raisemanface/gnss-signal-monitor/docs/接线表.md

# 双板接线表 + 彩色杜邦线配色方案（2026-10-15 · v2 按排线色序重排；2026-10-22 · v2.2 官方重排；2026-10-25 · v2.3 DS3231 接入；2026-10-26 · v2.4 背光改 GPIO7）

> **用途**：换标准彩色杜邦线时照这张表接；接完用最后一节的清单自检。
> **来源**：`README-交接（笔记本继续）.md` §5（权威接线表）+ `User_Setup_GNSS_Bench.h` +
> `TFT_eSPI/User_Setups/Setup_C3_CmdPad.h` + 两份固件里的引脚常量 —— **逐项核对过，非推测**。
> ⚠ 本表**取代** README §5 中"C3↔S3 链路 = GPIO8/5"那一段（2026-10-14 起链路脚已回 **C3 20/21**）。
>
> ★ **v2（2026-10-15 19:5x，用户指出）**：标准彩排线是**固定色序**，v1 里"蓝 / 绿 / 黑"这一组
> **在排线上根本不相邻**、物理上撕不到一起 ⇒ 整表**按排线色序重排**：
> **链路改成 白 - 黑 - 棕（黑居中屏蔽）**、**片选从 白 改 灰**。
> v1 的配色（蓝/绿链路 + 白片选）**全部作废**，不要再用。
>
> ★ **v2.1 补充（2026-10-15 20:5x）**：**S3 侧链路脚 38/39 → 43/44**（官方 U0 那对），
> 与 C3 的 20/21 配对 —— 见 §四。配色、根数、自检清单**均不受影响**（脚号与颜色是两回事）。
>
> ★★ **v2.2（2026-10-22，官方重排）**：S3 侧引脚按乐鑫官方焊盘功能重新落位，**动的只有 6 根**：
> ① 触摸 T_CS **9→14**（官方 FSPIWP 焊盘）；② SHT30 SCL **7→9**（官方 Wire 默认对 8/9）；
> ③ GNSS 模块 TXD **16→18**（官方 U1RXD）+ PPS **18→16**（对调）；
> ⑤⑥ 链路 **43/44 → 40/39**（把 U0 还给板载转串口芯片，Micro-USB 口解放）。
> 配色/色序**一根没变**，变的只是 S3 端落孔。图：`docs/接线图-S3-官方重排-2026-10-22.html`。
> ⚠ C3 板已换 DevKit（2026-10-22，COM5→COM7，MAC 变），**C3 侧 GPIO 编号与接线一根不动**（见 §三备注）。

---

## 一、先认识排线：10 色**固定色序**，而且首尾相接

一包标准彩色杜邦线（彩排线）是 **10 色固定顺序**，而且实际到手是**一束**（第 10 根与第 1 根相邻）：

```
棕(1) → 红(2) → 橙(3) → 黄(4) → 绿(5) → 蓝(6) → 紫(7) → 灰(8) → 白(9) → 黑(10) →（回到棕）
```

**这个顺序改不了**，所以配色不是"想给谁给谁"，而是 —— **先看排线，再把用途塞进排线已有的段落里**。
本表把 10 色切成 **三段**：

| 段 | 颜色（排线位次） | 用途 |
|---|---|---|
| **电源** | **红 (2)** | **+3.3V**，所有模块共用 |
| **信号** | **橙 (3)** · **黄 (4)** · **绿 (5)** · **蓝 (6)** · **紫 (7)** · **灰 (8)** | 全部信号线 —— **连续 6 根**，按模块撕取 |
| **链路 / 地** | **白 (9)** · **黑 (10)** · **棕 (1)** | **黑 = 全部 GND**；**白 + 棕 = C3↔S3 链路**两根信号线；**黑 夹在它俩中间** |

### 1.1 逐色对照表（背下这一张就够）

| 排线位次 | 1 | 2 | 3 | 4 | 5 | 6 | 7 | 8 | 9 | 10 |
|---|---|---|---|---|---|---|---|---|---|---|
| **颜色** | **棕** | **红** | **橙** | **黄** | **绿** | **蓝** | **紫** | **灰** | **白** | **黑** |
| **用途** | 链路② | +3.3V | 控制 DC/RES | 时钟 CLK/SCL | 数据出 MOSI/SDA/TX | 数据入 MISO/RX | PPS 秒脉冲 | 片选 CS/T_CS | 链路① | **GND** |

> ★ 一句话记法：**红电 · 橙控 · 黄钟 · 绿出 · 蓝入 · 紫秒 · 灰选 · 白棕链 · 黑地。**
>
> ★ **绿 / 蓝 = 方向，不是模块**：同一个模块上，**发给它的走绿、它发来的走蓝**（本机 TX = 绿、本机 RX = 蓝）。
>
> ★ **这三段为什么这么切（不是拍脑袋）**：
> 1. **黑 在排线上只与 白、棕 相邻** ⇒ 想让 **GND 夹在两根信号线中间**（屏蔽 C3↔S3 那对长线的串扰），
>    **只有 白-黑-棕 这一种选法**，其它任何组合都做不到。
> 2. **屏 SPI 的三根主干 CLK / MOSI / MISO = 黄 绿 蓝 = 排线上紧挨着的 3 根** ⇒ 撕一小段正好够，
>    而且**时钟（黄）正好夹在两根数据线中间**，对 20 MHz 的 SPI 更稳。
> 3. **红(2) 与 黑(10) 分别位于排线两端** ⇒ **"电源 + 地成组"物理上做不到**，只能让**电源独占 1 根**、
>    **地并进链路那一束**（每个模块的 GND 都走黑线，同一束里顺路走）。
>
> ⚠ **不同厂家偶有色序差异**（有的套装会多一根"青"）—— **以你手上那包的实物排列为准**，摊开看一眼再撕。

---

## 二、S3 台架（ESP32-S3-DevKitC-1 v1.1）

### 2.1 屏 ILI9341 + 触摸（SPI，6 + 2 根）

| 颜色 (位次) | 屏脚 | S3 脚 | 说明 |
|---|---|---|---|
| **黄** (4) | CLK | **GPIO12** | 时钟 |
| **绿** (5) | MOSI | **GPIO11** | 数据出 |
| **蓝** (6) | MISO | **GPIO13** | 数据入，**触摸要用这条回线，必须接** |
| **灰** (8) | CS | **GPIO10** | 屏片选 ★ v2：**白 → 灰** |
| **橙** (3) | DC | **GPIO6** | 数据/命令选择 |
| **橙** (3) | RES | **GPIO4** | 屏复位 |
| **白** (9) | BLK | **GPIO7** | ★ **v2.4（2026-10-26）背光改 PWM 调光，不再接 3.3V** —— P9 实验坐实：全亮 66 mA / 熄屏 0.3 mA（省 99.5%），`bl 0` 能真黑。旧写法「BLK→3.3V 常亮」**作废** |
| **灰** (8) | T_CS | **GPIO14** | 触摸片选 ★ v2.2：**9 → 14**（官方 FSPIWP 焊盘，与屏 SPI 集群 J1-16..20 连成一排） |
| — | T_IRQ | **不接** | 触摸中断，轮询方式；**实测两板均未接、运行正常（2026-10-16 定案）** |
| **红** (2) | VCC | **3V3** | **实测 3.3V 正常**（屏背光专线未接、显示正常 —— 2026-10-16 定案，见 §七.4） |
| **黑** (10) | GND | **GND** | |

### 2.2 GNSS 模块 ATGM336H-5N（UART1 + PPS）

| 颜色 (位次) | 模块脚 | S3 脚 | 说明 |
|---|---|---|---|
| **蓝** (6) | **TXD**（模块发） | **GPIO18** | 芯片的**入** ⇒ 蓝 ★ v2.2：**16 → 18**（官方 U1RXD 焊盘，J1-11） |
| **绿** (5) | **RXD**（模块收） | **GPIO17** | 芯片的**出** ⇒ 绿（只收不发时可不接；官方 U1TXD，不动） |
| **紫** (7) | **PPS** | **GPIO16** | 1Hz 秒脉冲 ⇒ 紫 ★ v2.2：**18 → 16**（与上行对调；换完三根在 J1-9/10/11 连续） |
| **红** (2) | VCC | **3V3** | **标称即 3.3V**（官方手册：2.7~3.6V，典型 3.3V，上限 3.6V；<25mA@3.3V）—— 2026-10-16 定案 |
| **黑** (10) | GND | **GND** | |

### 2.3 SHT30-D 温湿度（I2C）

| 颜色 (位次) | SHT30 脚 | S3 脚 |
|---|---|---|
| **黄** (4) | SCL | **GPIO9** | ★ v2.2：**7 → 9**（与 SDA=8 组成官方 Wire 默认对，J1-15） |
| **绿** (5) | SDA | **GPIO8** | 不动（J1-12） |
| **红** (2) | VCC | **3V3** |
| **黑** (10) | GND | **GND** |

> ⚠ SHT30 是 3.3V 器件，**别接 5V**。

### 2.4 DS3231 RTC 时钟模块（I2C 共总线 + SQW 1Hz）★ v2.3 新增，**待接线**（2026-10-26 到货）

| 颜色 (位次) | DS3231 脚 | S3 脚 | 说明 |
|---|---|---|---|
| **绿** (5) | SDA | **GPIO8** | 与 SHT30 **共总线**（0x68 vs 0x44，地址不冲突）——⚠ S3 的 8/9 两个孔要**一线两插**（叠插或焊，面包板孔松是已知教训） |
| **黄** (4) | SCL | **GPIO9** | 同上，同色同用途跟 SHT 对齐 |
| **棕** (1) | **SQW** | **GPIO15**（J1-8） | **1Hz 方波输出**（固件写控制寄存器清 INTCN 才出 1Hz，上电默认不出）——选 15 的理由：**紧挨 PPS=16(J1-9) 与 GNSS 集群**，五根线全落 J1-8~15 一片；⚠ 只进独立 GPIO 做**对照**，**严禁顶替/合流 PPS** |
| **红** (2) | VCC | **3V3** | ⚠ 到货先验充电回路（见下） |
| **黑** (10) | GND | **GND** | |

> ★ **电池与充电回路（到货先做）**：模块自带电池 = DS3231 的**走时备份**（主电断了我还能记时间）。
> 原配电池多为 **LIR2032（可充电）**——看电池面字样。3.3V 供电下充电回路（二极管+200Ω）基本不倒灌，
> 但仍要**通电实测**：量电池两端电压，若 >3.3V 且随通电升高 = 充电回路在工作，用 CR2032 时必须断开充电电阻。

### 2.5 板载 WS2812 彩灯

**GPIO48**，板载、**不用接线**，但**占一个脚**（换板子时要重新确认它在哪只脚上）。
> ★ v2.2 更正：按乐鑫官方手册，**v1.0 板灯在 GPIO48、v1.1 板灯在 GPIO38**（此前本表把两版写反了）。
> 本板实测灯在 48（2026-09-28）⇒ 按官方口径是 **v1.0**，板丝印版本待核。**GPIO38 也没接线、别当空脚乱用。**

---

## 三、C3 命令板（2026-10-22 起为 ESP32-C3 DevKit；脚号与 SuperMini 时代**完全一致**，接线一根不动）

### 3.1 屏 ILI9341 + 触摸（同一块屏，脚号与 S3 **全不同**）

| 颜色 (位次) | 屏脚 | C3 脚 | 说明 |
|---|---|---|---|
| **黄** (4) | CLK | **GPIO6** | |
| **绿** (5) | MOSI | **GPIO7** | |
| **蓝** (6) | MISO | **GPIO4** | 触摸回读用，必须接 |
| **灰** (8) | CS | **GPIO10** | ★ v2：**白 → 灰**；★ 与 S3 的 CS 撞号（两块板都恰好是 10） |
| **橙** (3) | DC | **GPIO3** | |
| **橙** (3) | RES | **GPIO1** | |
| **红** (2) | BLK | **3.3V** | 背光常亮 |
| **灰** (8) | T_CS | **GPIO0** | 触摸片选（避开 GPIO9=BOOT、GPIO8=LED）★ v2：**白 → 灰** |
| — | T_IRQ | **不接** | 轮询方式 |
| **红** (2) | VCC | **3V3** | |
| **黑** (10) | GND | **GND** | |

> ★ v2 重排后：**C3 侧一根白线都不用**（白/棕只出现在 C3↔S3 之间那三根上）。
>
> ⚠⚠ **别照板厂丝印接**：C3 SuperMini 丝印把 `IO4` 标成 SCK、`IO5` 标成 MISO、`IO6` 标成 MOSI、
> `IO7` 标成 SS —— 那是"建议命名"，**照它接必黑屏**（背光亮 ≠ 接线对，BLK 是硬接 3.3V 的）。
> **以本表为准。**
>
> ⚠ **GPIO8 = 板载 LED**（现做 2 秒心跳，不占排针、不用接线）；
> **GPIO9 = BOOT 键**（按下即接地，运行时别按）；**GPIO2 = strapping**（保持空）。
> 这三只**都不做接线**。
>
> ⚠ **C3 排针上 20/21 那两只孔偏松**（2026-10-14 实测教训）—— 换线时**优先把这两根直接焊上**，
> 不要再依赖面包板/杜邦插孔。

---

## 四、C3 ↔ S3 链路（UART 交叉线，★ v2 改色：**白 / 黑 / 棕**）

| 颜色 (位次) | C3 侧 | 方向 | S3 侧 |
|---|---|---|---|
| **白** (9) | **GPIO20**（RX，U0RXD） | ← | **GPIO40**（TX）★ v2.2：**43 → 40**（J3-8） |
| **黑** (10) | **GND** | ↔ | **GND** |
| **棕** (1) | **GPIO21**（TX，U0TXD） | → | **GPIO39**（RX）★ v2.2：**44 → 39**（J3-9） |

> ★★ **v2.2（2026-10-22，官方重排）**：S3 侧链路脚 **43/44 → 40/39**。动机：DevKitC-1 的
> **Micro-USB 口经板载转串口芯片接 U0（U0TXD=43/U0RXD=44）**，链路占着 43/44 就等于与 USB 桥
> 共享两条线（和 C3 新 DevKit 的 CH340K 占 GPIO20/21 是同一格局）。挪走后 Micro-USB 口整个解放。
> ⚠ **链路运行期间别往 S3 的转串口 COM 口敲东西**——桥片 TX 与链路信号会顶牛（C3 侧同理，COM7）。
>
> ★★ **2026-10-15 20:5x 变更（v1.5.23，历史）**：S3 侧链路脚曾从 **38/39 换回官方 U0 那对 43/44**。
> 当年"43/44 被 CP2102N 顶着、做不了外部输入"的结论**已被推翻** ——
> 真因是**面包板孔松**（用户改成焊线后 C3 20/21 一路立刻双向通）。2026-10-22 让出 43/44
> **不是它们不能用**，是官方重排要把 U0 还给桥片。
> ⚠ **换线时必须三根一起挪**：只改 S3 侧或只改 C3 侧都会直接断链。

> ★★ **这三根必须"白 - 黑 - 棕"挨着，且 黑 在物理中间** —— 它就是屏蔽 / 回流的那一根，
> 夹在两根信号线中间压串扰。**接的时候把黑线夹在中间走，别让它绕到外侧。**
>
> ★ **为什么 v1 的 蓝 / 绿 不能用**：蓝(6)、绿(5) 与 黑(10) 在排线上**隔着 紫(7) 灰(8) 白(9) 三根**，
> 撕不到一起 ⇒ **v1 那张表物理上做不到**。这是 v2 重排的直接原因。
>
> ⚠ **平铺排线的注意**：平铺时 棕 在第 1 根、黑 在第 10 根 —— 只有把 10 色**当一束（首尾相接）**看，
> 白-黑-棕 才是连续的三根。所以：
> - **按"束"取线** ⇒ 白-黑-棕 天然连续，黑居中，最省事；
> - **在平铺排线上撕** ⇒ 只能保证 **白-黑** 这两根真相邻，那 **棕 单独取一根**，
>   三根扎成一束时**把黑放中间** —— 效果完全一样。
>
> ★ **两端都要接对**（v2.2 起 S3 侧 = GPIO40/39，C3 侧仍是 GPIO20/21，**没有"只挪一端"这回事**）：
> 交叉原则 = **C3 的 RX(GPIO20) 对 S3 的 TX(GPIO40)**、**C3 的 TX(GPIO21) 对 S3 的 RX(GPIO39)**。
> 若接成"同名对同名"，两侧 RX 互连 ⇒ 两侧都不通，且现象像"线全断"，极具欺骗性。
> ⚠ **早期"43/44 不能用"的记录已作废**：那条结论来自 2026-10-11 的一次实测，当时的线插在**松掉的面包板孔**上。
> 2026-10-15 用户改焊线后，C3 20/21 一路当场双向通 ⇒ 归因纠正。**别再用"CP2102N 顶着"去否决 43/44**
> ——2026-10-22 起不用它们是"让给 USB 桥"，不是"不能用"。

---

## 五、要买多少根（v2 逐条重数）

| 位次 | 颜色（用途） | S3 用 | C3 用 | 链路 | 合计 | 建议买 |
|---|---|---|---|---|---|---|
| 1 | 棕（链路②） | — | — | 1 | **1** | 4 |
| 2 | **红**（+3.3V） | 4 | 2 | — | **6** | 10 |
| 3 | **橙**（控制） | 2 | 2 | — | **4** | 8 |
| 4 | **黄**（时钟） | 2 | 1 | — | **3** | 6 |
| 5 | **绿**（出） | 3 | 1 | — | **4** | 8 |
| 6 | **蓝**（入） | 2 | 1 | — | **3** | 6 |
| 7 | **紫**（PPS） | 1 | — | — | **1** | 4 |
| 8 | **灰**（片选） | 2 | 2 | — | **4** | 8 |
| 9 | 白（链路①） | — | — | 1 | **1** | 4 |
| 10 | **黑**（GND） | 3 | 1 | 1 | **5** | 10 |
| | **合计** | **19** | **10** | **3** | **32** | |

> ⚠ **v1 那张采购表有两处算错**（绿写成 6、蓝写成 5）。v2 按"**每根实际线数，一根算一根**"重数：
> S3 **19** 根 + C3 **10** 根 + 链路 **3** 根 = **32 根在役**（v1 写的 31 是错的）。
>
> **最省事的买法**：直接买 **10 色 × 各 10 根** 的整套（≈100 根）—— 本次只用 32 根，
> 剩下的全当备件，换错一根不用等快递。
> 单买的话每色至少 4 根，但 **红 / 黑 用量最大，各买 10 根**。
>
> **长度 10～15 cm**：屏 SPI 实测 20 MHz，飞线够短才稳（实测 20 MHz 是安全值，再长 / 再快容易花屏）。

---

## 六、换完线必做的自检（照做，别跳）

0. **先对排线**：把新买的线摊开，确认色序是不是 `棕红橙黄绿蓝紫灰白黑`（不同厂家偶有差异）；
   不一致就**按实物重排**再往下走。
1. **先拔掉两块板的 USB**，全部在断电状态下插线。
2. 插完**先量通断**：万用表蜂鸣档，红表笔在 A 端、黑表笔在 B 端，逐根确认"该通的通"。
3. **再量短路**（最容易出事的一步）：
   - **3.3V（红）↔ GND（黑）** 必须**不通**；
   - **3.3V（红）↔ 5V** 必须**不通**（接错会把 3.3V 器件烧掉）；
   - C3 的 **GPIO20 / GPIO21 各自 ↔ 相邻脚、↔ GND** 必须**不通**（这两只紧挨 5VIn/GND）。
4. **上电按 MAC 认板**（两块板 USB VID:PID 都是 `303A:1001`，光看口名分不出）：
   **S3 = `44:1B:F6:CE:F4:64`（COM4）**、**C3 = `80:53:e0:0a:52:2c`（COM7）**
   ★ v2.2（2026-10-22）：C3 已从 SuperMini（旧 MAC `E0:72:A1:68:92:FC` / COM5）换成 **DevKit**。
   烧错对象 = 把 C3 固件烧进台架，台架直接瘫。
5. **上电看两个自报**：
   - S3 串口开机横幅 `[bench] boot ok (v1.5.22: ...)`；
   - C3 串口 `[c3] pins: CLK6 MOSI7 MISO4 CS10 DC3 RST1 T_CS0 BLK3V3 | UART1: RX20 TX21 (GPIO20/21)`；
   - C3 屏右下角能看全版本号（**修完截断 bug 后**）。
6. 屏、触摸、温湿度、GNSS、链路各自验一遍（`docs/日志/2026-10-1x.md` 里有逐项话术）。
   **链路那一步**：C3 开机自检第 ③ 行应变成 `S3 ok (n ms)`；若显示 `NO LINK (retrying)` 而 S3 已上电
   ⇒ 查那三根线（白/黑/棕）与交叉关系。

---

## 七、确认记录（2026-10-16 用户逐项拍板，本表正文已同步）

| # | 项 | 结论 |
|---|---|---|
| 1 | **C3 的供电来源** | ✅ **定案：C3 独立用 USB 供电**（各插各的 USB）。不打算"只插一条 USB"，无需从 S3 拉 5V/GND 那两根线。 |
| 2 | **T_IRQ** | ✅ **定案：不接**。实测两块板（C3、S3）的触摸屏中断脚都没接，轮询方式运行操作未见异常。本表正文保持"T_IRQ 不接"。 |
| 3 | **GNSS 模块 VCC** | ✅ **定案：3.3V**。实测 3.3V 供电运行正常；标称值已核官方手册（ATGM336H-5N User Manual，立创商城 C90769 原档）：**VCC 工作范围 2.7 ~ 3.6 V，典型 3.3 V，绝对上限 3.6 V；典型功耗 <25 mA@3.3V**。3.3V 正是标称值，不是"能用而已"。 |
| 4 | **屏的 VCC** | ✅ **定案：3.3V**。用户实测：屏 VCC 用 3.3V、**背光专线未接**，显示正常（该模块背光大概率板载取电；本表 BLK→3.3V 那行保留为推荐接法，若日后出现"屏暗"先接回这条）。 |
| 5 | ~~固件源码里的一行注释~~ | ✅ **已办（2026-10-15 20:5x，C3 v1.0.0 / S3 v1.5.23 同批）**：C3 头部注释里的"（蓝线）/（绿线）"已改成 **白 / 棕**，S3 侧脚号也同步成 43/44 |
