raisemanface/gnss-signal-monitor/docs/images/sky-picked.png

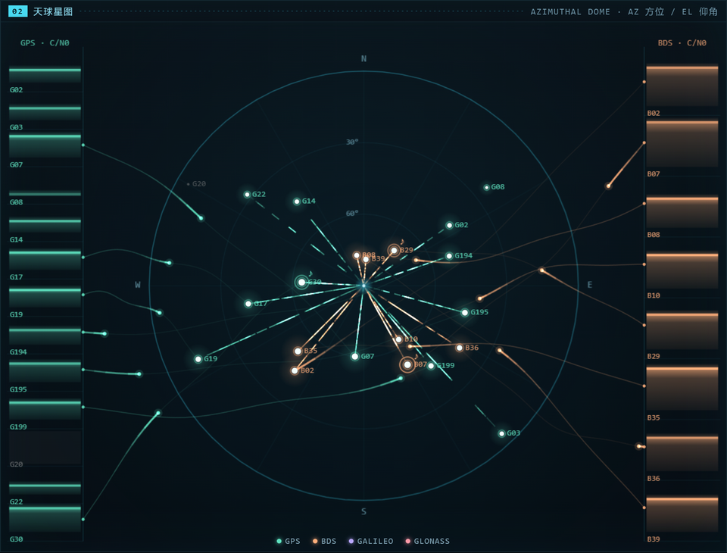
docs/images/sky-picked.png
