raisemanface/gnss-signal-monitor/firmware/GNSS_Bench/GNSS_Bench.ino

// ============================================================================
//  GNSS 台架演示固件 —— 单文件版 v4(板载 RGB 灯 + 触摸屏)
// ----------------------------------------------------------------------------
//  一台"看得见状态翻转"的桌面验证台架,不是产品样机。
//
//  硬件:ESP32-S3 开发板(用板载 WS2812 彩色灯) + ATGM336H-5N + 2.4" ILI9341 触摸屏
//        + SHT30-D 温湿度(I2C:SCL=GPIO9 / SDA=GPIO8,走核心自带的 Wire,不用装库)
//          ★ 屏的 BLK 本项目直接接 3.3V 常亮,不占 IO —— GPIO7 就是这么空出来的
//  环境:Arduino IDE,开发板选 "ESP32S3 Dev Module",库只装 TFT_eSPI
//        板载彩灯走 Arduino-ESP32 核心内置函数,不用再装 Adafruit NeoPixel
//        (核心 2.x 老版本才需要,见文件顶部 LED_USE_BUILTIN 开关)
//  用法:
//    1) 先按 User_Setup_GNSS_Bench.h 把屏的引脚挂进 TFT_eSPI —— 那一步不做,屏不亮
//    2) 把这个 .ino 放进一个同名文件夹,直接编译烧录
//
//  引脚:全部照抄自已交付项目 RF_Source_Controller 的实测接线,不是猜的。
//        固件里有编译期自检,User_Setup 引脚对不上会直接编译报错,不用烧进去试。
//
//  指示 (★★ v1.7.0 主界面整块重排 —— 下面是**现行**口径,别照旧版注释去找色带/边框):
//    屏上  240x320 竖屏,三段式:
//      y   0..239  星空图区 —— 圆盘 R80(30/60° 细分圈 + 十字准线;星点按仰角/方位角落点,
//                  点径与颜色由 C/N0 和星座定)+ **最外圈 2px 状态光环**(R83/84)
//                  + 四角 HUD 块 92x32(左上 日期/时间、右上 纬度/经度、
//                    左下 温度/湿度、右下 漂移/HDOP)+ 顶部正中 WiFi 图标(4 段弧)
//                  ★ 状态色**只体现在那一圈光环**和数据条的状态词上(绿=INTEG OK /
//                    黄=DEGRADED / 橙=SIG-BAD / 红=POS-BAD / 红闪=LOST / 灰=SEARCH·NO-DATA /
//                    **紫=HPL-HIGH** ★ v1.9.0 新增的第三态 /
//                    **琥珀=DRIFT** ★ v1.10.1 新增的"慢漂移"态)
//                    —— 原来那圈"顶部 100px 色带 + 全屏 3px 边框"v1.7.0 已删除
//      y 240..273  按键条 —— 4 键等宽 60px:BASE / CLR-BS / CHARTS / LOG(★ v1.9.0 高 40->34)
//      y 274..319  数据条 —— 左:FONT4 状态词(居中);右三行:HPL / CN0 / SAT(★ v1.9.0 40->46)
//      ★ 报文窗**不再常驻**:在数据条上长按 ≥1s 切出 8 行报文窗(再长按切回;v1.10.6 取整)
//      ★ 深色主题:页底 #0C0F13,卡面 / 面板 / 按键三级深灰,文字两级灰白 —— 一处常量定义全局引用
//      ★ 全英文界面:内置 FONT4(Font32rle)是唯一含完整 96 ASCII 的大字模,
//        原来的 32x32 中文字模(cnfont)v1.7.0 已整段删除(省 ~2.7KB flash + 2KB RAM)
//    板上  那颗 WS2812 同步同色 —— 远处看灯,近处看屏
//          ★ 灯和光环取的是同一个 statusColor565(),所以改配色只改那一处,
//            灯自动跟着变,不存在"屏改了灯没改"的可能。
//          ★ 它挂在 **GPIO48**,是**占掉一个脚**的。"板载"不等于"免 IO"。
//            好在你台架的脚位(GNSS 16/17/18、屏与触摸 4/6/9/10/11/12/13、I2C 7/8)
//            一个都没用 48,所以对你来说等于白捡一颗灯。
//
//  六个页面 (★ v1.7.0 从 2 页扩到 4 页;★ v1.10.0 加 PARAMS / 编辑两项;
//             各页 sprite 互斥,**峰值只占一份** 153,600 B):
//    主界面    星空图 + 按键条 + 数据条                       (两块 sprite:240x240 + 240x80)
//    第二界面  CHARTS 动图页 —— 每星 C/N0 竖条 / C/N0 中位曲线 / INTEGRITY 保护级 /
//              DETECTORS(CUSUM + 多径)(四张 234x64/64/76/79;★ v1.9.0 删掉定位漂移盘;
//              ★ v1.10.1 按内容重新配平:两张图各让 16px 给下面两张算法卡,
//              INTEGRITY 卡新增一行 `OFF .. / LIM ..` —— 现场能直接看出是"距离越线"
//              还是"慢漂移",而不是只看到一个 POS-BAD 干瞪眼)
//    第三界面  EVENT LOG —— 事件列表 10 行 x 22px + 底栏统计摘要,可上下滑动翻页
//    第四界面  事件详情 —— 单条事件的类型/时刻/持续/偏离 + 事件开始那条 GGA 原文
//    第五界面  ★ v1.10.0 PARAMS —— 八个可调阈值(判据类六个 + 迟滞两个),点行进编辑
//    第六界面  ★ v1.10.0 单项编辑 —— 大字当前值 + 刻度条(只指示)+ `-5/-1/+1/+5` 四键
//    ★ BACK 按钮几何**全局一处**(BACK_X/Y/W/H),第二~六界面共用同一组;
//      第四界面 BACK 回**第三界面**,第六界面(BACK/DONE)回**第五界面**;
//      第五界面 BACK 回**主界面**(不回来路 —— 调完参数就是想看主界面反应)。
//
//  控制(两条路并存,互不影响):
//    点屏  星空区 y 0..239  -> 无动作(误触安全 —— 比旧版"点顶部就改基准"安全得多)
//          按键条 y 240..273 -> x 四等分:BASE / CLR-BS / CHARTS / LOG
//          ★ v1.8.3:第 2 键原来叫 INJECT,**按住 5 s** 才生效(短按只打一行日志)——
//            防误触。生效后该键亮绿,表示"当前没有基准"(与 BASE 的 SET 绿互斥:
//            同一时刻只有一个键是绿的)。见 touch::poll / disp::btnState。
//          ★ v1.10.6:第 3 键 CHARTS **按住 5 s → 参数页**(短按仍是第二界面);与 CLR-BS 统一。
//            进度条与 CLR-BS 同一套观感,阈值也统一 5 s(用户定,一致性优先)。
//          数据条 y 274..319 -> **长按 ≥1s** 切报文窗 / 切回(短按无动作;v1.10.6 取整)
//          ★ v1.7.0 起**动作一律在"抬起"时执行** —— 只有抬起才能分辨"点击"与"滑动";
//            旧版在"刚按下"时就动作,分不出滑动。
//    串口  115200,输入单字符回车
//      b = 把当前坐标存为基准(★ v1.7.0 起**会落盘**:写 NVS `gnsjudge/base`,重启自动恢复)
//      c = 清除基准(连 flash 里那份一起擦)
//      ★ v1.8.3:"注入"功能**整套删除**(用户 2026-10-17 定 —— 不再做演示)。
//        原来这里还有 `i = 切换注入偏移:比对坐标偏离基准 120 m`,连同判据里的
//        偏移坐标、屏上第 2 键的 INJECT 态、C3 菜单的 INJECT 项一起删干净。
//        屏上第 2 键改为 **CLR-BS(清基准),按住 5 s 才生效**。
//      s = 立即打一行状态
//      t = 立刻读一次温湿度(不等自动的 2 秒节拍,现场查接线用)
//      g = PPS 观测:两行 —— 第 1 行是最近一拍(仅参考),第 2 行是**自开机起的积分平均**,
//          积分那行才是能当结论的 ppm(单拍只有 1us 分辨率 = ±1ppm 噪声)。
//          未定位时模块不出 PPS。
//      (原 1/2/3/0 = 模拟信源开关 —— ★ v1.7.0 整段删除,见下面"第 1.5 段"的说明)
//      v = S3 日志页开关(★ v1.8.0 改义 —— 原来是串口日志开关;C3 的 LOG 键要的是屏上日志页)
//      d = 切第二界面「动图页」(与"点按键条 CHARTS"完全等价)
//      w = WiFi 存档:wadd <ssid> <pass> / wseed <ssid> <pass> / wtry [n] / wlist / wdel <n> / wconn [n] / wscan
//          ★ `wtry` —— C3 的 PUSH 收尾发它:从 #1 起挨个试连,连上即停、失败跳下一条。
//          ★ `wscan` —— **异步**扫一遍周边热点,结果分条直发 C3 命令板,
//            是"WIFI / S3 / SCAN"的服务端。自己屏上不显示列表(那是 C3 的活)。
//      r = 清触摸校准(清的是 **S3 这台** 的触摸;C3 命令板有它自己那套)
//      p = ★ v1.10.0 **参数表**:打印 PARAMS 页那八个数(值 / def / 范围 / 步长 / 改过哪几项)
//      k = ★ v1.10.2 **演示注入**(电脑替手指按屏,演示录屏用):
//            kt <x> <y>                  点一下(120 ms)
//            kh <x> <y> <ms>             长按 ms 毫秒(kh 150 257 1800 = 进参数页)
//            ks <x1> <y1> <x2> <y2> [ms] 划动(默认 400 ms;翻页手势)
//          坐标 = 屏绘图坐标(0..239 / 0..319)。合成值在 poll() 里**替代** getTouch 的
//          返回值 ⇒ 下游全是原路径,按键高亮 / 长按走条 / 滑动都是真的。
//          **不进链路白名单**,C3 发不进来(只有电脑 USB 串口能敲)。
//      ? = 帮助 —— 共 **17 条**
//      ★ 已删除(别找了):l = 试灯(选脚任务早已完成,且会让画面停 8 秒)、
//                        i = 注入偏移(v1.8.3 整套删)。
//      ★ 注:`p` 这个字母在 v1.8.3 曾随"坐标链路打印"一起删掉,v1.10.0 拿回来
//        改作参数表 —— 语义完全无关,只是复用字母。
//      ★ 第三/四/五/六界面(事件列表 / 详情 / 参数 / 编辑)**没有专用串口入口** ——
//        `d` / `v` 只能切到第二 / 三界面;要进更深的那几层,用 `k` 注入坐标
//        (v1.10.2 起):长按 CHARTS → 参数页,点列表行 → 详情。
//
// ----------------------------------------------------------------------------
//  ★ 版本沿革(v1.5.10 → v1.5.25 的**完整**改动记录,含每次为什么改)见
//    docs/变更记录-S3.md —— 文件头只留**现在有效**的口径,历史过程不再堆这里。
// ----------------------------------------------------------------------------
//  ★★ 现行口径(改代码前先读这一段)★★
//   ① **与 C3 的链路走 `UART2(Serial2)`**,脚位 **GPIO39(RX) / GPIO40(TX)**
//      (2026-10-22 官方重排:U0 那对 43/44 让还给板载转串口芯片,J3-9/J3-8 相邻),
//      与 C3 的 GPIO20/21 配对。
//      ⚠ **不能用 `Serial1`** —— 那是 UART1,被 GNSS 模块的 `port(1)` 占着(17/18):
//        换脚会让 GNSS 收不到数据、C3 的命令被 gnss::poll() 当 NMEA 吃掉(v1.5.11 踩过)。
//      ⚠ 沿革:43/44 曾被判"被板载 CP2102N 顶着、做不了"(已推翻,真因是面包板孔松),
//        v1.5.23~v1.10.2 曾用回 43/44;2026-10-22 官方重排**主动让出**(不再与 USB 桥
//        共享),38/39 那段更早的历史一并作废,别再照旧注释接线。
//   ② **链路协议**:收 `@k <payload>`、回 `@s ok <payload>`。S3 只认 `@k ` 前缀;
//      收到后取**首字符**交给 `consoleKey()` —— 与电脑串口**同一份分派**(链路侧有
//      白名单 `linkKeyAllowed()`,新增可远程触发的命令要同步登记,见 benchlink::poll)。
//   ③ **编译必须带 `PSRAM=opi`**,且本目录 `build_opt.h`(一行 `-DCONFIG_SPIRAM_SUPPORT`)
//      必须保留 —— 漏任一个,动图页的全屏 sprite 会落回内部 RAM 而进不去。
//      另:`User_Setup_GNSS_Bench.h` 里 **USE_DMA 必须保持关闭**(开了就走不了 PSRAM 分支)。
//   ④ 命令共 **17 条**(★ v1.10.2 加 `k` 演示注入:16 -> 17;★ v1.10.0 加 `p` 参数表:15 -> 16;
//      ★ v1.8.3 删 `i`:16 -> 15。敲 `?` 打印;与 README 命令表同一份清单)。
//   ⑤ **双轨版本号**:升版依据唯一 = "完成一轮用户确认的改动 → 号 +1";
//      MAJOR 只在换硬件/改协议时动。规则见 AGENTS.md「版本号规则」。
//   ⑥ 板载 WS2812 彩灯挂 **GPIO48** —— "板载"不等于"免 IO",换板子要重新确认。
//   ⑦ **NVS 命名空间**(v1.7.0 起共四个,**互相独立、别合并**):
//        `wifi10`    WiFi 台账(最多 10 条,FIFO 覆盖最旧)  ← 沿用旧名,别改(一改台账即丢)
//        `gnstouch`  触摸校准 5 点 + cal_flag
//        `gnsjudge`  判据基准 `base`(28 字节 blob,带 magic 'GSJ1' + 版本 + 范围校验)
//        `gnsevt`    事件日志 ev00..ev499 + `stat` + `seq`
//      ⚠ 判据基准和触摸校准**曾经共用一个命名空间**,而 judge::clearBase() 里是
//        prefs.clear() —— 会连校准值一起抹掉。分开就是因为这个。
//      ⚠ 新增命名空间时:判断一下有没有别的 `prefs.clear()` 会扫到它。
//   ⑧ **★★ 整块 sprite 的绘制入口,第一件事必须是「填页底色」** ——
//      `skySpr->fillSprite(CLR_PAPER)` / `botSpr->fillSprite(CLR_PAPER)`。
//      这类函数只覆盖"它自己关心的那几块",**没覆盖到的像素留的是上一帧/上一页的内容**:
//        · 报文窗与"按键条+数据条"**共用 botSpr** ⇒ 切回按键条不填底 = 8 行 NMEA 原文
//          横贯整条数据条(就压在状态大英文上下);
//        · 四个按键块之间那 2px 页底缝、以及数据条"只画字不铺底" ⇒ 上一次更长的状态词
//          (DEGRADED -> NORMAL)会在两侧留下字尾。
//      症状统称"屏上有不干净的显示",而且**不报错、不崩、串口一切正常** —— 只能靠眼睛。
//      v1.7.2 修过一次(paintBot 漏了 fillSprite);`paintSky` 从 v1.7.0 起就是对的。
// ----------------------------------------------------------------------------

//
//  完整交接说明见项目根目录:README-交接（笔记本继续）.md
//
//  代码分段,按顺序读就是完整的数据流:
//    ★ 配置区 -> 1 收 -> 2 解 -> [状态词表] -> 3 判 -> 灯 -> 4 显(主界面)
//       -> 4.2 动图页(CHARTS) -> 4.3 事件日志(EVENT LOG) -> 页面切换(ui)
//       -> 触摸 -> 4.5 屏面镜像报文 -> 5 主循环
// ============================================================================

// ---- 板载 WS2812 彩灯的驱动方式 —— 必须在下面 #include 之前定下来 ----
//   1 = 用 Arduino-ESP32 核心内置的 rgbLedWrite(),**一个库都不用装**(核心 3.x 走这条,推荐)
//       官方头文件 cores/esp32/esp32-hal-rgb-led.h 里:
//         void rgbLedWrite(uint8_t pin, uint8_t r, uint8_t g, uint8_t b);
//         void neopixelWrite(...);   // 旧名,已标 deprecated,仅作向后兼容保留
//       所以核心 3.x 用 rgbLedWrite,核心 2.x 用 neopixelWrite,两条都在下面的代码里写好了。
//   0 = 用 Adafruit NeoPixel 库,核心 2.x 老版本可走这条,需要在库管理器里装库
#define LED_USE_BUILTIN  1

#include <Arduino.h>
#include <TFT_eSPI.h>
#if !LED_USE_BUILTIN
  #include <Adafruit_NeoPixel.h>
#endif
#include <Wire.h>            // SHT30 温湿度走 I2C,核心自带,不用装库
#include <esp_system.h>      // esp_reset_reason():查"这次开机是被谁弄醒的"(见第 5 段)
#include <WiFi.h>             // v1.5.6:WiFi 存档/连接(核心自带)
#include <WiFiUdp.h>          // ★ v1.14.5:UDP 推流到 PC 看板(核心自带,零第三方)
#include <esp_heap_caps.h>   // v1.5.16:heap_caps_get_largest_free_block —— 临时内存探针用
#include <esp_wifi.h>        // v1.5.16:esp_wifi_deinit() —— 扫描收摊时真正释放射频驱动内存
#include <Preferences.h>
#include <LittleFS.h>        // ★ v1.14.1:obs 观测流落盘(挂 spiffs 分区 8.875 MB)。核心自带,零第三方
#include <math.h>
#include <stdio.h>
#include <stdlib.h>
#include <string.h>

// ---- RTC 慢时钟源探针(2026-10-01 加)---------------------------------------
//  ESP32 内部有**两套互不相干**的时钟,这是回答"板子上到底有没有晶振"的关键:
//    · 40MHz 主晶振 —— 在 WROOM 模组的**金属屏蔽罩里面**,板子表面根本看不见。
//      它驱动 CPU / micros() / millis(),精度 ±10~30ppm(1 小时最多差 0.1 秒)。
//    · RTC 慢时钟 —— 驱动 time() / gettimeofday() / 深度睡眠计时。
//      **默认走片上内部 RC(~136kHz,±5% ≈ 5 万 ppm,1 小时可差 3 分钟!)**。
//      只有外挂了 32.768kHz 晶振才会读到 ~32768Hz。
//  两者差 4 倍,一读就能分清,不用拆板子、不用猜。
//  用 __has_include 兜底:核心若没有这两个头文件就自动跳过,绝不拖累编译。
#if __has_include("esp_clk_tree.h") && __has_include("soc/clk_tree_defs.h")
  #include "esp_clk_tree.h"
  #include "soc/clk_tree_defs.h"
  #define HAVE_CLK_TREE 1
#else
  #define HAVE_CLK_TREE 0
#endif

// ESP_ARDUINO_VERSION_MAJOR 用来在 rgbLedWrite(核心 3.x)与 neopixelWrite(核心 2.x)之间二选一。
// 这个宏由核心的 esp_arduino_version.h 提供,并非所有版本都会从 Arduino.h 透出来,这里显式带上。
// 万一某个分支没有这个头文件也不影响 —— 退回 2.x 分支,而 neopixelWrite 在 3.x 里同样还在。
#if defined(__has_include)
  #if __has_include(<esp_arduino_version.h>)
    #include <esp_arduino_version.h>
  #endif
#endif

// ============================================================================
//  ★ 配置区 —— 要改的东西全在这里
// ============================================================================

// ---------------- 引脚 ----------------
// 接法(2026-10-22 官方重排:落芯片官方 UART1 焊盘 U1RXD=18 / U1TXD=17;沿革 09-30~10-21 用 16/17):
//   模块 TXD --> ESP32 GPIO18 (U1RXD)   模块 RXD --> ESP32 GPIO17 (U1TXD)
//   模块 PPS --> ESP32 GPIO16           模块 VCC/GND 另接
// ★ 交叉接线:模块的"发"接芯片的"收"。名字容易绕,以"信号流"为准:
//   GPS 数据流方向  TXD(模块) ──> GPIO18 ──> UART1 接收
constexpr int PIN_GNSS_RX    = 18;   // ESP32-S3 U1RXD(官方焊盘,J1-11) <-- 模块 TXD
constexpr int PIN_GNSS_TX    = 17;   // ESP32-S3 U1TXD(官方焊盘,J1-10) --> 模块 RXD(只收不发可不接)
constexpr int PIN_GNSS_PPS   = 16;   // 模块 PPS(1Hz 秒脉冲) --> 用于校时/驯服,见 pps 段

// ---- DS3231 RTC 的 SQW 1Hz ----
// ★ v1.14.0:必须与 PPS 分两个脚、各进各的中断 —— 这是整套方案的地基。
//   合到一路(或让 SQW 顶替 PPS)就等于"让备份顶掉尺子":GNSS 的 PPS 一丢,
//   中断里照样每秒有沿,检测器永远以为 PPS 是好的 —— 和"哨兵从不报警"
//   是同一条死法。接线表 v2.3 §2.4。
//   选 15 的理由:紧挨 PPS(16)与 GNSS 那组,五根线全落 J1-8~15 一小片。
constexpr int PIN_DS3231_SQW = 15;   // DS3231 SQW(1Hz 方波) --> 与 PPS 的相位差,见 ds3231 段

// ---- 屏幕 ----
// ★ 这里不写死脚号,直接引用 User_Setup.h 里的宏(已随上面的 <TFT_eSPI.h> include 进来)。
//   TFT_eSPI 初始化读的就是那几个宏,固件跟着用同一份 —— 从根上不可能不一致。
//   所以原来那串 "#ifdef TFT_xx + static_assert(两份拷贝是否相等)" 全部删了:
//   与其写 8 条代码去守"两份拷贝相等",不如压根只留一份。
//
//   屏引脚(仅供人读 —— 真值在 User_Setup 里,固件不再重复定义一份):
//     CLK=12  MOSI=11  MISO=13  CS=10  DC=6  RES=4   BLK->3.3V
//
//   ★ 2026-10-15 删除:PIN_TFT_SCLK / MOSI / MISO / CS / DC / RST 六个**镜像常量**。
//     它们值永远对(就是 TFT_eSPI 的宏),但**全文没人引用** —— 真引脚在
//     `TFT_eSPI/User_Setups/Setup_*.h` 里,读代码的人却会以为"改这里就能改引脚"
//     (本项目正踩过"改了定义、杜邦线还插在旧孔上")。**引脚清单只留上面那行 +
//     `docs/接线表-双板与彩色杜邦线配色.md` 那一份。** PIN_TFT_BL 例外(它真被用)。

// ---- 背光 ----
// ★ 本项目实测:屏的 BLK 直接接 3.3V 常亮,**不占 IO**,所以默认不驱动任何脚。
//   这份引脚表是从另一个项目沿用的,那边背光走 GPIO7。2026-10-22 官方重排后
//   SHT30 的 SCL 挪到 GPIO9(官方 Wire 默认对),GPIO7 彻底空闲 —— 哪天改成
//   GPIO 控背光,把 BLK 挂到 7 是现成的候选(仍要先查与台架其它线不冲突)。
#define TFT_BL_ON_GPIO    1          // ★ 2026-10-24:0→1(BLK 已接 GPIO7;需 User_Setup 定义 TFT_BL)
                                     // 0=背光直连 3.3V 常亮(本项目)
#if TFT_BL_ON_GPIO
  #ifndef TFT_BL
    #error "TFT_BL_ON_GPIO=1,但 User_Setup 里没有 #define TFT_BL —— 背光脚无处可寻。补上它,或把本开关改回 0。"
  #endif
  constexpr int PIN_TFT_BL = TFT_BL;
#else
  constexpr int PIN_TFT_BL = -1;   // 不驱动。disp::begin() 里的背光段整体被 #if 关掉
#endif

// ---- SHT30-D 数字温湿度(I2C) ----
// 驱动走 ESP32 核心自带的 Wire,**不用装任何库**。
// 接线:VCC->3.3V   GND->GND   SCL->GPIO9   SDA->GPIO8
//      (2026-10-22 官方重排:SDA=8/SCL=9 正是 Arduino-ESP32 S3 的 Wire 默认对;
//       沿革 09-30~10-21 SCL 在 GPIO7)
// 市面上卖的基本都是模块,板上已带 4.7k 上拉;若是裸芯片,SDA/SCL 各要一只 4.7k 上拉到 3.3V。
constexpr int PIN_SHT_SCL    =  9;
constexpr int PIN_SHT_SDA    =  8;

// ---- 触摸(XPT2046,屏上直接点,省得敲笔记本) ----
// 片选 TOUCH_CS / 中断 TOUCH_PEN 由 User_Setup 定义、TFT_eSPI 自己用,固件不碰,故不在这里重列。
// 当前接线:T_CS=GPIO14(官方 FSPIWP 焊盘,与屏的 SPI 集群 J1-16..20 连成一排),
//          T_IRQ=GPIO5(轮询方式,不接也行)。沿革 09-30~10-21 T_CS=GPIO9(已让给 I2C SCL)。
// 注意:这个开关必须是宏(#define),不能用 constexpr —— 下面要拿它做 #if 判断。
#define ENABLE_TOUCH  1              // 1=开触屏控制  0=只用串口命令

// ★ v1.12.0(A5):演示注入(kt/kh/ks)编译开关。默认开 —— 这是 v1.10.2 拍板的既定
//   演示功能,默认关会让演示脚本失效;但插个串口就能长按清基准,公开场合/交接后
//   可改 0 重编,命令自然变成"未知命令"。包住:touch::inj 整段 + consoleKey case 'k'
//   + 帮助行 + touch::poll 里的注入采样点(四处,均有 #if 守护)。
#define ENABLE_INJ   1

// ★ v1.12.0(A14):熄屏期间的全局屏状态(定义放最前 —— led::apply 在 disp 之前就要读它)。
//   true = 屏已 SLEEP IN 且背光 0,一切推屏/绘制停;保留 gnss/judge/sht/事件落盘/PPS。
static bool gScreenOff = false;
constexpr bool kLedFollowScreen = true;   // 熄屏时板载 WS2812 一并灭(用户定"不表达状态");
                                          // 将来想"灯常亮、屏可灭"改 false 即可

// ---------------- 编译期自检 ----------------
// 思路换了一下,所以条数从 8 条降到 3 条:
//   原来的 8 条守的是"固件里抄的引脚表 == User_Setup 里的引脚表"(两份拷贝是否相等)。
//   现在固件不抄了、直接引用宏,那两个值天然相等,断言没意义 —— 删。
//   但还有一件真正要守的事:**当前生效的 User_Setup 是不是实物对应的那一份**。
//   挂错配置(或没在 User_Setup_Select.h 里选中)的后果是 GPIO 全不对、屏根本不亮,
//   看起来却像固件坏了,极难查。台架接线是焊死的物理事实,所以照它查一次,一次管全部。
static_assert(TFT_SCLK == 12 && TFT_MOSI == 11 && TFT_MISO == 13 &&
              TFT_CS   == 10 && TFT_DC   ==  6 && TFT_RST  ==  4,
              "当前生效的 User_Setup 引脚不是台架接线(应为 CLK12 / MOSI11 / MISO13 / CS10 / DC6 / RES4)。"
              "多半是 User_Setup 没挂对或没选中 —— 见 User_Setup_GNSS_Bench.h 顶部的三步说明。");

#if ENABLE_TOUCH && !defined(TOUCH_CS)
#error "ENABLE_TOUCH=1,但 User_Setup 里没有 #define TOUCH_CS —— 触摸驱动根本没编进来。要么在 User_Setup 里打开 TOUCH_CS,要么把 ENABLE_TOUCH 改成 0。"
#elif ENABLE_TOUCH
static_assert(TOUCH_CS == 14, "触摸片选不是 GPIO14 —— 与台架接线(2026-10-22 官方重排)不符,先检查 User_Setup 挂对没有。");
#endif

#if TFT_BL_ON_GPIO && defined(TFT_BL)
static_assert(TFT_BL != PIN_SHT_SCL,
              "背光脚和 SHT30 的 SCL 分到了同一个脚 —— 一个脚不能既驱动背光又跑 I2C。"
              "改 User_Setup 里的 TFT_BL,或者给 SHT30 的 SCL 换一个脚。");
#endif

// PPS 是中断输入脚,和 I2C 的两条线不能撞(撞了秒脉冲会打断 I2C 时序,读数开始随机失败)。
static_assert(PIN_GNSS_PPS != PIN_SHT_SCL && PIN_GNSS_PPS != PIN_SHT_SDA,
              "PPS 脚和 SHT30 的 I2C 线(SCL=9 / SDA=8)撞了 —— 秒脉冲会打乱 I2C 时序。换个脚接 PPS。");

// ★ v1.14.0:SQW 是**第二个**中断脚,三条规矩一起写死在这里。
//   ① 不许撞 PPS —— 撞了就是"备份顶掉尺子",GNSS 失锁也照样每秒有沿;
//   ② 不许撞 I2C —— 同上,SQW 沿会打断 I2C 时序;
//   ③ 不许撞 TFT_BL —— 那会让背光一秒钟闪一次(而且 ISR 里读不到屏)。
static_assert(PIN_DS3231_SQW != PIN_GNSS_PPS,
              "DS3231 的 SQW 和 GNSS PPS 接了同一个脚 —— 等于让备份顶替尺子(PPS 丢了也照样有沿)。必须分两个脚。");
static_assert(PIN_DS3231_SQW != PIN_SHT_SCL && PIN_DS3231_SQW != PIN_SHT_SDA,
              "DS3231 的 SQW 和 I2C 线撞了 —— 秒脉冲会打乱 I2C 时序。换个脚。");
#if defined(TFT_BL)
static_assert(PIN_DS3231_SQW != TFT_BL,
              "DS3231 的 SQW 撞上了背光脚 —— 背光会每秒闪一次。换个脚。");
#endif

// ---------------- 板载 WS2812 彩色灯 ----------------
// ★ 先纠正一个常见误解:板载彩灯**是占一个 GPIO 的**,不是"不占 IO"。
//    它是 WS2812(单总线可寻址灯),数据线必须挂到一个脚上:
//      官方 ESP32-S3-DevKitC-1  v1.0 → GPIO48(乐鑫官方用户手册口径)
//      官方 ESP32-S3-DevKitC-1  v1.1 → GPIO38(同上;★ 2026-10-22 对照官方手册纠正 —— 原来这两行写反了)
//      国产 N16R8 / 克隆板常见        → GPIO48(也有 38 / 21 / 47)
//    "板载"只代表不用外接线,不代表不花脚位。好在你台架的脚位表里没有 48,等于白捡。
//
// ⚠ 有些板子的 RGB 数据线出厂是**断开**的:灯旁边有一对丝印为 "RGB" 的小焊盘,
//    要用锡短接后才连到 GPIO48(少数板子出厂已短接)。没短接的表现是:
//    程序烧录正常、屏也正常,就是灯不亮 —— 别怀疑代码,先看那对焊盘。
//
// 灯的实际脚位本项目**已经查清**:本板实测灯亮在 **GPIO48**(2026-09-28 实测)
// ⇒ 按官方口径这块板是 **v1.0**(v1.1 的灯在 38;板丝印版本待核,2026-10-22 标注),
// 代码里就是 LED_RGB_PIN = 48。以前那条 'l' 试灯命令(v1.5.10 已删)是当初"不知道
// 灯在哪"时的临时手段,现在脚位是已知事实,不再需要。若哪天换了板子要重新找,
// 若颜色反了(该显红却显绿),说明这颗灯的色序不是 GRB,见下面 led::writePix 里的注释。
constexpr int LED_RGB_PIN = 48;
constexpr int LED_BRIGHT  = 60;      // 0~255,WS2812 全亮很刺眼,60 足够看清

// ---------------- 串口 ----------------
constexpr long GNSS_BAUD      = 9600;  // ATGM336H 出厂常为 9600 8N1(首选,见下面 kViableBauds)
constexpr int  NMEA_LINE_MAX  = 100;   // 单行最大字符数
constexpr int  NMEA_POOL      = 24;    // 环形缓冲保留行数

// ★ v1.14.11:**波特率自寻**。
//   现场(2026-10-31)踩到的坑:板子断电放了一段时间再上电,模块配置掉回出厂
//   **115200**,而固件一直按 9600 听 —— 收进来的全是采样错的乱码(byte 计数在涨、
//   totalLines 恒 0、一颗星都没有),屏上一直 NO-DATA,看着像模块坏了 / 像固件改坏了。
//   实测同一根线换 115200 立刻是完整 NMEA($GNGGA/$GNRMC/$GPTXT,ANTENNA OK)。
//   结论:**模块的波特率是"会变的外部状态",不能写死在固件里**。
//   做法:首选 9600;连续 3 s 一条有效报文都没有,就按序换下一个再听 2.5 s。
//   收到报文即锁定,不再折腾。整轮 5 档 ≈ 15 s,开机多花十几秒,换来"永远不用管它"。
constexpr uint32_t kViableBauds[] = {9600, 115200, 38400, 19200, 4800};
constexpr uint8_t  kBaudCount     = sizeof(kViableBauds) / sizeof(kViableBauds[0]);
constexpr uint32_t kNoLineHuntMs  = 3000;   // 多久没报文就开始换档
constexpr uint32_t kBaudDwellMs   = 2500;   // 每档听多久

// ---------------- 判据阈值(对齐参赛方案 6.2 双阈值 + 7.10 定点一致性)----------------
constexpr int      TH_MIN_SATS_USED  = 4;      // 参与定位星数下限
constexpr float    TH_MAX_HDOP       = 5.0f;   // HDOP 上限
constexpr float    TH_MIN_CN0_MEDIAN = 25.0f;  // C/N0 中位数下限 (dB-Hz)
constexpr float    TH_MAX_OFFSET_M   = 30.0f;  // 偏离基准坐标上限(米)
constexpr uint32_t TH_HOLD_MS        = 5000;   // 迟滞:异常连续 5 s 才报警
constexpr uint32_t TH_RECOVER_MS     = 8000;   // 迟滞:正常连续 8 s 才解除
constexpr uint32_t TH_STALE_MS       = 3000;   // 数据超时视为无数据
constexpr uint32_t TH_COLDSTART_MS   = 90000;  // 冷启动宽限:没定过位且不到 90 s 只提示不报警

// ★ v1.8.3:原来这里有一个「注入量」常量(INJECT_OFFSET_M = 120 m),注入功能整体删除,
//   常量一并去掉 —— 判据现在**只比对真实坐标**,固件里没有任何改写输入的口子。

// ============================================================================
//  ★★ v1.9.0 新增段:完好性(integrity)+ 慢漂移(CUSUM)+ 多径(仰角模板)
// ----------------------------------------------------------------------------
//  这三个算法共用一条**前提**,答辩时必须主动说清,别含糊:
//    我们手里**没有原始伪距 / 星历 / 载波相位** —— NMEA 只给"算完的结果"。
//    所以做不了测量域 RAIM(那要在伪距上做残差检验),这里做的是**解域**
//    (solution domain)完好性:用 GGA 的 HDOP/星数 + GSA 的 PDOP/VDOP/参与星表
//    + GSV 的仰角/方位/C-N0 去**估计**当前解的可信度。
//    这个分支在文献里是站得住的(SBAS/GBAS 的保护级判据就是解域的),
//    但它**不是** RAIM,也不是认证级参数 —— 见下面 kHplK 的注解。
// ============================================================================

// ---- ① 单星测距噪声模型:σ(C/N0) = kSigRefM · 10^((kCn0Ref − C/N0)/20) ----
//  推导:信号**幅度** ∝ 10^(C/N0/20),而测距(码相位)抖动的标准差 ∝ 1/幅度
//       ⇒ σ ∝ 10^(−C/N0/20) ⇒ C/N0 每降 6 dB,测距噪声翻一倍。
//  一个参考点 + 一条固定斜率,不需要标定表 —— 现场想整体挪,只改 kSigRefM 一个数。
constexpr float kSigRefM = 0.6f;    // C/N0 = 45 dB-Hz 时的单星测距噪声(米)
constexpr float kCn0Ref  = 45.0f;   // 上面那个参考点(dB-Hz)
constexpr float kSigMinM = 0.25f;   // 下限:再好的星也不许算出 0(否则 HPL=0 像"绝对准")
constexpr float kSigMaxM = 40.0f;   // 上限:半边天被挡时防止 HPL 溢成天文数字
//  ★ v1.14.12 σ 统计的"可用"下限。2026-10-31 阳台实测:GSV 里躺着 C/N0 = 6 dB-Hz
//    的星(接收机根本不可能拿它定位),而"取最强 k 颗"的 k 用的是 GGA 的 satsUsed ——
//    两者一凑,6 dB 的星就进了 σ 的均方根,一颗就把 σ 抬 8 m、HPL 抬一倍多
//    (实测 HPL 在 6.4 ↔ 33.8 m 之间来回跳,还真触发过一次 22 s 的 HPL-HIGH,
//    事件 #255)。25 dB-Hz 是"低于它接收机不可能用于定位"的常识线;
//    低于它的星不参与 σ 统计 —— 这不是放松门限,是把**不参与解算的星**
//    从"最坏情况"里请出去。
constexpr float kCn0Usable = 25.0f; // σ 统计的 C/N0 下限(dB-Hz);低于它不算"参与了定位"

// ---- ② 保护级:HPL = kHplK · HDOP · σ_UERE ----
//  kHplK = 5.33 取自航空界的常用量级(单侧虚警 ~1e-7 / 漏检 ~1e-3 量级的多重覆盖因子),
//  **是量级对标、不是认证参数**。所以屏上和文档里一律写 "HPL(est)" ——
//  这个"est"字不能省,省了就等于宣称自己是适航级。
constexpr float kHplK = 5.33f;

// ---- ③ 告警限 AL ----
//  ★ v1.10.0:AL 与 POS LIM **不再是同一个常量**。
//    原来这里写着 `constexpr float kAlertM = TH_MAX_OFFSET_M;` + 一条 static_assert
//    把两者锁死同值(都 30 m)。加参数页时必须拆开,而且**拆开本身更正确**:
//      AL      = "我这句保证负责到什么精度"(完好性框架里的 alert limit)
//      POS LIM = "偏多少算异常"(业务判据)
//    两者碰巧都是 30 m 是因为这一版想让"报警"和"保证"用同一把尺子,
//    不是因为它们语义相同。航空界 AL 本来就是**必须现场可配**的:
//    LPV-200 = 35 m / APV-I = 40 m / 海事 556 m。可配置不是妥协,是设计意图。
//    默认值仍是 30 m ⇒ 出厂观感一个字都没变。
//    真正不能动的是 kHplK 与 σ 模型 —— 那是**设备标定项**,不是现场配置项
//    (理由写在下面 ⑦ 段的段头)。

// ---- ④ HPL 迟滞:★ v1.10.0 起与判据**共用** tune::holdMs / tune::recoverMs ----
//  原来这里是 kHplHoldMs / kHplRecoverMs 两个 constexpr(= TH_HOLD_MS / TH_RECOVER_MS)。
//  已删除:一组时间常数只能有**一个真源**,否则"屏上把 HOLD 改成 20 s、HPL 迟滞
//  还在用 5 s"这种错从代码上根本看不出来 —— 现场只会觉得"改了没用"。

// ---- ⑤ CUSUM(单侧、向上):抓"慢慢挪",阈值法抓不到的那一类 ----
//  为什么需要它:真实的位置欺骗往往**不是瞬移**,而是一分钟拉偏几米。
//  阈值法(off > 30 m)要等到 30 m 才响;CUSUM 累积"每拍超出正常起伏的那一点点",
//  配合下面 15 m 的绝对闸,能在"明显超出常态"的量级上给出"这是持续趋势"的判据 ——
//  这段时间足够人去做处置。(8 m 闸在小尺度多径点位会误报,见 kCusumMinM。) 
//
//  ★ 公式(教科书列表型 CUSUM):
//        S ← max(0, S + (off_filt − μ) − k)
//    μ 是**慢基线**(τ≈5.5 min),代表"平时稳定在哪儿"。
//    ⚠ 这一项不能省!第一版我写成 S += (off − k),等于拿 **0** 当基线 ——
//      而 off 是**距离、恒 ≥ 0**,基准本身差 1~2 m 是常态,于是 S 每秒都涨,
//      十来秒后就永久报"在漂"。**恒定偏差不是漂移**,漂移是"相对自己以前的偏离"。
//      这类错误的形态很难看:设备明明一动不动,却说它一直在漂。
//  归一化:不做。留物理单位(m / m·s),现场改参数时不用换算,也便于对着串口读。
constexpr float kCusumAlpha = 0.05f;   // 一阶低通 α(1 Hz ⇒ τ ≈ 20 s):压掉逐拍噪声
constexpr float kCusumMuA   = 0.003f;  // 慢基线 α(τ ≈ 5.5 min):"平时在哪儿"
constexpr float kCusumSlack = 1.0f;    // 允许的正常起伏(m):偏差小于它就不累积
constexpr float kCusumH     = 20.0f;   // 判决门限(m·s):约等于"多出 1 m 持续 20 s"
constexpr float kCusumMinM  = 15.0f;   // ★ v1.14.10 绝对闸:8 -> 15 m
                                       //   2026-10-31 阳台实测:小尺度多径(铁栏杆/钢架)让
                                       //   单点解常年偏 5~11 m,8 m 闸把"固有偏差"当成"在漂",
                                       //   DRIFT 频繁误报。15 m 仍远低于 POS LIM 30 m,
                                       //   "持续多出 1 m 才累积"的趋势判据不变 —— 只把
                                       //   "基准本身差几米"挡在门外。若现场常态 >15 m,
                                       //   该重标基准,而不是继续抬闸(抬到 30 就等于废掉本判据)。
//  ★ v1.9.0 补丁(实机上抓出来的):**开机预热期**。
//    起因:烧完一上电,`off` 稳定在 3 m 不动,统计量却逐拍 +1.25 线性涨,
//    2.8 -> 3.9 -> ... -> 13.0,眼看就要撞 20 —— 设备一动不动,却在"累积漂移量"。
//    根因:μ 的初值取"进入本段时那一拍的 off"。那一拍并不可靠 —— 基准刚从 NVS
//    恢复、首解刚出、off 还在 0 附近,μ 于是从 0 起步;而 μ 的 α 只有 0.003
//    (τ≈5.5 min),要爬好几分钟才追上真实的 3 m。这段爬升期里 dev 恒为正,
//    减去 k 后仍有 1~2 m 的余量,逐拍累积 ⇒ "一开机就在漂"。
//    这与上面那条"恒定偏差不是漂移"是**同一个错的两个入口**:上次是拿 0 当基线,
//    这次是拿"还没稳下来的第一个样本"当基线。
//    治法:进入本段后的前 90 s 只**建基线**、不**做判决** —— μ 用快 α(τ≈6.5 s)
//    快速收敛到真实工作点,统计量锁 0。90 s 后切回慢 α,才开始积累。
//    (现场本来也要等基准稳下来,这 90 s 不占用任何判据窗口。)
constexpr uint32_t kCusumWarmMs = 90000;  // 预热 90 s:只建 μ,不判决
constexpr float    kCusumWarmA  = 0.15f;  // 预热期 μ 的 α(1 Hz ⇒ τ ≈ 6.5 s)

//  ★★ v1.14.12 "闸下回落 + 上限"补丁(2026-10-31 阳台实测,CUSUM 挂在 848 不下来):
//    现象:off 稳在 6~7 m,状态 INTEG-OK,统计量却冲到 848 m·s(H 的 42 倍),
//    屏上条子钉满、数字吓人,还在以 ~2 m·s/s 的速度慢慢回落 —— 用户问
//    "漂到 848 为什么不报警、为什么收不回来"。
//    复盘(离线复算,tools/cusum_step_sim):开机首解 off≈2 m,μ 锚在 2;
//    几分钟后多径环境稳定,off 站上 6~7 m —— **静态偏差挪了 5 m**。μ 的 τ≈5.5 min,
//    要花十几分钟才追上;这段时间里 CUSUM 把"挪基准"当"漂移"逐拍累积,
//    峰值 ≈ (5 m)×333 s ≈ 1650 量级,实测 848 正是这个量级的中途值。
//    它不报警是**对的**:慢判据还有第二道绝对闸(filt > 15 m),6~7 m 的静态偏差
//    被闸拦住 —— 这正是 v1.14.10 抬闸想保的行为。错的是**统计量没被告知**:
//    闸在下面拦着,累积却照涨,于是"数值 42×H、状态 OK"这种自相矛盾的显示,
//    而且真漂移来时统计量早已没有动态范围。
//    治法(两条,都只动"统计量",不动判据结构):
//    ① 闸下回落:filt ≤ 绝对闸时,这段时间按定义"不算漂",证据不该继续攥着 ——
//       统计量按 kCusumSDecay 速率回落。848 → 0 约 7 min(实测它自己花 15 min)。
//    ② 上限:kCusumSMax = 3×H。过 H 本来就是二值判决,40×H 与 3×H 信息量相同,
//       封顶保住"还能看见回落"的动态范围。
constexpr float    kCusumSMax   = 3.0f * kCusumH;  // 统计量上限(m·s):判决是二值的,封顶保动态范围
constexpr float    kCusumSDecay = 2.0f;            // 闸下回落速率(m·s/s):848 → 0 约 7 min

// ---- ⑥ 多径:CN0–仰角模板残差 ----
//  正常天空里 CN0 随仰角**单调上升**(穿过的大气少、路径损耗小)。低仰角星却
//  比模板**明显更强**,说明除了直射还叠了一路反射 —— 那就是多径的指纹。
//
//  ★ 阈值为什么是 10 而不是拍脑袋的 6(2026-10-17 实测定):
//    6 dB 在这个点位(3 楼窗边)**长期误报** —— 现场实测低仰角残差常态就在
//    7.1~9.3 dB 之间,屏上会一直挂着"MP n1 max +8dB",等于把"永远有多径"当默认。
//    这种"常年亮着"的告警比不报警更糟:看的人很快就学会无视它。
//    ⇒ 取 10 dB 只报**强**多径(一倍功率以上的反射),宁可漏报不误报。
//    真要更灵敏,把 kMpThrDb 降到 7 即可(会开始报常态),现场一眼能看出区别。
constexpr float kMpThrDb    = 10.0f;   // 残差高于模板多少 dB 算可疑
constexpr float kMpMaxElDeg = 45.0f;   // 只在这个仰角以下判(高仰角本来就强)
constexpr float kMpForget   = 0.999f;  // RLS 遗忘因子(≈ 最近 1000 个样本)

// ============================================================================
//  ⑦ 可调阈值 —— 屏上「PARAMS」页 / 串口 p 的**运行时真源**(★ v1.10.0 新增)
// ----------------------------------------------------------------------------
//  为什么要这一层(用户 2026-10-17 原话):
//    "城市范围内很多地方有高楼、金属物,会产生多径效应,有时候判断依据不太好……
//     我们需要有一个入口去设置一些参与运算的参数。"
//  这个需求是**真的**:同一个固件放在 3 楼窗边和放在街边峡谷,合理的门限不一样;
//  写死 30 m 在一种场景下太松、在另一种下太紧。
//
//  ★ 分界线必须划清:**判据阈值可调,模型系数锁死。**
//    可调 = "我认什么算异常"(AL / POS LIM / 门限 / 迟滞)—— 这是**配置项**,
//           航空界本来就要求现场可配(LPV-200 = 35 m / APV-I = 40 m / 海事 556 m)。
//    锁死 = "我怎么算出这个异常"(kHplK = 5.33、σ(C/N0) 的 0.6 m@45 dB-Hz、
//           CUSUM 的 α/μA/k/H、多径模板的 RLS 遗忘因子)—— 这是**设备标定项**。
//    为什么后者不能开放:`tools/cusum_replay.py` 是把这些系数**逐值复制**过去做的
//    离线回放,结论是"0.02~0.4 m/s 斜坡下 8 m 绝对闸先到、CUSUM 再确认 0 s"。
//    一旦系数能在屏上改,那份回放证据就和手上这台机器对不上了 ——
//    答辩时说"我们验证过它不会误报"当场失去支撑。
//
//  ★ 存储:NVS 命名空间 **gnstune**,与校准(gnstouch)/ 基准(gnsbase)/ WiFi 台账
//    完全隔离。只烧 app(0x10000)不会丢;屏上 DEFAULTS 一键回出厂。
//  ★ 生效:改完立即生效,不重启。唯一例外是 HDOP MAX / SAT MIN ——
//    它们只在"按 BASE 设基准"那一刻被读,对已存好的基准没有追溯效力(也不该有)。
// ============================================================================
namespace tune {

// ---- 出厂默认值(★ 唯一真源:恢复出厂、串口 p 的 "def" 列都读这里)----
//  每个都注明它的"前身"是哪个 constexpr —— 这一轮是把常量搬到运行时,
//  不是重新定标,所以默认值一个都没改(用户 2026-10-17:"默认值先不变")。
constexpr float kDefPosLim  = TH_MAX_OFFSET_M;                 // 30 m
constexpr float kDefAlert   = 30.0f;                            // 原 kAlertM
constexpr float kDefHdop    = 2.0f;                             // 原 kBaseMaxHdop
constexpr float kDefSat     = 6.0f;                             // 原 kBaseMinSats
constexpr float kDefCn0     = TH_MIN_CN0_MEDIAN;                // 25 dB-Hz
constexpr float kDefMpThr   = kMpThrDb;                         // 10 dB
constexpr float kDefHold    = (float)(TH_HOLD_MS / 1000u);      // 5 s
constexpr float kDefRecover = (float)(TH_RECOVER_MS / 1000u);   // 8 s

struct Item {
  const char* key;      // NVS 键(Preferences 上限 15 字符)
  const char* name;     // 屏上名(FONT2,最长 9 字符)
  const char* unit;     // 单位后缀(空串 = 无单位)
  float  def, lo, hi, step;
  uint8_t dec;          // 显示小数位:0 = 整数,1 = 0.1
  float* p;             // 运行时值
  const char* note;     // 编辑页底部说明(FONT1 6px,≤30 字符 ≈180px)
};

// ---- 运行时值:全部先落出厂默认,load() 再用 NVS 覆盖 ----
static float vPos   = kDefPosLim,
             vAlert = kDefAlert,
             vHdop  = kDefHdop,
             vSat   = kDefSat,
             vCn0   = kDefCn0,
             vMp    = kDefMpThr,
             vHold  = kDefHold,
             vRec   = kDefRecover;

// 顺序 = 屏上列表顺序。**判据类在前、显示类在后**,因为前六个会改状态词。
static Item items[] = {
  { "poslim",  "POS LIM",  "m",     kDefPosLim,  10.0f, 100.0f, 5.0f, 0, &vPos,
    "offset over this -> POS-BAD" },
  { "al",      "HPL LIM",  "m",     kDefAlert,   10.0f, 100.0f, 5.0f, 0, &vAlert,
    "protection level limit (AL)" },
  { "hdopmax", "HDOP MAX", "",      kDefHdop,     1.0f,   5.0f, 0.1f, 1, &vHdop,
    "gate when saving a base" },
  { "satmin",  "SAT MIN",  "",      kDefSat,      4.0f,  12.0f, 1.0f, 0, &vSat,
    "gate when saving a base" },
  { "cn0min",  "CN0 MIN",  "dB-Hz", kDefCn0,     15.0f,  40.0f, 1.0f, 0, &vCn0,
    "median under this -> DEGRADED" },
  { "mpthr",   "MP THR",   "dB",    kDefMpThr,    4.0f,  20.0f, 1.0f, 0, &vMp,
    "multipath residual (readout only)" },
  { "hold",    "HOLD",     "s",     kDefHold,     1.0f,  30.0f, 1.0f, 0, &vHold,
    "alarm needs bad this long" },
  { "recover", "RECOVER",  "s",     kDefRecover,  2.0f,  60.0f, 1.0f, 0, &vRec,
    "clear needs good this long" },
};
constexpr int kN = (int)(sizeof(items) / sizeof(items[0]));
static_assert(kN == 8, "参数表项数必须等于 PARAMS 页行数 8(见 tune::TP_ROWS)");

// ---- 访问器:所有判据**只从这里**取值 ----
//  加 inline:这几个每圈都调,不值得走函数调用。
inline float    posLim()    { return vPos; }
inline float    alertM()    { return vAlert; }
inline float    hdopMax()   { return vHdop; }
inline int      satMin()    { return (int)(vSat + 0.5f); }
inline float    cn0Min()    { return vCn0; }
inline float    mpThrDb()   { return vMp; }
inline uint32_t holdMs()    { return (uint32_t)(vHold    + 0.5f) * 1000u; }
inline uint32_t recoverMs() { return (uint32_t)(vRec     + 0.5f) * 1000u; }

inline void clampAll() {
  for (int i = 0; i < kN; ++i) {
    if (*items[i].p < items[i].lo) *items[i].p = items[i].lo;
    if (*items[i].p > items[i].hi) *items[i].p = items[i].hi;
  }
}

inline int changed() {          // 与出厂默认不同的项数(串口/状态行标记用)
  int n = 0;
  for (int i = 0; i < kN; ++i)
    if (fabsf(*items[i].p - items[i].def) > 1e-3f) ++n;
  return n;
}

// ---- NVS ----
static Preferences prefs;
constexpr const char* kNvsName = "gnstune";

inline void save() {
  prefs.begin(kNvsName, false);
  for (int i = 0; i < kN; ++i) prefs.putFloat(items[i].key, *items[i].p);
  prefs.end();
}

inline void load() {
  prefs.begin(kNvsName, true);
  for (int i = 0; i < kN; ++i) *items[i].p = prefs.getFloat(items[i].key, items[i].def);
  prefs.end();
  clampAll();                   // 换过固件、改过范围也不会读出非法值
  Serial.printf("[bench] tune: %d/%d non-default (nvs gnstune)\n", changed(), kN);
}

inline void resetAll() {
  for (int i = 0; i < kN; ++i) *items[i].p = items[i].def;
  save();
}

inline void fmtVal(char* out, size_t n, int i) {
  const Item& it = items[i];
  char num[12];
  snprintf(num, sizeof(num), "%.*f", (int)it.dec, *it.p);
  if (it.unit[0]) snprintf(out, n, "%s %s", num, it.unit);
  else            snprintf(out, n, "%s", num);
}

// dir = +1 / -1;mult = 1 或 5(屏上四个键就是 ±1×step / ±5×step)
inline void bump(int i, int dir, int mult) {
  Item& it = items[i];
  *it.p += (float)dir * (float)mult * it.step;
  if (*it.p < it.lo) *it.p = it.lo;
  if (*it.p > it.hi) *it.p = it.hi;
}

}  // namespace tune


// ---------------- 屏参数(★★ v1.7.0 主界面重排:三段式) ----------------
// 版式(240x320 竖屏):
//   y   0..239   星空图区 240x240 —— 圆盘 + 外圈状态光环 + 四角 HUD 块
//   y 240..273   按键条   240x34  —— BASE / CLR-BS / CHARTS / LOG,每键 60x34
//   y 274..319   数据条   240x46  —— 左 状态词(FONT4) + 右 HPL/CN0/SAT 三行
//  ★ v1.9.0(用户 2026-10-17 定):"上面四个按键的高度再缩小一点,多留点空间给数据条"。
//    按键 40 -> 34(省 6),数据条 40 -> 46(得 6),两者之和仍是 80 ——
//    **底部 sprite 尺寸、报文窗 8 行、BOT_Y 全都不变**,所以这轮只动两个数。
//    按键文字是 FONT2(16px),在 34px 格里内缩 2px = 30px 可用,16px 字居中后
//    上下各留 7px;★ v1.10.6 长按进度条挪到键内**顶部** y=4(手指不挡)。
//    数据条从 40 涨到 46,右侧才放得下**三行** 8px(HPL / CN0 / SAT)。
// 原来那套「顶部 100px 状态色带 + 四周 3px 彩框 + 报文窗 + 指标区」**整体作废**:
// 状态色改由**星空图外圈 2px 光环**唯一承载(见 statusColor565),
// 原先散在指标区的信息(时间/坐标/温湿度/漂移/HDOP)全部归位到四角块与数据条。
// 报文窗不再常驻 —— 长按数据条 1s 切出来(v1.10.6 取整;见 touch::poll)。
constexpr int SCR_W    = 240;
constexpr int SCR_H    = 320;

constexpr int SKY_H    = 240;                          // 星空图区高
constexpr int BTN_Y    = 240, BTN_H = 34, BTN_W = 60;  // 按键条(4 键)
constexpr int DATA_Y   = 274, DATA_H = 46;             // 数据条
static_assert(BTN_Y + BTN_H + DATA_H == SCR_H, "按键条+数据条必须正好铺满 240..319");

// ---- 星空图几何:圆心在 240x240 区正中 ----
constexpr int SKY_CX      = SCR_W / 2;    // 120
constexpr int SKY_CY      = SKY_H / 2;    // 120
// ★ v1.7.1(用户 2026-10-16 拍板"星空图再大一圈 + 外圈色环也大 3px"):圆盘 80 -> 87、
//   环 83/84 -> 90/91 = 各放大 7px。上限是**算术结果、不是感觉**:
//   块高缩到 24 后四角块最内角 = (HUD_M+HUD_W, HUD_M+HUD_H) = (94, 26),
//   到圆心 (120,120) 距离 = sqrt(26²+94²) = 97.53 ⇒ 环外沿最多 97(圆盘 93 / +13)。
//   这里取 +7 —— 与旧版(+5 时余量 5.85px)留同样宽的 6.5px 余量,想用满就改这三个数。
constexpr int R_STAR      = 87;           // 圆盘半径(圆占 x/y 33..207,直径 174)
constexpr int R_RING_IN   = 90;           // 状态光环内沿
constexpr int R_RING_OUT  = 91;           // 状态光环外沿 -> 2px 实心环
// 环与圆盘之间(88..89 这两像素)留**页底色** -> 光环"悬浮"在圆外,不与星点混淆

// ---- 四角 HUD 块 92x24,边距 2 ----
// ★ v1.7.1:"四角字体小一号" —— 内置字模只有 6x8(字体1) / 16px(FONT2) / 26px(FONT4)
//   三档(setTextSize 只吃整数倍),16px 的下一档就是 6x8 ⇒ 字模 FONT2 -> 字体1,
//   行距 16 -> 9、块高 32 -> 24(不缩块的话两行 8px 字在 32px 里上下各空 8px,很散)。
//   块高一缩,星空图上限从 +5px 抬到 +13px,所以同时做了上面那轮放大。
// 块宽 92 的依据(v1.7.0 立;换字模后余量更宽):"2026-10-16" 用字体1(6px/字符)= 60px,
//   加左右各 4px 内边距 = 68px ⇒ 92 富余 24px,**右上块右端那 22px 正好让给 WiFi 图标**。
constexpr int HUD_W = 92, HUD_H = 24, HUD_M = 2;
constexpr int HUD_LH = 9;                  // 块内两行 8px 字的行距(上下各留 ~3.5px)
static_assert(HUD_H >= HUD_LH + 8 + 2, "四角块高装不下两行 8px 字 —— 调大 HUD_H 或调小 HUD_LH");
// 四块的左上角坐标(星空区内,1..239 / 2..205 之间)
constexpr int HUD_XL = HUD_M;                      // 左列 x = 2
constexpr int HUD_XR = SCR_W - HUD_M - HUD_W;      // 右列 x = 146
constexpr int HUD_YT = HUD_M;                      // 上行 y = 2
constexpr int HUD_YB = SKY_H - HUD_M - HUD_H;      // 下行 y = 206

// ★ 编译期几何自检(改 R_* / HUD_* 任一项都必须重过这三条)
// ① 光圈外沿不许碰四角块最内角:块内角 = (HUD_M+HUD_W, HUD_M+HUD_H) = (94,26),
//    到圆心 (120,120) 距离² = 26² + 94² = 9512 > R_RING_OUT² = 8281,余量 6.5px。
static_assert((SKY_CX - (HUD_M + HUD_W)) * (SKY_CX - (HUD_M + HUD_W)) +
              (SKY_CY - (HUD_M + HUD_H)) * (SKY_CY - (HUD_M + HUD_H)) >
              R_RING_OUT * R_RING_OUT,
              "星空图光圈会压到四角 HUD 块 —— 调小 R_* 或调小 HUD_*");
// ② 圆盘与光环之间至少留 3px(含 2px 页底缝)
static_assert(R_RING_IN - R_STAR >= 3, "圆盘与状态光环之间要留 2px 页底缝");
// ③ 按键条必须四等分正好铺满
static_assert(BTN_W * 4 == SCR_W, "按键条必须四等分铺满 240px");

// ---- 报文窗(★ v1.7.0:长按数据条切出/收回,v1.10.6 起阈值 1s)—— 占 y 240..319 整块 240x80 ----
constexpr int MSG_ROWS  = 8;      // 8 行 x 10px = 80
constexpr int MSG_LH    = 10;     // 报文行高
constexpr int MSG_CHARS = 38;     // 字体 1 每字符 6px -> 240px 内放 38 字符(228px)

// ---- BACK 按钮几何(第二/三/四界面共用同一组;touch::poll 的判定也按它比对) ----
constexpr int BACK_W = 64, BACK_H = 24, BACK_Y = 2;
constexpr int BACK_X = SCR_W - 6 - BACK_W;   // 170(右对齐,右边距 6)

// ---- WiFi 信息卡(★ v1.7.2 新增)---------------------------------------------
// 为什么要有它:S3 自己的 IP **屏上一直没有落脚点** —— 它只作为回执发给 C3
//   (`@s ok ip 192.168.2.40`),想在地面看一眼得凑到 C3 的输出卡上。
//   而主界面三段式已经排满:四角块只有 92px 宽、数据条右侧只剩 56px 领地,
//   11 字符的 IP(66px)塞不进任何一个固定位置。
//   ⇒ 做成**按需弹卡**:点右上角那颗 WiFi 图标 -> 弹 4 秒 -> 自动收。
//   零侵入:不去点它,屏上一个像素都不变(所以不破坏已定稿的版式)。
// 落点:CARD_Y = 90 在星空图区内、圆盘正中偏上 —— 不压上排四角块(y 2..25),
//   也不压下排(y 206..229);圆盘自身的星点被临时盖住 4 秒,可接受。
constexpr int      CARD_W = 176, CARD_H = 60;
constexpr int      CARD_X = (SCR_W - CARD_W) / 2;   // 32 水平居中
constexpr int      CARD_Y = 90;
constexpr uint32_t kCardMs = 4000;                  // 显示时长(再点一下可提前收)
constexpr int      CARD_TX = 10;                    // 卡内左边距
constexpr int      CARD_TY = 10;                    // 首行距卡顶
constexpr int      CARD_LH = 16;                    // 卡内行距(8px 字 + 8px 空)
// 三行:10 / 26 / 42 -> 末行底 50,卡高 60,上下各留 10px
static_assert(CARD_TY + CARD_LH * 2 + 8 <= CARD_H - 10, "WiFi 卡三行装不下 —— 调 CARD_H 或 CARD_LH");
static_assert(CARD_X >= 4 && CARD_X + CARD_W <= SCR_W - 4, "WiFi 卡会贴到屏边 —— 调 CARD_W");
// 卡内文字用**字体1(6px/字符)**。值的列起点 = CARD_X + CARD_TX + 36(固定 6 字符宽的标签列),
// 右边再留 CARD_TX ⇒ 值那一列最多 (CARD_W - CARD_TX*2 - 36)/6 = 20 字符 —— 够放 IPv4(15)。
static_assert((CARD_W - CARD_TX * 2 - 36) / 6 >= 20, "WiFi 卡的值列放不下 20 字符 —— 调 CARD_W 或 CARD_TX");

// ---------------- 报文窗画法(2026-10-01 定型;★ v1.7.0 尺寸改 240x80) ----------------
// **内存合成(sprite)是唯一画法,已定型,不再提供切换。**
//
// 为什么必须是它 —— 老的"直接画"每次重绘是一段几十毫秒的"亮度脉冲":
//    ① fillRect 整块擦底      ② 逐行 drawString,字一行行长回来
//   节拍踩在人眼对大面积闪烁最敏感的那一档,所以看着特别刺眼。
//   内存合成后,那块区域在 pushSprite 之前**一个像素都不动**,
//   上屏变成一次连续的整块替换,亮度全程基本恒定 ⇒ 闪感消失。
//   (代价:一次性占 38,400 字节 RAM,即 240x80x2。S3 完全够。)
//
// 2026-10-02 把 "串口敲 w 切换画法" 那条临时通道撤了 —— 屏的效果已确认满意,
//   留着一个能改画法的命令只是演示现场的风险(误敲一下画面就变回闪的)。
//   现在老画法只作为**兜底**保留:万一 sprite 申请失败,自动退回它,
//   宁可稍微闪一点,也绝不能黑屏。
//
// 报文窗刷新节拍(ms)。400ms = 2.5Hz:屏上照样看得出"在走",
// 但闪烁频率离开敏感区,SPI 占用也不高。
constexpr uint32_t MSG_REFRESH_MS = 400;

// ---------------- 屏配色:深色主题(★★ v1.7.0 定稿) ----------------
// 根因与改法:原来 CLR_PAPER = TFT_WHITE,整屏铺白,刺眼。现在整屏深色,
// 状态色由**星空图外圈 2px 光环**唯一承载 —— 屏上不再有任何整块颜色。
// ★ 等号右边是屏真正要的 RGB565(uint16_t);注释给回 #RRGGBB 设计值方便核对。
//   换算规则 R565=round(R*31/255) / G565=round(G*63/255) / B565=round(B*31/255),
//   **别用 >>3 截断**(深色值截断会整体偏暗一档)。
// 改配色只动下面这一组常量 —— 别处一律不要再写死颜色。
constexpr uint16_t CLR_PAPER = 0x0882;   // #0C0F13 页底(原 TFT_WHITE)
                                         // ★ v1.7.1 核对过:C3 的 CLR_BG 也是 0x0882,一字不差
// ★★ v1.7.1(用户 2026-10-16 拍板"参照 C3 配色,每个显示块底色有点灰"):块底**三个名字合一**。
//   旧的 C_BLOCK(0x2125) / C_BLOCK(0x0862) / C_BLOCK(0x2146) 整段删除 ——
//   全屏每一个"块"(图卡 / 星图圆盘 / 四角 HUD / 按键 / 三页的顶栏底栏)同色,
//   块与块之间只靠**页底细缝**分隔(照 C3 的 `fillRoundRect(x,y,SCR_W-8,h,4,CLR_BAR)` 手法),
//   块本身**一律不描边**(C3 的规律:边框只留给危险态,如告警弹窗与删除键)。
constexpr uint16_t C_BLOCK   = 0x18E4;   // #1A2027 块底(= C3 的 CLR_BAR,同一值)
constexpr uint16_t C_DATA    = 0x07FF;   // #00FFFF 数据青(= C3 屏上 [S3] 消息行色)
                                         // 用途:四角 HUD 八行 + 数据条 CN0/SAT
constexpr uint16_t CLR_RULE  = 0x3A09;   // #39414A 参考线 / 分隔线(★ v1.7.1 起不再描块的边)
constexpr uint16_t CLR_INK   = 0xE75D;   // #E6EBF0 主文字(原 TFT_BLACK)
constexpr uint16_t CLR_INK2  = 0x9515;   // #98A3AD 次级文字(原 0x4208)
constexpr uint16_t C_GPS     = 0x3FE2;   // #39FF14 GPS 荧光绿(原 #185FA5 蓝)
constexpr uint16_t C_BDS     = 0x069F;   // #00D4FF 北斗青蓝(原 #BA7517 橙)
// 状态色(星空图光圈 + 数据条状态词 + 板载 WS2812 灯,三处共用 statusColor565)
constexpr uint16_t C_ST_OK   = 0x3EAF;   // #37D67A 绿  NORMAL
constexpr uint16_t C_ST_DEG  = 0xEDE7;   // #F2C037 黄  DEGRADED
constexpr uint16_t C_ST_SIG  = 0xEBC5;   // #F2792B 橙  SIG-BAD
constexpr uint16_t C_ST_POS  = 0xFA69;   // #FF4D4D 红  POS-BAD / LOST(闪相=页底色)
constexpr uint16_t C_ST_GREY = 0x7C32;   // #7A8794 灰  SEARCH / NO-DATA
// ★ v1.9.0 新增:HPL-HIGH 用**紫**,是刻意避开已有五色的语义区 ——
//   绿=正常 / 黄=信号弱 / 橙=信号坏 / 红=位置坏 / 灰=还没数据。
//   "保证不足"不属于上面任何一类:它是"我不敢下结论",所以给一个**不在色阶上**的颜色。
//   #A78BFA -> 565:(167>>3)<<11 | (139>>2)<<5 | (250>>3) = 0xA45F
constexpr uint16_t C_ST_HPL  = 0xA45F;   // #A78BFA 紫  HPL-HIGH(完好性不足)
// ★ v1.10.1 新增:慢漂移用**琥珀** #FFB000 -> 565:(255>>3)<<11 | (176>>2)<<5 | 0 = 0xFD80
//   为什么不用"橙"(SIG-BAD)也不用"红"(POS-BAD):DRIFT 的证据强度只到"趋势",
//   没到"当场就偏了 30 m"。给红等于把推测说成事实 —— 2026-10-17 那次困惑就是这么来的。
//   用琥珀而不复用黄(DEGRADED):黄说的是"信号弱到影响精度",与"坐标在漂"不是一回事;
//   两者在事件列表里会并排出现,颜色分开才看得出"这段时间发生过两类事"。
constexpr uint16_t C_ST_DRIFT = 0xFD80;  // #FFB000 琥珀 DRIFT(慢漂移)
// 图表页辅助色(第二界面与主界面共用同一套,不再各定义一份)
constexpr uint16_t C_BG   = CLR_PAPER;   // 页面底色
constexpr uint16_t C_WARN = 0xF4B2;      // #F09595 阈值线
constexpr uint16_t C_DIM  = 0x5AEB;      // #5F5E5A 淡灰:历史点 / 没信号的星
constexpr uint16_t C_NAV  = TFT_RED;     // 亮红:星空图方位标注 N/S/W/E(深底上仍醒目)
constexpr uint16_t C_SATS = TFT_GREEN;   // 亮绿:星数角标(已随 n sats 取消,留作备用)

// ---- 原「指标区四格数值色 + 格位」(v1.5.5)已随 v1.7.0 主界面重排整体作废 ----
// 那四格(USED/VIEW、HDOP、CN0、OFFSET)连同 CLR_M_* 四色、MET_X_* 四个格位一并删除:
// 数值改由**数据条右侧**(CN0 / SAT)与**右下角 HUD 块**(DRIFT / HDOP)承载;
// 配色统一走上面的深色主题常量,不再为四格单独定义颜色。

// ============================================================================
//  第 1 段:GNSS 串口接收
//  只负责把 NMEA 行收下来存进环形缓冲,不解析、不判断。
// ============================================================================
namespace gnss {

static HardwareSerial port(1);
static char           lineBuf[NMEA_LINE_MAX];
static int            lineLen    = 0;
static char           pool[NMEA_POOL][NMEA_LINE_MAX];
static int            headIdx    = 0;
static int            stored     = 0;
static uint32_t       totalLines = 0;
static uint32_t       byteCount  = 0;
// ★ v1.14.11:波特率自寻的运行状态(说明见 kViableBauds 那一段)
static uint32_t       curBaud    = (uint32_t)GNSS_BAUD;   // 当前实际在听的波特率
static uint8_t        baudIdx    = 0;                     // 在 kViableBauds 里的位置
static uint32_t       lastLineMs = 0;                     // 最近一条 '$' 报文的时刻
static uint32_t       lastHuntMs = 0;                     // 上次换档的时刻

// ★ v1.7.0(用户 2026-10-16 20:47 拍板):**模拟信源整段删除**。
//   这里原来有个 `recvEnabled` 开关 —— 模拟信源(1/2/3 档)接管时置 false,
//   让真实 UART 只排空、不入池,好让"开模拟 = 纯模拟"、"结果与场地信号无关"。
//   模拟段走了,这个开关失去唯一的使用者 ⇒ **变量与那条排空分支一起删掉**,
//   报文池从此只有真实模块一个来源(这也正是它本来的语义)。
//   历史坑(留档):2026-10-07 实测发现 sim::commit() 与真报文写**同一个池子**,
//   按到达顺序谁后到谁赢 ⇒ 开着模拟时真模块的强信号会实时盖掉模拟,
//   "场景2 信号差"9 秒内星数仍是真实的 10~12、完全不转红 ⇒ 演示结果不可复现。
//   当年靠 recvEnabled 解决;现在靠"删掉模拟段"从根上不再有这个问题。

inline void begin() {
  curBaud    = (uint32_t)GNSS_BAUD;
  baudIdx    = 0;
  lastLineMs = millis();
  lastHuntMs = millis();
  port.begin(curBaud, SERIAL_8N1, PIN_GNSS_RX, PIN_GNSS_TX);
}

// ★ v1.14.11:一条有效报文都没来 ⇒ 换下一个波特率再听。
//   只在"确实没报文"时动,收到报文后 3 s 内绝不折腾 —— 正常运行时这条函数什么都不做。
inline void baudHunt(uint32_t now) {
  if (totalLines > 0 && (now - lastLineMs) < kNoLineHuntMs) return;
  if (now - lastHuntMs < kBaudDwellMs) return;
  lastHuntMs = now;
  baudIdx = (uint8_t)((baudIdx + 1) % kBaudCount);
  curBaud = kViableBauds[baudIdx];
  port.updateBaudRate(curBaud);
  lineLen = 0;                                   // 换档后旧半行作废,免得拼出新垃圾
  Serial.printf("[gnss] %.1fs 无有效报文 -> 换 %lu 8N1 再听\n",
                (double)kNoLineHuntMs / 1000.0, (unsigned long)curBaud);
}

inline void poll() {
  // ★ v1.7.0:原来这里有一条"模拟信源接管 ⇒ 只排空不入池"的分支(配 recvEnabled),
  //   已随模拟段一起删除 —— 见上方 begin() 之前的注释。

  // ★ 2026-10-01 晚改:while 加圈数上限(原来是 while (port.available()) 裸循环)。
  //   9600 波特每秒才来 960 字节,512 这个上限正常永远碰不到;
  //   加它只为兜一个底:**万一** UART 驱动报出一个假的巨大"可用字节数",
  //   主循环也不会被永远锁在这个循环里(那才是真正的死机)。
  for (int guard = 0; guard < 512 && port.available(); ++guard) {
    char c = (char)port.read();
    byteCount++;

    if (c == '\n') {
      if (lineLen > 0) {
        if (lineBuf[lineLen - 1] == '\r') lineLen--;
        lineBuf[lineLen] = '\0';
        if (lineLen >= 6 && lineBuf[0] == '$') {
          memcpy(pool[headIdx], lineBuf, lineLen + 1);
          headIdx = (headIdx + 1) % NMEA_POOL;
          if (stored < NMEA_POOL) stored++;
          totalLines++;
          lastLineMs = millis();       // ★ v1.14.11:收到报文 —— 波特率对了,别再换档
        }
        lineLen = 0;
      }
    } else if (lineLen < NMEA_LINE_MAX - 1) {
      lineBuf[lineLen++] = c;
    } else {
      lineLen = 0;                 // 超长行丢弃,重新对齐
    }
  }
}

// ★ v1.14.11:原始字节诊断。
//   现场"一个 NMEA 都不进来"时,只看 totalLines / cksumErr 分不清两种死因:
//     ① 模块压根没吐(UART 线上 0 字节)      -> 查供电/接线/模块
//     ② 有字节但收不对(波特率错、线上被拉死) -> 查波特率/信号完整性
//   rawBytes() 给出"不管内容、只数个数"的累计值;s 行里直接带出来。
inline uint32_t rawBytes() { return byteCount; }

// 'y' 命令用:把接下来 ms 毫秒里收到的原始字节吐到串口。
// 注意:这里**绕开**上面 poll() 的组帧状态机(只为看清线上到底是什么),
// 读走的字节不进 totalLines,探针结束后 lineBuf 里可能残留半行,
// 下一拍 poll() 会自然把它顶掉 —— 纯诊断用,不影响正常运行。
//
// ★ v1.14.11 追加三样:
//   ② baud 参数:临时把 UART1 换成别的波特率收(收完自动换回),用来判"模块是不是换了波特率";
//   ③ ASCII 直显:能直接看出是不是 "$GNRMC,..." 这种正常报文;
//   ④ 字节间隔(gap)统计:真 UART 帧在同一句里字节间隔≈1.04ms(9600)且整齐,
//      噪声/串扰的间隔是乱的 —— 这一条能把"线上有信号但被干扰"和"纯噪声"分开。
inline void rawProbe(uint32_t ms, uint32_t baud) {
  const char* hex = "0123456789ABCDEF";
  char row[3 * 16 + 8];
  int  col = 0, acol = 0;
  char ascii[76];
  uint32_t n = 0, t0 = millis(), prev = 0;
  uint32_t gMin = 0xFFFFFFFF, gMax = 0, gSum = 0, gCnt = 0;

  if (baud != GNSS_BAUD) port.updateBaudRate(baud);
  Serial.printf("[bench] probe: %lums @%lu 8N1 (当前在听 %lu) | 已累计 byte %lu\n",
                (unsigned long)ms, (unsigned long)baud, (unsigned long)curBaud,
                (unsigned long)byteCount);

  while (millis() - t0 < ms) {
    if (!port.available()) { delay(1); continue; }
    int c = port.read();
    if (c < 0) continue;
    uint32_t now = micros();
    if (n > 0 && (now - prev) < 200000UL) {          // 超过 200ms 的算"断句",不计入
      uint32_t g = now - prev;
      if (g < gMin) gMin = g;
      if (g > gMax) gMax = g;
      gSum += g; gCnt++;
    }
    prev = now; n++;

    if (n <= 96) {                                    // 前 96 字节给 hex
      row[col++] = hex[(c >> 4) & 0x0F];
      row[col++] = hex[c & 0x0F];
      row[col++] = ' ';
      if (col >= 48) { row[col] = 0; Serial.println(row); col = 0; }
    }
    ascii[acol++] = (c >= 0x20 && c < 0x7F) ? (char)c : '.';
    if (acol >= 72) { ascii[acol] = 0; Serial.print("  |"); Serial.println(ascii); acol = 0; }
  }
  if (col) { row[col] = 0; Serial.println(row); }
  if (acol) { ascii[acol] = 0; Serial.print("  |"); Serial.println(ascii); }

  Serial.printf("[bench] probe done: %lu bytes / %lums",
                (unsigned long)n, (unsigned long)ms);
  if (n == 0) {
    Serial.println("  <-- 线上一个字节都没有(模块没吐 / 线断 / 没供电)");
  } else if (gCnt >= 8) {
    Serial.printf(" | gap min %lu max %lu avg %lu us  <-- 9600 正常应≈1042us 且整齐\n",
                  (unsigned long)gMin, (unsigned long)gMax, (unsigned long)(gSum / gCnt));
  } else {
    Serial.println(" | gap 样本不足");
  }

  if (baud != curBaud) port.updateBaudRate(curBaud);   // ★ 换回"当前在听"的档,不是硬编码 9600
}

// back = 0 取最新一行;取不到返回 nullptr
inline const char* recent(int back) {
  if (back < 0 || back >= stored) return nullptr;
  int idx = (headIdx - 1 - back + NMEA_POOL * 2) % NMEA_POOL;
  return pool[idx];
}

}  // namespace gnss

// ============================================================================
//  第 1.2 段:PPS 秒脉冲捕获(模块 PPS --> GPIO16,上升沿中断)
//  PPS = Pulse Per Second:模块定位后,每秒在 PPS 脚上打一个上升沿,该沿的
//  时刻就是"整秒"的硬件基准(精度是 GPS 级的,比板载晶振好几个数量级)。
//
//  ★ 先把一个常见误解讲清:1Hz 的 PPS **不能"替代"40MHz 晶振**。
//    晶振要每秒输出 4000 万个周期,PPS 每秒只给 1 个沿,数量差 4000 万倍,
//    任何电路也变不出那些不存在的脉冲。PPS 能做的是**每秒对一次表**:
//    用它的沿去量"本地时钟走快了还是慢了",再反过来修正本地计时 —— 这才是
//    可行的驯服(tame/discipline)方案,本次先把"量"的部分做出来。
//
//  本段只做**观测**,不动系统时间:
//    · 数脉冲 —— 每秒 +1 就说明 PPS 线接通了(模块未定位时多不出脉冲,属正常)
//    · 量间隔 —— 相邻两沿的间隔理论值 1000000us;与它的差就是本地时钟的
//                相对误差,单位 us/s 即 ppm(1us/s = 1ppm = 86400us/天)
//    · 积分   —— 单拍只有 1us 分辨率 = ±1ppm 量化噪声,读不出真值。
//                把自开机起的每一拍累加再平均,误差摊薄到 ±1/N ppm:
//                3600 拍(1 小时)= ±0.0003ppm,那时才是真值。(2026-10-01 加)
//  观测数据:串口发 'g' 打印两行(瞬时 + 积分);开日志('v')时每 5 秒附带积分行。
// ============================================================================
namespace pps {

static volatile uint32_t edgeCount  = 0;   // 累计上升沿(中断里递增)
static volatile uint32_t lastEdgeUs = 0;   // 最近一次上升沿的本地时刻
static volatile uint32_t lastGapUs  = 0;   // 最近一次相邻间隔(理论 1000000us)
static volatile uint32_t minGapUs   = 0;   // 本次开机见过的最小间隔(0=还没量到)
static volatile uint32_t maxGapUs   = 0;   // 最大间隔(看抖动)

// ---- 积分累加器(2026-10-01 加,方案 A)--------------------------------------
//  为什么必须积分:micros() 分辨率 1us,单次间隔的量化误差就是 **±1ppm**。
//  实测报出来的 "+1.00 ppm" 恰好是个 1us 的整数跳,落在噪声里,不能当结论。
//  把 N 拍累加再平均,误差摊薄到 ±1/N ppm —— 3600 拍(1 小时)就到 ±0.0003ppm,
//  那时读出来的数才是 ESP32 时基相对 GNSS 的**真值**。
//  integSpanUs 必须是 64 位:micros() 自己 71.6 分钟就回绕一次,32 位累加器撑不住。
//  读这些量一律在 noInterrupts() 里做(64 位读不是原子的)。
static volatile bool     integOn      = false;  // 是否已建立积分起点
static volatile uint64_t integSpanUs  = 0;      // 自起点累计的本地 us
static volatile uint32_t integSecs    = 0;      // 累计的"GNSS 秒数"(丢沿时按整数秒补足)
static volatile uint32_t integSkipped = 0;      // 整段作废的次数(间隔 >4s,判为断线/失锁)

// 中断服务:越短越好 —— 只记时刻、算间隔,不做任何打印/浮点。
// ★ v1.10.5(复核 O1):**必须 IRAM_ATTR** —— 写 flash(NVS 落盘:基准/参数/事件流水)
//   期间 flash cache 被禁用,此瞬间 PPS 沿触发本中断,CPU 到 flash 取指令取不到,
//   直接 panic。旧注释声称"本项目已无运行期 NVS 写入(基准改会话制)"——该前提
//   v1.7.0(基准恢复落盘)/v1.10.0(参数落盘)/v1.8.x(事件落盘)起早已不成立。
//   本 ISR 只摸 .bss 里的 static volatile 变量、无 flash 常量表,IRAM 化安全;
//   当年"l32r literal placed after use"链接错与当时的写法有关,以本实现为准重试。
void IRAM_ATTR onEdge() {
  uint32_t now = micros();
  if (lastEdgeUs) {
    uint32_t gap = now - lastEdgeUs;     // 无符号减法,天然处理 micros() 回绕
    if (gap > 1000) {                    // 滤掉抖动产生的伪沿(<1ms 不可能是一个新秒)
      lastGapUs = gap;
      if (minGapUs == 0 || gap < minGapUs) minGapUs = gap;
      if (gap > maxGapUs) maxGapUs = gap;

      // ---- 积分累加 ----
      // 先把 gap 折算成"最近的整数秒":正常是 1;偶发丢 1~3 个沿时会读到 2~4。
      // 按 2~4 计入分母是**有意的** —— 否则丢沿会被误当成"本地表走慢了",把平均值拉偏。
      uint32_t secs = (gap + 500000UL) / 1000000UL;
      if (secs >= 1 && secs <= 4) {
        if (!integOn) { integOn = true; integSpanUs = 0; integSecs = 0; }
        // ★ 2026-10-15:`+=` 一并展开成 `= ... + ...`。C++20 起 `volatile` 上的**所有**复合赋值
        //   (含 += -= ++ --)都被弃用;这两行 GCC 当前还没报,但没理由留个半新半旧的样子。
        //   这两句都在 ISR 里、变量也只有本 ISR 写,展开后是同一个读-改-写,行为不变。
        integSpanUs = integSpanUs + gap;
        integSecs   = integSecs   + secs;
      } else {
        // ★ 2026-10-15:`++` 改写成 `= ... + 1` —— C++20 起在 `volatile` 上自增已被弃用
        //   (GCC 报 -Wvolatile)。语义完全一样,只是写法不再踩新标准。
        integSkipped = integSkipped + 1;   // >4 秒 = 断线/失锁,整段作废,不污染平均值
      }
    }
  }
  lastEdgeUs = now;
  edgeCount = edgeCount + 1;               // ★ 同上:volatile 上不用 `++`
}

inline void begin() {
  pinMode(PIN_GNSS_PPS, INPUT_PULLDOWN); // ★ v1.10.4(评审 S7):模块 PPS 是推挽输出,
                                         //   弱下拉不影响它;但**拔线后**脚悬空,原来
                                         //   裸 INPUT 会被噪声触发 ISR(edgeCount 空涨)。
  attachInterrupt(digitalPinToInterrupt(PIN_GNSS_PPS), onEdge, RISING);
}

inline uint32_t pulses() { return edgeCount; }

// ★ v1.14.0:最近一个沿的本地时刻(micros 基准)—— 唯一消费者是 clk::phaseUs()
//   (DS3231 的 SQW 与 PPS 的相位差)。加锁读:32 位读在 ISR 里可能被打断。
inline uint32_t lastEdgeUsRead() {
  uint32_t v;
  noInterrupts(); v = lastEdgeUs; interrupts();
  return v;
}
// 沿计数 + 最近沿时刻一起取(相位差要用"两边都新鲜"做闸门)
inline uint32_t edgeCountRead() {
  uint32_t v;
  noInterrupts(); v = edgeCount; interrupts();
  return v;
}

// 积分结果 —— **这才是能当结论的 ppm**。
// 单次间隔只有 1us 分辨率(±1ppm 量化噪声),把自开机以来所有拍累加起来平均,
// 误差摊薄到 ±1/N ppm。跑满 1 小时 = 3600 拍 → ±0.0003ppm,足够看清真实值。
inline void reportIntegral() {
  uint64_t span;
  uint32_t secs, skipped;
  bool     on;
  noInterrupts();
  span = integSpanUs; secs = integSecs;
  skipped = integSkipped; on = integOn;
  interrupts();

  if (!on || secs < 2) {
    Serial.println("[bench] pps 积分: 样本太少 —— 让它继续跑"
                   "(跑满 1 小时 = 3600 拍,分辨率才到 0.0003ppm)");
    return;
  }
  // 平均每"N 个 GNSS 秒"本地走了多少 us。GNSS 侧就是整秒(纳秒级误差,可忽略),
  // 所以这个平均数减 1000000 就是本地时基的真实 ppm。
  double avg = (double)span / (double)secs;
  double ppm = avg - 1000000.0;
  Serial.printf("[bench] pps 积分: %lu 拍 | 本地 %.6f s / GNSS %lu s | 平均 %.4f us | %+.3f ppm | 日漂移 %+.1f ms | 作废 %lu 段\n",
                (unsigned long)secs, (double)span / 1e6, (unsigned long)secs,
                avg, ppm, ppm * 86.4, (unsigned long)skipped);
}

// 打印一行观测结果。cnt=0 说明一个沿都没收到 —— 先查线,再查模块是否已定位。
inline void report() {
  uint32_t cnt, gap, gmin, gmax;
  noInterrupts();
  cnt  = edgeCount; gap = lastGapUs;
  gmin = minGapUs;  gmax = maxGapUs;
  interrupts();

  if (cnt == 0) {
    Serial.println("[bench] pps: 尚无脉冲 —— 检查 PPS 是否接到 GPIO16;"
                   "另注意多数模块未定位时 PPS 不出脉冲(等定位转绿再看)");
    return;
  }
  if (gap == 0) {
    Serial.printf("[bench] pps: 已收到 %lu 个脉冲,等第二个沿才能量间隔…\n",
                  (unsigned long)cnt);
    return;
  }
  // gap 与 1s 之差:正=本地表走慢了(实际间隔被量成更长),负=走快了。
  // 单位 us/s 数值上就等于 ppm。日漂移 = ppm × 86.4 ms。
  // ⚠ 这**只是最近一拍**,量化误差 ±1ppm,别拿它当结论 —— 看下面那行积分。
  double ppm = (double)((int32_t)gap - 1000000);
  Serial.printf("[bench] pps: %lu 脉冲 | 间隔 %luus (%+.2f ppm) | 抖动 min %lu / max %lu us | 日漂移 %.1f ms\n",
                (unsigned long)cnt, (unsigned long)gap, ppm,
                (unsigned long)gmin, (unsigned long)gmax, ppm * 86.4);

  reportIntegral();            // 紧跟一行积分平均 —— 那个才是结论
}

// ★ v1.5.20:C3 命令板要的是**一行短文本**(它输出卡一行 34 列,还要让出 "* " 前缀)。
//   原来 'g' 只把两行中文长句打在 S3 自己的串口上,C3 那边一个字都看不到 ——
//   用户 2026-10-12 23:5x 报的"命令发过去没反馈"就是这一类。纯 ASCII、≤32 字符。
inline void brief(char* b, size_t n) {
  uint32_t cnt, gap;
  noInterrupts();
  cnt = edgeCount; gap = lastGapUs;
  interrupts();
  if (!cnt) { snprintf(b, n, "pps no pulse"); return; }
  if (!gap) { snprintf(b, n, "pps %lu pulses", (unsigned long)cnt); return; }
  const double ppm = (double)((int32_t)gap - 1000000);
  snprintf(b, n, "pps %lu gap %luus %+.1fppm",
           (unsigned long)cnt, (unsigned long)gap, ppm);
}

}  // namespace pps

// ============================================================================
//  第 1.5 段:模拟信源 —— ★ v1.7.0(2026-10-16 用户拍板)**整段已删除**。
//
//  原来是"手头没 GNSS 模块时也能跑全状态"的演示用信源:把带合法校验和的 NMEA 行
//  按与真模块完全相同的路径写进 gnss 报文池,解析/判定/显示/灯全链路不区分真假。
//  串口 1/2/3 选正常/信号差/漂移,0 关闭;屏上色带右上角有 "SIM" 角标,
//  串口报表行首有 [SIM] 前缀,`@MIR` 第 9 字段也报模拟态。
//
//  删它的理由:项目未进复赛、转自用,"造异常演示"的需求消失(用户原话:
//  "我不想演示了,干脆把演示这部分全部都删掉")。C3 侧同名菜单项也一并删除,
//  S3 白名单里的 "0123" 同步移除。
//
//  ⚠ 删掉之后**两边都没有模拟信源了**:没有接 GNSS 模块时,报文池就是空的,
//    屏上会停在 SEARCH / NO-DATA。要造"位置异常"只能靠真实 GNSS 或外部干扰。
//  ⚠ 连带消失的东西(别再去找):recvEnabled(gnss 段的接收开关)、
//    stSim(drawStatus 的去重键)、屏上 "SIM" 角标、报表 [SIM] 前缀、
//    以及 nmea::st 里那几个只被模拟段写过的字段的"模拟语义"。
// ============================================================================

// ============================================================================
//  第 2 段:NMEA 解析
//  校验和 + 拆字段,只提取演示要用的:星数 / HDOP / C/N0 / 经纬度。
//  GSV 按 talker(GP / BD / GL / GA)分桶累加 —— 北斗和 GPS 是两套独立的
//  句序列,不分桶会互相冲掉,最后只剩一个星座。
// ============================================================================
namespace nmea {

constexpr int kMaxFld       = 32;   // GSV 最坏 4 星 x 4 字段 + 句名 + 校验和 = 22,留余量
constexpr int kMaxCn0       = 40;
constexpr int kMaxTalker    = 4;
constexpr int kCn0PerTalker = 24;
constexpr int kSatPerTalker = 24;   // 每星座最多记几颗星的位置(与 cn0 同容量)

// 单颗卫星的"位置 + 强度"(★ 2026-10-06 新增,给第二界面星空图用)
//   az/el 用 -1 表示"这句没上报" —— GSV 里这两个字段可能是空串,不能拿 0
//   当"在地平线上正北方",那是编出来的位置,星空图上会画出假点。
//   方位角本来就是相对**真北**的(NMEA 定义),所以画星空图不需要磁力计。
struct SatFix {
  uint8_t prn = 0;      // 星号
  int16_t az  = -1;     // 方位角 0..359 度
  int16_t el  = -1;     // 仰角 0..90 度(90 = 天顶)
  uint8_t cn0 = 0;      // 载噪比 dB-Hz;0 = 看得见但没信号
};

struct Talker {
  char  id[3] = {0};
  int   total = 0;
  int   seen  = 0;
  int   view  = 0;       // 该星座本次报的可见星数;全星座求和才是真正的 VIEW
  int   cn0N  = 0;
  float cn0[kCn0PerTalker] = {0};
  int     satN = 0;                  // 本帧已收到几颗星的位置
  SatFix  sat[kSatPerTalker] = {};   // ★ 2026-10-06:每颗星的位置
};

struct State {
  // ---- 来自 GGA ----
  int      quality   = 0;        // 0=无效 1=单点 2=差分 4=RTK
  int      satsUsed  = 0;        // 参与定位的星数
  // 0.0 起步:屏上干净(之前 99.9 是"没数据"哨兵,但判据已有 !fixValid 兜底,
  // 哨兵值纯属显示层噪音;首条 GGA 一到就被真实值覆盖)
  float    hdop      = 0.0f;
  double   lat       = 0;        // 十进制度
  double   lon       = 0;
  bool     fixValid  = false;
  uint32_t fixMs     = 0;

  // ---- 来自 GSV ----
  int      satsView  = 0;        // 可见星数
  float    cn0[kMaxCn0] = {0};   // 已排序(升序),仅供取中位数
  int      cn0N      = 0;
  float    cn0Median = 0;
  uint32_t cn0Ms     = 0;

  // ---- 来自 ZDA(UTC 日期与时间)★ 2026-10-01 新增 ----
  // 这是全项目**唯一**的"现在几点"来源。三个要点先说清:
  //   ① 只取**整秒**:ZDA 的时间字段是 hhmmss.ss,而 .ss 在本模块上恒为 .000
  //      (秒内相位根本不报文里,只能靠 PPS),所以小数部分直接丢。
  //   ② 日期用 ZDA 的 **4 位年**。RMC 也带日期,但只有 2 位年(ddmmyy),要自己补世纪,
  //      不如 ZDA 干净 —— 取年份一律只用 ZDA。
  //   ③ 它是 **UTC**,不是北京时间。时区换算(+8、还有跨日)是显示层的事,
  //      本命名空间不换算,免得"到底存的哪个时区"将来扯不清。
  bool     utcValid = false;   // 收到过至少一条合法 ZDA
  uint32_t utcMs    = 0;       // 最近一次更新时间(ms),用于判"超时无数据"
  int      uY = 0, uMo = 0, uD = 0;
  int      uH = 0, uMi = 0, uS = 0;
  uint32_t zdaCount = 0;       // 诊断:本句收了几条(为 0 说明模块不吐 ZDA)

  // ---- 来自 GSA(★ v1.9.0:PDOP/VDOP + 参与解算的星表)----
  //   GSA 只在"有解"时才有意义;定点解算类型(fix type)3 = 3D,2 = 2D。
  //   ★ 星表**必须是全局并集,不能按 talker 分桶** —— 实测这台模块吐的是
  //     多句 `$GNGSA`(句名一律 GN,一条对应一个星座系统)。按 talker 分桶时
  //     后一句会**覆盖**前一句,最后只剩最后一个星座的星表,其余星全被判成
  //     "没参与解算" ⇒ σ 统计的星数为 0 ⇒ HPL 永远算不出来(屏上恒 `HPL ---`)。
  //     这是 2026-10-17 首次上板实测抓到的,不是推断。
  //     代价:GPS 的 PRN 1..32 与北斗 1..63 **重号**,并集分不清谁是谁。
  //     所以 sigmaUere() 里做两级回退:并集过滤后不足 4 颗就退回"全部可见星"。
  float    pdop      = 0.0f;
  float    vdop      = 0.0f;
  int      gsaFix    = 0;        // GSA 的 fix type(1/2/3)
  uint32_t gsaCount  = 0;        // 诊断:本上电收了几条 GSA(为 0 = 模块不吐 GSA)
  // ★ 曾经想在这里存"参与解算的 PRN 并集"(uint64 位掩码)给 σ 用,
  //   实测发现本模块的 GNGSA 跨星座重号、并集无法归因,已删除 —— 见 sigmaUere()。

  // ---- 来自 RMC(★ v1.13.0/B1:对地速度,只用于归因,不进判据门限)----
  //  为什么用 RMC 不用 VTG:两者都有,但 RMC 已在模块默认输出里,VTG 要另外确认;
  //  而且 RMC 的状态位(A/V)顺手给了有效性,不用另判。
  float    sogMps   = 0;      // 对地速度 m/s(节 × 0.514444)
  uint32_t sogMs    = 0;      // 最近一次刷新(ms)
  bool     sogValid = false;  // 收到过至少一条状态为 A 的 RMC

  // ---- 计数(排查用)----
  uint32_t sentences = 0;
  uint32_t ggaCount  = 0;
  uint32_t gsvCount  = 0;
  uint32_t badCksum  = 0;
};

static State    st;
static Talker   talkers[kMaxTalker];
static int      talkerN  = 0;
static char*    fld[kMaxFld];
static uint32_t consumed = 0;      // 已解析到第几行

inline void reset() {
  st = State();
  for (int i = 0; i < kMaxTalker; ++i) talkers[i] = Talker();
  talkerN  = 0;
  consumed = 0;
}

static uint8_t hexVal(char c) {
  if (c >= '0' && c <= '9') return (uint8_t)(c - '0');
  if (c >= 'A' && c <= 'F') return (uint8_t)(c - 'A' + 10);
  if (c >= 'a' && c <= 'f') return (uint8_t)(c - 'a' + 10);
  return 255;
}

// NMEA 校验和:* 后两位 = 前 $ 之后到 * 之前所有字符的异或
static bool checksumOk(const char* s) {
  if (s[0] != '$') return false;
  const char* star = strchr(s, '*');
  if (!star || star[1] == '\0' || star[2] == '\0') return false;
  uint8_t x = 0;
  for (const char* p = s + 1; p < star; ++p) x ^= (uint8_t)(*p);
  uint8_t hi = hexVal(star[1]), lo = hexVal(star[2]);
  if (hi == 255 || lo == 255) return false;
  return x == (uint8_t)((hi << 4) | lo);
}

// 就地拆字段,入参是 '$' 之后的位置。fld[0] 是句子名(如 "GNGGA")
static int split(char* s) {
  int n = 0;
  fld[n++] = s;
  for (char* p = s; *p; ++p) {
    if (*p == ',' || *p == '*') {
      char sep = *p;
      *p = '\0';
      if (n < kMaxFld) fld[n++] = p + 1;
      if (sep == '*') break;
    }
  }
  return n;
}

// ddmm.mmmm / dddmm.mmmm -> 十进制度
static double toDeg(const char* v, char hemi) {
  if (!v || !*v) return 0.0;
  double raw = atof(v);
  int    deg = (int)(raw / 100.0);
  double min = raw - deg * 100.0;
  double d   = deg + min / 60.0;
  return (hemi == 'S' || hemi == 'W') ? -d : d;
}

static void handleGGA(int n) {
  if (n < 9) return;
  st.ggaCount++;
  st.quality  = atoi(fld[6]);
  st.satsUsed = atoi(fld[7]);
  st.hdop     = (float)atof(fld[8]);

  if (st.quality > 0 && fld[2][0] && fld[4][0]) {
    const double la = toDeg(fld[2], fld[3][0]);
    const double lo = toDeg(fld[4], fld[5][0]);
    // ★ v1.10.4(评审 S6):坐标范围校验 —— 异常报文(如 atof 吃到 "9999")原来会
    //   照单全收,distM 出 inf/nan、屏上 "inf m"、判据乱跳。超界 = 当无效帧丢弃
    //   (fixValid 不置位),与"字段为空"同路。限幅不是 clamp 成 90/180:那会造出
    //   一个"看起来合法"的假坐标,丢弃才是诚实行为。
    if (la < -90.0 || la > 90.0 || lo < -180.0 || lo > 180.0) {
      st.fixValid = false;
      return;
    }
    st.lat      = la;
    st.lon      = lo;
    st.fixValid = true;
    st.fixMs    = millis();
  } else {
    st.fixValid = false;
  }
}

// 严格取数字:空字段、占位符、缺字符一律拒绝。
// 为什么不能直接用 atoi —— 未定位时模块会给**空字段**,atoi("") = 0,
// 会静悄悄变成"0 年 0 月 0 日 00:00:00"写进屏里,比不显示更糟。
static bool digN(const char* p, int n, int& v) {
  if (!p) return false;
  v = 0;
  for (int i = 0; i < n; ++i) {
    if (p[i] < '0' || p[i] > '9') return false;
    v = v * 10 + (p[i] - '0');
  }
  return true;
}

// ---- ZDA:UTC 日期 + 时间 ----
// 原文示例(2026-10-01 农村现场实采):
//   $GNZDA,100614.000,01,10,2026,00,00*4C
//   字段: 0=句名  1=hhmmss.ss  2=日 dd  3=月 mm  4=年 yyyy  5/6=本地时区
// 月份定长两位、年份定长四位,所以逐位验数字是可行的、也是必要的。
static void handleZDA(int n) {
  if (n < 5) return;
  st.zdaCount++;

  int h, mi, s, d, mo, y;
  if (!digN(fld[1],     2, h)  || !digN(fld[1] + 2, 2, mi) ||
      !digN(fld[1] + 4, 2, s))  return;         // 时间字段不合法
  if (!digN(fld[2], 2, d) || !digN(fld[3], 2, mo) ||
      !digN(fld[4], 4, y))      return;         // 日期字段不合法

  if (h > 23 || mi > 59 || s > 60) return;      // 60 = 闰秒(留个口子,不判死)
  if (mo < 1 || mo > 12 || d < 1 || d > 31) return;
  if (y < 2020 || y > 2199) return;             // 明显是没定上位的垃圾值

  st.uH = h; st.uMi = mi; st.uS = s;
  st.uY = y; st.uMo = mo; st.uD = d;
  st.utcValid = true;
  st.utcMs    = millis();                       // 喂给显示层的"数据还新不新"
}

static Talker* talkerOf(const char* name) {
  char id[3] = { name[0], name[1], '\0' };
  for (int i = 0; i < talkerN; ++i)
    if (strcmp(talkers[i].id, id) == 0) return &talkers[i];
  if (talkerN < kMaxTalker) {
    Talker* t = &talkers[talkerN++];
    memset(t, 0, sizeof(Talker));
    strcpy(t->id, id);
    return t;
  }
  return nullptr;
}

static int cmpFloat(const void* a, const void* b) {
  float x = *(const float*)a, y = *(const float*)b;
  return (x < y) ? -1 : ((x > y) ? 1 : 0);
}

// 所有星座的 C/N0 汇总后取中位数
static void commitCn0() {
  int n = 0;
  for (int i = 0; i < talkerN; ++i)
    for (int k = 0; k < talkers[i].cn0N && n < kMaxCn0; ++k)
      st.cn0[n++] = talkers[i].cn0[k];
  if (n == 0) return;

  st.cn0N = n;
  qsort(st.cn0, n, sizeof(float), cmpFloat);
  st.cn0Median = (n & 1) ? st.cn0[n / 2]
                         : 0.5f * (st.cn0[n / 2 - 1] + st.cn0[n / 2]);
  st.cn0Ms = millis();
}

// ---- 只读查询口(★ 2026-10-06 新增,专供第二界面"动图页")----
// 和 talkerOf 的区别:这里**只找不建桶**,返回 const 指针 —— 显示层不该有副作用。
inline const Talker* readBucket(const char* id) {
  for (int i = 0; i < talkerN; ++i)
    if (strcmp(talkers[i].id, id) == 0) return &talkers[i];
  return nullptr;
}

// 某星座当前 C/N0 中位数(不在场或没数据 -> 0)。第二界面趋势曲线的数据源。
// 每次现排一遍序 —— 最多 24 个元素、一秒一次,开销可以忽略。
inline float medianOf(const char* id) {
  const Talker* t = readBucket(id);
  if (!t || t->cn0N <= 0) return 0.0f;
  float tmp[kCn0PerTalker];
  int   n = t->cn0N;
  for (int i = 0; i < n; ++i) tmp[i] = t->cn0[i];
  qsort(tmp, n, sizeof(float), cmpFloat);
  return (n & 1) ? tmp[n / 2] : 0.5f * (tmp[n / 2 - 1] + tmp[n / 2]);
}

// 北斗的 talker:老写法 "BD",新标准 "GB",两个都认。
inline float bdsMedian() {
  float a = medianOf("BD");
  return (a > 0.0f) ? a : medianOf("GB");
}

static void handleGSV(const char* name, int n) {
  if (n < 4) return;
  st.gsvCount++;

  Talker* t = talkerOf(name);
  if (!t) return;

  int total = atoi(fld[1]);
  int num   = atoi(fld[2]);
  int view  = atoi(fld[3]);

  if (num <= 1) { t->total = total; t->seen = 0; t->cn0N = 0; t->satN = 0; }
  t->seen++;
  // 可见星数按星座分别记,求和后再入 st —— 原来直接覆盖,多星座时
  // 显示的是"最后一个星座"的可见数,会出现 USED 9 / VIEW 8 的矛盾
  if (view > 0) {
    t->view = view;
    int sum = 0;
    for (int i = 0; i < talkerN; ++i) sum += talkers[i].view;
    st.satsView = sum;
  }

  // 每颗星占 4 个字段:PRN, 仰角, 方位角, C/N0
  for (int k = 4; k + 3 < n; k += 4) {
    if (!fld[k] || !fld[k][0]) continue;
    float c = (float)atof(fld[k + 3]);
    if (c > 0 && t->cn0N < kCn0PerTalker) t->cn0[t->cn0N++] = c;

    // ★ 2026-10-06:位置另存一份,给第二界面的星空图。
    //   只有 el/az 都落在合法区间才记 —— 空的、超界的一律跳过。
    //   注意这里**不要求 c > 0**:看得见但还没锁上的星(CN0=0)也是有效信息,
    //   星空图会把它画成最小的灰点,代表"在视野里但信号弱"。
    int el = -1, az = -1;
    if (fld[k + 1] && fld[k + 1][0]) el = atoi(fld[k + 1]);
    if (fld[k + 2] && fld[k + 2][0]) az = atoi(fld[k + 2]);
    if (el >= 0 && el <= 90 && az >= 0 && az < 360 && t->satN < kSatPerTalker) {
      SatFix& sf = t->sat[t->satN++];
      sf.prn = (uint8_t)atoi(fld[k]);
      sf.el  = (int16_t)el;
      sf.az  = (int16_t)az;
      sf.cn0 = (c > 0 && c < 250) ? (uint8_t)(c + 0.5f) : 0;
    }
  }

  if (t->total > 0 && t->seen >= t->total) commitCn0();
}

// ★ v1.9.0 新增:GSA —— "这套解算到底用了哪几颗星、几何因子多少"
//   $GNGSA,A,3,23,24,07,08,09,27,,,,,,1.8,1.2,1.3*3A
//     [1] 模式 A=自动/M=手动   [2] fix type 1/2/3
//     [3..14] 12 个 PRN(空位留空)   [15] PDOP  [16] HDOP  [17] VDOP
//   两点说明:
//     · 只认 **1..64** 的 PRN —— GSA 的 12 个槽位里空槽是**空串**,atoi("")=0,
//       所以"prn>0"这一条同时把空槽挡掉了,不需要额外判空指针。
//     · HDOP 还是用 GGA 的(它按"参与定位的星"算);GSA 的 HDOP 这里只做交叉对照,
//       不覆盖 —— 改口径会让 P1 门限的语义在版本之间漂移。
static void handleGSA(const char* name, int n) {
  if (n < 18) return;                    // 少了 PDOP/HDOP/VDOP 就不是完整 GSA
  (void)name;                            // ★ 不分星座:PRN 槽位不解析,见 sigmaUere() 的注释

  st.gsaCount++;
  st.gsaFix = atoi(fld[2]);
  // [3..14] 那 12 个 PRN 槽位**不解析**:本模块的多句 GNGSA 跨星座重号,
  // 归不到具体哪颗星(见 sigmaUere 的注释)。这里只取句级字段 PDOP/VDOP。

  float p = (float)atof(fld[15]);
  float v = (float)atof(fld[17]);
  if (p > 0.0f && p < 100.0f) st.pdop = p;
  if (v > 0.0f && v < 100.0f) st.vdop = v;
}

// $GNRMC,hhmmss.ss,A,llll.ll,a,yyyyy.yy,a,sog,cog,ddmmyy,mv,mvE,mode*cs
//   fld[1]=UTC 时间  fld[2]=状态(A=有效/V=无效)  fld[7]=SOG(节)  fld[8]=COG
// ★ v1.13.0(B1):只取 SOG。RMC 也带日期,但只有 2 位年,项目里时间一律走 ZDA
//   (见 st 的注释),这里绝不碰日期,免得出现第二个"现在几点"的来源。
static void handleRMC(int n) {
  if (n < 8) return;                       // 字段不够,整句丢
  if (fld[2][0] != 'A') return;            // V = 无有效解,此时的 SOG 是 0 占位,不能信
  const float kn = atof(fld[7]);
  if (!(kn >= 0.0f) || kn > 2000.0f) return;   // 防 NaN / 防垃圾值(2000 节远超任何地面设备)
  nmea::st.sogMps   = kn * 0.514444f;
  nmea::st.sogMs    = millis();
  nmea::st.sogValid = true;
}

static void feed(const char* sentence) {
  if (!sentence || sentence[0] != '$') return;
  int len = (int)strlen(sentence);
  if (len < 7 || len >= 120) return;
  if (!checksumOk(sentence)) { st.badCksum++; return; }

  char buf[120];
  memcpy(buf, sentence, len + 1);

  int n = split(buf + 1);
  if (n < 1) return;

  const char* name = fld[0];
  if (strlen(name) < 5) return;     // 句子名至少 5 字符(如 GNGGA),防止越界取 talker
  st.sentences++;

  if      (strstr(name, "GGA")) handleGGA(n);
  else if (strstr(name, "RMC")) handleRMC(n);   // ★ v1.13.0(B1):对地速度(归因用)
  else if (strstr(name, "GSV")) handleGSV(name, n);
  else if (strstr(name, "GSA")) handleGSA(name, n);   // ★ v1.9.0:PDOP/VDOP + 参与星表
  else if (strstr(name, "ZDA")) handleZDA(n);   // ★ 2026-10-01:UTC 日期 + 时间
}

// 换信源/场景时清掉旧星座的 GSV 累积 —— 否则上个场景的强星 C/N0 和
// 可见数会留在桶里,新场景的"信号差"显示会自相矛盾(实测踩过:cn0 38)。
inline void flushConstellations() {
  for (int i = 0; i < talkerN; ++i) {
    talkers[i].total = 0; talkers[i].seen = 0;
    talkers[i].view  = 0; talkers[i].cn0N  = 0;
    talkers[i].satN  = 0;                 // ★ 2026-10-06:位置也一起清,别留上个场景的星
  }
  st.satsView = 0; st.cn0N = 0; st.cn0Median = 0; st.cn0Ms = 0;
}

// 把第 1 段缓冲里"还没解析过"的行喂进来。每个 loop 都要调。
inline void drain() {
  while (consumed < gnss::totalLines) {
    uint32_t back = gnss::totalLines - 1 - consumed;
    if (back >= (uint32_t)NMEA_POOL) {          // 积压过多,丢掉最早的一段
      consumed = gnss::totalLines - NMEA_POOL;
      continue;
    }
    const char* l = gnss::recent((int)back);
    if (!l) break;
    feed(l);
    consumed++;
  }
}

}  // namespace nmea

// ----------------------------------------------------------------------------
//  状态词表(全英文)—— v1.7.0 起替代原来的 32x32 中文点阵字模(cnfont)
//  ★ 为什么要换:内置字模里只有 FONT4(Font32rle)含完整的 96 个可打印 ASCII,
//    而中文字模要给每个词单独备 128 字节点阵、还要配生成脚本。8 个状态词
//    用 ASCII 拼出来就能覆盖,省约 2.7KB flash + 2KB RAM,也顺手把"中文/英文
//    两套显示口径"这件事彻底消掉。
//  ⚠ 别用 FONT6/FONT8 画这些词:它们只含 `[space] 0-9 : - . a p m` ——
//    打 "NORMAL" 会输出一片空白(不报错、不崩,只是屏上什么都没有)。
// ----------------------------------------------------------------------------
namespace phrase {

// ★ 状态词枚举 —— 两处用途,缺一不可:
//   ① judge::Result.ph 的类型;
//   ② **状态色的唯一输入**:statusColor565(phrase, blink) 按它取色。
//   为什么不能用 judge::Level 代替:同一个 LV_LOST 对应两个不同的词 ——
//   开机从未定位 = NO-DATA(灰,正常等星),定位过又丢 = LOST(红闪,真的丢了)。
//   按 Level 取色会让"刚开机还没定位"红屏闪,看着像坏了。
enum PhraseId {
  PH_WAIT = 0, PH_SEARCH, PH_OK, PH_DEGRADED, PH_SIGBAD, PH_POSBAD, PH_LOST, PH_NODATA,
  PH_RECOVER,   // ★ v1.8.2:**只给事件日志用** —— "恢复正常"是一条独立的事件记录,
                //   不参与主界面判据(judge 永远不会产出这个值)。
  PH_HPLHIGH,   // ★ v1.9.0:完好性不足(HPL > AL)。
                //   为什么它是**独立的一个词**而不是并进 DEGRADED:
                //   两者说的不是一件事 —— DEGRADED 是"信号弱"(能测,只是不准);
                //   HPL-HIGH 是"**连'准不准'都给不出保证**"(保护级已超出告警限)。
                //   把这两个混成一个词,三态判据就退化成两态,那一整套就白做了。
  PH_DRIFT,     // ★ v1.10.1:**慢漂移**(CUSUM 积满),与 POS-BAD 分开。
                //   为什么必须分:两者的证据强度差一个数量级 ——
                //     POS-BAD = "坐标**此刻**就离基准 30 m 以上"(当场可量,红)
                //     DRIFT   = "坐标还没到 30 m,但已比 5 分钟前持续偏了 1~3 m"(趋势判断,琥珀)
                //   2026-10-17 实测:一段 POS-BAD 持续 12 分 23 秒,而两端 off 只有 19.3 / 17.3 m
                //   —— 用户看到红屏 + "数据都很好",完全不知道是被哪条点着的。
                //   合成一个词等于把"趋势"说成"事实",这就是那次困惑的来源。
  PH_NOBASE,    // ★ v1.12.0(A1):没设基准 —— 信号层全过,但位置层判据根本没跑。
                //   ★★ 只能追加在 PH_DRIFT 之后、PH_COUNT 之前:PhraseId 数值存进
                //   NVS 事件记录(EventRec.type),插中间 = 全部历史事件类型错位。
                //   颜色灰("还没到能判断的状态",与 SEARCH/NO-DATA 同档)。
                //   ★ 隐含依赖(回执 #3):NO-BASE 永不触发事件(bad 表达式无 noBase 项),
                //   所以 C3 文案表不用同步加词 —— 若将来让它落事件,必须同步 C3。
  PH_COUNT
};

// 屏上显示词(实际只出现 8 个)。PH_WAIT 与 PH_NODATA 同显示 "NO-DATA" ——
// 两者都是"还没有可用数据",屏上不必区分(串口的 tag 会区分 WAIT / NO-DATA)。
// 最宽 "DEGRADED" / "INTEG OK" / "HPL-HIGH" 都是 8 字符,FONT4 下约 152px
// < 数据条左侧 158px 领地 —— **再加长就不行了**,改词前先量宽度。
static const char* const kText[PH_COUNT] = {
  "NO-DATA",    // PH_WAIT     等待数据(一个字都没收到 / 冷启动宽限内)
  "SEARCH",     // PH_SEARCH   搜星中(有数据但还没定位)
  "INTEG OK",   // PH_OK       ★ v1.9.0:原 "NORMAL"。三态里的"保证成立"那一态
  "DEGRADED",   // PH_DEGRADED 质量降级(CN0 中位偏低)
  "SIG-BAD",    // PH_SIGBAD   信号异常(星少 / HDOP 差 / 无定位)
  "POS-BAD",    // PH_POSBAD   位置异常(坐标偏离基准 —— 疑似欺骗)
  "LOST",       // PH_LOST     信号丢失(定位过之后就没数据了)
  "NO-DATA",    // PH_NODATA   无数据
  "NORMAL",     // PH_RECOVER  恢复正常(★ 只出现在事件日志里:异常 -> 正常的转变事件)
                //   刻意**不跟着改**成 "INTEG OK":它记的是"回到正常"这个动作,
                //   而不是"当前完好性成立"这个断言。
  "HPL-HIGH",   // PH_HPLHIGH  ★ v1.9.0:保护级超出告警限 —— 此刻**报警本身不可信**
  "DRIFT",      // PH_DRIFT    ★ v1.10.1:坐标在慢慢漂(还没到 POS LIM)。
                //   5 个字符,FONT4 下约 95px —— 比 "DEGRADED"(8 字符/152px)短,宽度无忧。
  "NO-BASE",    // PH_NOBASE   ★ v1.12.0(A1):没设基准,位置层判据未跑 —— 不能报"完好"。
                //   7 字符,FONT4 下约 133px < 158px 领地,宽度安全。
};

inline const char* text(PhraseId p) {
  return (p < PH_COUNT) ? kText[p] : kText[PH_NODATA];
}

}  // namespace phrase


// ============================================================================
//  第 3 段:判据
// ----------------------------------------------------------------------------
//  ★ v1.8.3:段名里原来的"+ 注入"已删 —— 演示用的人为偏移坐标**整套移除**
//  (用户 2026-10-17 定:不再做演示)。判据现在只用**真实收到的坐标**与基准比对。
//    仍然保留"位置异常"(POS-ANOMALY)这个判据与事件类型 —— 真实世界里坐标被
//    冒名顶替时,报文看着毫无问题、只有坐标是假的,那才是它该起作用的场合。
// ============================================================================
// ★ v1.8.6:前置声明 —— 采样收尾是**异步**的(10 s 后由 update() 收),那一刻
//   也要给 C3 一条回执,所以 judge 段里要调 wifi10::rptText(定义在 3800 行之后)。
//   只此一处跨段调用,声明放这儿比把采样状态机搬出 judge 段更清爽。
namespace wifi10 { static void rptText(const char* s); }

// ★ v1.9.0:完好性 / 慢漂移 / 多径 三件套的**前置声明**。
//   定义排在 judge 之后(它要读 judge::baseSet),而 judge::update() 又要读它的结论 ——
//   互相依赖一圈,用前置声明断开即可,不必把两段揉成一坨。
namespace integ {
  void  tick(float off);     // 1 Hz 推进一次(内部自己限速)
  void  resetBaseline();     // ★ 换尺子(设/清基准)后重建 μ,旧漂移历史作废
  bool  hplBadOn();          // HPL > AL(已过迟滞)
  bool  slowOn();            // CUSUM 判定"在慢慢漂"
  bool  valid();             // 这一拍 HPL 算得出来吗
  float hpl();               // 水平保护级(米)
  int   mpCount();           // ★ v1.13.0(B4):多径星数(判据侧只读)
  float mpPeak();            // ★ v1.13.0(B4):最强多径残差 dB(判据侧只读)
}

namespace judge {

enum Level  { LV_OK = 0, LV_DEGRADED, LV_ABNORMAL, LV_LOST };
enum Reason { R_NONE = 0, R_SIGNAL, R_POSITION, R_NODATA };

// ★ v1.13.0(B5):归因枚举。只回答"这条异常像什么",不回答"算不算异常"(那是 level 的事)。
//   优先级 STEP > MP > SOL:宁可把真位移当真,也不要把真位移说成多径。
enum Cause : uint8_t {
  C_NONE = 0,   // 说不清,或正常态
  C_STEP = 1,   // 阶跃 —— 最像真位移
  C_MP   = 2,   // 多径 —— 城市反射
  C_SOL  = 3,   // 解算精度不足 —— 数值在 HPL 允许范围内
};

struct Result {
  Level  level  = LV_LOST;
  Reason reason = R_NODATA;
  phrase::PhraseId ph = phrase::PH_WAIT;       // ★ v1.7.0:屏上状态词(英文,见 phrase::kText)
                                               //   注:字段名用 ph 不用 phrase —— 与命名空间
                                               //   `phrase` 同名会被同名遮蔽规则盯上,可读性也差
  const char* tag = "WAIT";                    // 串口报表用的 ASCII 标签
  float offsetM = 0;
  Cause  cause  = C_NONE;      // ★ v1.13.0:归因(只做标注,不参与报警判定)
};

static Result      res;
static double      baseLat   = 0, baseLon = 0;
static bool        baseSet   = false;
static uint32_t    badSince  = 0, goodSince = 0;
static bool        alarm     = false;
static uint32_t    bootMs    = 0;
static bool        everFixed = false;      // 是否成功定位过
static Preferences prefs;

// ---- ★ v1.8.6:设基准的 P1/P2 状态(定义排在这里,因为 clearBase() 要中断采样)----
// 详见下面 saveBase() 之后的整段说明。
// ★ v1.10.0:原来这里有两个 constexpr(kBaseMinSats = 6 / kBaseMaxHdop = 2.0),
//   **已搬进 tune 参数表**(PARAMS 页的 SAT MIN / HDOP MAX)。搬的理由很具体:
//   这两个是现场最想调的门 —— 2026-10-17 实测 HDOP 在 2.1~2.4 晃了 3 分钟才等到
//   1.4 的窗口,而 2.0 的闸一卡就是一整轮。现在可以在屏上当场放宽,不用改代码重烧。
//   默认值仍是 6 / 2.0 ⇒ 不动它就是原来那个行为。
constexpr uint32_t kBaseSmpMs     = 10000;   // P2 采样窗口(10 s)
constexpr int      kBaseSmpMinN   = 8;       // 窗口内至少要有 8 个有效样本
constexpr float    kBaseSmpMaxSpr = 25.0f;   // 样本极差上限(米)

static bool     smpOn    = false;
static uint32_t smpT0    = 0, smpLast = 0;
static int      smpN     = 0;
static double   smpSumLat = 0, smpSumLon = 0;
static double   smpMinLat = 0, smpMaxLat = 0, smpMinLon = 0, smpMaxLon = 0;

// ---------------- 工具 ----------------
static float distM(double lat1, double lon1, double lat2, double lon2) {
  const double R = 6371000.0, D2R = 0.017453292519943295;
  double p1 = lat1 * D2R, p2 = lat2 * D2R;
  double dp = (lat2 - lat1) * D2R, dl = (lon2 - lon1) * D2R;
  double a  = sin(dp / 2) * sin(dp / 2) + cos(p1) * cos(p2) * sin(dl / 2) * sin(dl / 2);
  if (a > 1.0) a = 1.0;
  return (float)(R * 2 * atan2(sqrt(a), sqrt(1 - a)));
}

inline void begin() {
  bootMs = millis();
}

// ---------------- 基准坐标(★★ v1.7.0:改回**持久化**,带三条防护) ----------------
// 2026-09-29 曾按用户要求改成"会话制"(不落盘);2026-10-16 用户拍板改回落盘。
// 当年踩的坑**不是落盘本身,而是"落了分不清"** —— 没有来源标记,看不出这个 SET
// 是刚设的还是上次残留的。所以恢复 NVS 的同时必须配防护,缺一不可:
//   ① **来源标签**  屏上 BASE 键三态:--- 无 / SET 本次设 / SAV 从 flash 恢复
//   ② **合法性校验** magic + ver + 坐标范围 + 非 (0,0) —— 空 NVS / flash 垃圾不会被当基准
//   ③ ~~inject 不落盘~~ ★ v1.8.3 作废:注入功能已整体删除,不再有"重启后忘了关
//      导致屏上直接 POS-BAD"的可能。这条防护随之退休(只留 ① ② 两条)。
// 附加收益:串口工具一开端口会拉 RTS/DTR 复位芯片(本项目老坑),复位后基准不再丢,
// 只有串口 'c' 能清。写入频率也无需担心:saveBase 只在人主动设基准那一刻写,
// 一场演示约 20 次 vs NVS 页擦写寿命约 10 万次 —— 差 3 个数量级。
constexpr const char* kNvsName  = "gnsjudge";    // 独立命名空间(不与 gnstouch / gnsevt / wifi10 混)
constexpr uint32_t    kBaseMagic = 0x47534A31u;  // 'GSJ1'
constexpr uint16_t    kBaseVer   = 1;

// 基准来源。屏上/串口都按它显示三态。
enum BaseSrc : uint8_t { SRC_NONE = 0, SRC_SET = 1, SRC_SAV = 2 };
static uint8_t baseSrc = SRC_NONE;

struct BaseBlob {
  uint32_t magic; uint16_t ver; uint16_t flags;   // flags: bit0 = utcOk
  double   lat, lon; uint32_t setUtc;             // setUtc = 设基准那一刻的**当天秒**(UTC)
};
static_assert(sizeof(BaseBlob) == 32, "BaseBlob 布局变了 —— NVS 里的旧基准会读不出来");
constexpr int kBlobSize = 28;                     // 只写前 28 字节,已含全部字段(尾部 4B 是对齐填充)

inline bool blobOk(const BaseBlob& b) {
  if (b.magic != kBaseMagic || b.ver != kBaseVer) return false;
  if (b.lat < -90.0 || b.lat > 90.0)   return false;   // 纬度范围
  if (b.lon < -180.0 || b.lon > 180.0) return false;   // 经度范围
  if (b.lat == 0.0 && b.lon == 0.0)    return false;   // (0,0) 在几内亚湾,不可能是台架
  return true;
}

inline void storeBase() {
  BaseBlob b;
  b.magic  = kBaseMagic;
  b.ver    = kBaseVer;
  b.flags  = nmea::st.utcValid ? 0x0001 : 0x0000;
  b.lat    = baseLat;
  b.lon    = baseLon;
  b.setUtc = (uint32_t)nmea::st.uH * 3600u + (uint32_t)nmea::st.uMi * 60u + (uint32_t)nmea::st.uS;
  prefs.putBytes("base", &b, kBlobSize);
}

// setup() 里在 judge::begin() 之后调用。★ 这里自己 begin 命名空间 —— 之后
// saveBase / clearBase 直接可用(它们只可能在 setup 跑完之后被触摸/串口触发)。
inline void loadBase() {
  prefs.begin(kNvsName, false);
  if (prefs.getBytesLength("base") != kBlobSize) return;    // 没存过 / 长度不对 -> 保持无基准
  BaseBlob b;
  if (prefs.getBytes("base", &b, kBlobSize) != kBlobSize) return;
  if (!blobOk(b)) return;                                   // 垃圾数据 -> 忽略(防护 ②)
  baseLat = b.lat; baseLon = b.lon;
  baseSet = true;
  baseSrc = SRC_SAV;                                        // ★ 关键:来源是"恢复",不是"本次设"
  Serial.printf("[bench] base restored from NVS (SAV %.5f,%.5f)\n", baseLat, baseLon);
}

// ---- ★ v1.13.0(B2):off 的慢采样历史,每 5 s 存一格,12 格 = 60 s ----
//  为什么 5 s 而不是 1 Hz:阶跃是秒级事件,1 Hz 记 60 格要 240 B 且没必要;
//  5 s 粒度对"被撞"完全够(撞完会停住几十秒以上),内存只要 48 B。
//  kStepM = 8.0 的依据(2026-10-23 用户口径):随风晃(厘米级)、日晒热胀(mm/h)、
//  基础缓慢下沉(mm/天)都**不算异常**,这三类 60 s 内位移远小于 8 m;杆体被撞、
//  设备被搬动的可辨识下限在这个量级以上。8 m 同时是 30 m 门限的约 1/4,不与主门限打架。
constexpr uint8_t  kStepSlots   = 12;
constexpr uint32_t kStepSlotMs  = 5000;
constexpr float    kStepM       = 8.0f;     // 60 s 内变化 ≥ 8 m 视为阶跃
constexpr uint32_t kStepHoldMs  = 120000;   // 阶跃标志保持 2 min(事件落笔可能晚于跳变)

static float    sStepHist[kStepSlots] = {0};
static uint8_t  sStepIdx    = 0;
static uint32_t sStepLastMs = 0;
static bool     sStepFull   = false;
static uint32_t sStepAtMs   = 0;     // 最近一次判定为阶跃的时刻

inline void saveBase(double lat, double lon) {
  baseLat = lat;
  baseLon = lon;
  baseSet = true;
  baseSrc = SRC_SET;                                        // ★ 来源是"本次设"
  storeBase();                                              // ★ v1.7.0:落盘
  // ★ v1.9.0:换基准 = 换尺子 ⇒ CUSUM 的 μ 必须重建。
  //   不重建的后果不是误报而是**漏报**:μ 还记着旧基准下那个偏了 200 m 的
  //   off,新的 off 从 0 起算,dev 长期为负,统计量永远压在 0,"真漂了也不报"。
  integ::resetBaseline();
  // ★ v1.13.0(B2):阶跃缓冲一并清零 —— 新基准的 off 从 0 起步,旧缓冲里的
  //   200 m 会让下一格(5 s 后)立刻误判成 STEP。
  sStepIdx = 0; sStepFull = false; sStepLastMs = 0; sStepAtMs = 0;
}

inline void clearBase() {
  baseLat = 0; baseLon = 0;
  baseSet = false;
  baseSrc = SRC_NONE;
  smpOn   = false; smpN = 0;                                // ★ v1.8.6:清基准同时中断采样
  prefs.remove("base");                                     // ★ v1.7.0:擦掉 flash 里那份
  integ::resetBaseline();                                   // ★ v1.9.0:同上
  sStepIdx = 0; sStepFull = false; sStepLastMs = 0; sStepAtMs = 0;   // ★ v1.13.0(B2):同上
}

// ============================================================================
//  ★ v1.8.6:设基准的两道新闸 —— P1 质量门限 + P2 10 s 采样平均
//  (用户 2026-10-17 拍板:"P1+P2 一起做")
// ----------------------------------------------------------------------------
//  **为什么必须加**(2026-10-17 现场实证,不是猜测):
//    NVS 里那份基准是 (30.69018,103.89323),而 10-16 文档记录的同一台架坐标是
//    (30.68835,103.89316) —— 相距 203.6 m,且**几乎纯纬向**(203.7 m)。当时现场
//    抓到的却是 `sat 8/20 | hdop 1.9 | cn0 31`(好定位)却恒报 POS-ANOMALY off=248m。
//    按 248 m 反推当前点 ≈ 30.68800,与 10-16 那份只差 39 m(正常噪声)
//    ⇒ 收进来的坐标是对的,**错的是尺子**:存基准那一刻的定位是坏的。
//  根因:老 saveBase() 的准入只有 `fixValid` —— **"有定位"不等于"定位准"**。
//    冷启动首解、半边天遮挡、窗边/墙边多径,都能给出 fixValid=true 而偏几百米的
//    解;按一下 BASE 就把它写进 flash,之后每次开机都拿它当基准,
//    表现出来就像"设备永久漂移 200 米",而且断电重启也甩不掉。
//  两道闸:
//    P1 质量门限:fixValid + 星数 >= 6 + HDOP <= 2.0 + 定位新鲜(< TH_STALE_MS),
//       任一不满足**直接拒绝**,不落盘,并把原因回执给 C3(产线工装看得见)。
//    P2 采样平均:门限过了也**不当场落盘**,先 1 Hz 采 10 s,要求样本极差 <= 25 m,
//       通过才把**均值**写进 flash。这样连"HDOP 好看但位置还在跳"也能挡住。
//  采样期间屏上第 1 键变 `CANCEL`(v1.13.0,原为 `SET 10..0` 倒计时)+ 顶部绿进度条;
//  再点一下即取消(见 cancelBaseSample)/ 清基准也中断采样(见 clearBase)。
// ============================================================================
inline bool baseSmpOn() { return smpOn; }

// 0..10 = 十等分进度(给 btnState/paintBot 画倒计时与进度条)
inline uint8_t baseSmpStep() {
  if (!smpOn) return 0;
  const uint32_t h = millis() - smpT0;
  return (uint8_t)(h >= kBaseSmpMs ? 10 : (h * 10u) / kBaseSmpMs);
}

// P1 门限。返回 nullptr = 通过;否则是一句 ASCII 短标签(串口与 C3 回执都用它)。
// ★ v1.10.0:后两条读 tune::satMin() / tune::hdopMax() —— PARAMS 页改完**立即生效**,
//   但只对"下一次按 BASE"生效(已存好的基准不会被追溯判废,那样等于自己把自己推翻)。
inline const char* baseGateFail() {
  if (!nmea::st.fixValid)                        return "no fix";
  if ((millis() - nmea::st.fixMs) > TH_STALE_MS) return "fix stale";
  if (nmea::st.satsUsed < tune::satMin())        return "too few sats";
  if (nmea::st.hdop > tune::hdopMax())           return "hdop too high";
  return nullptr;
}

// 开始采样。返回 false = 已经在采样中(重复按 BASE 不清零重来)。
inline bool beginBaseSample() {
  if (smpOn) return false;
  smpOn = true; smpT0 = millis(); smpLast = 0; smpN = 0;
  smpSumLat = smpSumLon = 0;
  return true;
}

// ★ v1.13.0:取消进行中的采样(用户拍板:倒计时中点 BASE 键即取消,不必绕 CLR-BS 长按)。
//   只掐采样本身:不落盘、不动 NVS、不动已有基准、不重建 CUSUM(采样从未改过尺子)。
//   返回 false = 本来就不在采样中(调用方不必重复提示)。
inline bool cancelBaseSample() {
  if (!smpOn) return false;
  smpOn = false; smpN = 0;
  Serial.println("[bench] base sampling cancelled");
  return true;
}

// ---- ★ v1.13.0(B1):静止判定(只用于归因,不进判据门限)----
// kStaticSog 的依据:GNSS 多普勒测速在静止时的噪声典型 0.02~0.10 m/s
// (开源接收机实测口径),取 0.30 留 3 倍余量。这个数**不是可调项**,不进 tune ——
// 它是物理分辨率,不是策略选择,放到 PARAMS 页只会让人乱调。
constexpr float    kStaticSog      = 0.30f;   // m/s
constexpr uint32_t kStaticFreshMs  = 3000;    // RMC 超过 3 s 没刷新就不算数
inline bool isStaticNow() {
  return nmea::st.sogValid
      && (millis() - nmea::st.sogMs < kStaticFreshMs)
      && (nmea::st.sogMps < kStaticSog);
}

// 归因名字(串口/详情页/CSV 三处共用;C_NONE 显示 "---")
inline const char* causeName(Cause c) {
  switch (c) {
    case C_STEP: return "STEP";
    case C_MP:   return "MP";
    case C_SOL:  return "SOL";
    default:     return "---";
  }
}

// P2 采样一拍:1 Hz 收一个点;到 10 s 收尾判极差,通过就把均值落盘。
// 由 update() 每圈调用 —— 全程非阻塞,GNSS 主循环不受影响。
static void sampleStep(uint32_t now) {
  if (smpN == 0 || (now - smpLast) >= 1000) {
    if (nmea::st.fixValid && (now - nmea::st.fixMs) <= TH_STALE_MS) {
      const double la = nmea::st.lat, lo = nmea::st.lon;
      if (smpN == 0) { smpMinLat = smpMaxLat = la; smpMinLon = smpMaxLon = lo; }
      else {
        if (la < smpMinLat) smpMinLat = la;
        if (la > smpMaxLat) smpMaxLat = la;
        if (lo < smpMinLon) smpMinLon = lo;
        if (lo > smpMaxLon) smpMaxLon = lo;
      }
      smpSumLat += la; smpSumLon += lo; ++smpN;
      smpLast = now;
    }
  }
  if ((now - smpT0) < kBaseSmpMs) return;      // 窗口还没满

  smpOn = false;
  const float spread = (smpN > 1) ? distM(smpMinLat, smpMinLon, smpMaxLat, smpMaxLon) : 9999.0f;

  if (smpN < kBaseSmpMinN) {
    Serial.printf("[bench] base NOT saved: only %d/%d samples in %us (hold still, open sky)\n",
                  smpN, kBaseSmpMinN, (unsigned)(kBaseSmpMs / 1000u));
    wifi10::rptText("base NOT saved: too few samples");
    return;
  }
  if (spread > kBaseSmpMaxSpr) {
    Serial.printf("[bench] base NOT saved: unstable, spread %.0fm > %.0fm (%d samples)\n",
                  spread, kBaseSmpMaxSpr, smpN);
    wifi10::rptText("base NOT saved: unstable");
    return;
  }

  saveBase(smpSumLat / smpN, smpSumLon / smpN);
  // 换尺子 ⇒ 旧报警作废:否则屏上还要再红 8 秒(TH_RECOVER_MS)才转绿,
  // 现场会误以为"刚设完还是漂"。
  alarm = false; badSince = 0; goodSince = now;
  Serial.printf("[bench] base saved: avg of %d samples, spread %.1fm (sat %d, hdop %.1f)\n",
                smpN, spread, nmea::st.satsUsed, nmea::st.hdop);
  wifi10::rptText("base saved (10s avg)");
}

// 统一入口 —— 触摸第 1 键 / 串口 'b' / C3 下发 'b' 三个入口都只走这一条路。
// 返回 true = 已开始采样(10 s 后自动落盘或自动放弃)。
// msgOut 收一条**给 C3 的短回执**(34 列以内),成功/失败都有 —— 三个调用点
// 只管把它丢给 wifi10::rptText(),不各自拼文案(避免三份文案漂移)。
inline bool requestBase(char* msgOut, size_t msgN) {
  if (smpOn) {                                  // 采样中再按:不重来,只提示
    if (msgN) snprintf(msgOut, msgN, "base: sampling...");
    Serial.println("[bench] base: sampling already in progress");
    return false;
  }
  const char* why = baseGateFail();
  if (why) {
    if (msgN) {
      if (!strcmp(why, "too few sats") || !strcmp(why, "hdop too high"))
        snprintf(msgOut, msgN, "weak fix sat%d hdop%.1f need 6/2.0",
                 nmea::st.satsUsed, nmea::st.hdop);
      else
        snprintf(msgOut, msgN, "%s - base NOT saved", why);
    }
    Serial.printf("[bench] base NOT saved: %s (sat %d/%d, hdop %.1f)\n",
                  why, nmea::st.satsUsed, nmea::st.satsView, nmea::st.hdop);
    return false;
  }
  beginBaseSample();
  if (msgN) snprintf(msgOut, msgN, "base: sampling %us hold still", (unsigned)(kBaseSmpMs / 1000u));
  Serial.printf("[bench] base: sampling %us, hold still (sat %d, hdop %.1f)\n",
                (unsigned)(kBaseSmpMs / 1000u), nmea::st.satsUsed, nmea::st.hdop);
  return true;
}

// ---------------- 主判据 ----------------
inline void update() {
  uint32_t now = millis();

  if (smpOn) sampleStep(now);      // ★ v1.8.6:P2 采样(10 s 后在这里收尾落盘)

  if (nmea::st.fixValid) everFixed = true;

  // 一个字都没收到 -> "等待数据"(多半是接线/波特率问题,不是信号异常)
  // ★ 2026-10-01:补 stored 兜底。原来只看 totalLines == 0,但它是 uint32 计数,
  //   连续跑约 5 天回绕时恰好经过 0,那一瞬会被误判成"无数据"(屏闪一下)。
  //   池里还留着历史行(stored > 0)就说明数据一直在来,不该判无数据。
  bool noData = (gnss::totalLines == 0 && gnss::stored == 0);

  // 冷启动宽限:从没定过位、且开机不到 90 s —— 这段时间只提示"搜星中",不报警。
  // 否则上电头几秒必然"无定位",会当场报警,现场看着像设备坏了。
  bool warming = noData || ((!everFixed) && ((now - bootMs) < TH_COLDSTART_MS));

  bool stale = (now - nmea::st.fixMs) > TH_STALE_MS;

  // 参与比对的坐标:**就是收到的真实坐标**(★ v1.8.3 起没有"注入偏移"这条岔路了,
  // 原来这里有一段 `if (inject && baseSet) { cmpLat = injLat; ... }`)
  // ★ v1.10.4(评审 P1):**只在输入变化时重算** —— 坐标 1 Hz 才更新、基准更罕见变,
  //   而本函数 loop 每圈都进;原来每圈白算一轮 double Haversine(4 次软件 sin/cos +
  //   atan2,ESP32-S3 无 FP64 硬件)。缓存键 = (fixMs, 基准坐标),任一变化才重算;
  //   **数值与原实现逐位一致**(不是换近似公式,判据口径不动)。
  float off = 0;
  if (baseSet) {
    static uint32_t cFixMs = 0;
    static double   cBLat = 0, cBLon = 0;
    static float    cOff  = 0;
    if (nmea::st.fixMs != cFixMs || baseLat != cBLat || baseLon != cBLon) {
      cFixMs = nmea::st.fixMs; cBLat = baseLat; cBLon = baseLon;
      cOff   = distM(baseLat, baseLon, nmea::st.lat, nmea::st.lon);
    }
    off = cOff;
  }

  // ★ v1.9.0:推进三件套(完好性 / CUSUM / 多径)。内部自己限速到 1 Hz,
  //   所以放在这里每圈调用是安全的 —— 它的输入本来就只有 1 Hz 的 NMEA。
  integ::tick(off);

  // ---- ★ v1.13.0(B2):阶跃检测(只记标志,不参与是否报警)----
  const uint32_t nowMs = millis();
  if (sStepLastMs == 0 || (nowMs - sStepLastMs) >= kStepSlotMs) {
    // 取样前先比:idx 指向的正是"12 格之前"那一格(最老)。
    // sStepFull 之前不能比 —— 前 60 s 缓冲里是 0,off 一上来就 30 m 会立刻误判。
    if (sStepFull && fabsf(off - sStepHist[sStepIdx]) >= kStepM)
      sStepAtMs = nowMs;
    sStepHist[sStepIdx] = off;
    sStepIdx = (uint8_t)((sStepIdx + 1) % kStepSlots);
    if (sStepIdx == 0) sStepFull = true;
    sStepLastMs = nowMs;
  }
  const bool stepNow = (sStepAtMs != 0) && ((nowMs - sStepAtMs) < kStepHoldMs);

  const bool hplBad = integ::hplBadOn();

  bool sigBad  = stale
              || (!nmea::st.fixValid)
              || (nmea::st.satsUsed < TH_MIN_SATS_USED)
              || (nmea::st.hdop > TH_MAX_HDOP);
  // ★ v1.9.0 三态判据(用户 2026-10-17 定):**位置异常要先过完好性这一关**。
  //   ① off > 30 m          = 坐标对不上基准(老判据)
  //   ② integ::slowOn()     = CUSUM 抓到"还没到 30 m 但在持续拉偏"(新判据)
  //   ③ !hplBad             = "此刻我有资格下这个结论"(新判据)
  //   为什么 ③ 是"与"、不是"或":HPL > AL 时,连"现在这组坐标的误差上限"都给不出保证,
  //   这时候报 POS-BAD 等于**把系统误差说成攻击** —— 那才是真正的误报。
  //   代价必须说清:这段时间里真出事也不会报 POS-BAD,状态词会停在 HPL-HIGH。
  //   这是**有意**的取舍(航空界也是这么做的:HPL > AL ⇒ 完好性不可用)。
  // ★ v1.10.0:30 m 这个数改成 tune::posLim() —— 屏上 PARAMS 页可调,**改完立即生效**
  //   (下一个 1 Hz 判据拍就用新值)。默认 30,与 v1.9.0 完全一致。
  // ★★ v1.10.1:把原来的 `posBad` **拆成两条**,各给各的词:
  //   overLim = 坐标**此刻**就离基准超过 POS LIM —— 当场可量的事实 ⇒ POS-BAD(红)
  //   driftOn = 还没过线,但 CUSUM 认为在持续拉偏   —— 趋势判断   ⇒ DRIFT(琥珀)
  //   拆的依据是 2026-10-17 的实测:一段 POS-BAD 持续 12 分 23 秒,而它两端的 off
  //   只有 19.3 / 17.3 m(门槛 30)。也就是说**红屏亮了 12 分钟,却没有一分钟真的越线**
  //   —— 用户当场就问"数据都很好,为什么是 POS-BAD"。词和证据对不上,就是这个后果。
  //   排序仍是**距离优先**:同时成立时报 POS-BAD,因为事实强于趋势。
  const bool overLim = baseSet && !hplBad && (off > tune::posLim());
  const bool driftOn = baseSet && !hplBad && !overLim && integ::slowOn();

  // ---- ★ v1.13.0(B3/B4):归因证据(只标注,不影响 bad/alarm 的任何一项)----
  // B3:越线,但偏差仍在 2×HPL 之内 —— 当前解的误差上限本来就允许这么大。
  //   系数 2.0 的依据:保护级是"99.999% 不超"的包络,HPL 本身已含 ~3.3σ 量级;
  //   再乘 2 是极宽松的门,只用来识别"明显由解算精度解释得掉"的那一档。
  //   这一档**照旧报警**,只是标 cause=SOL,让人知道先怀疑天空,别先怀疑设备。
  //   integ::valid() 必须显式判:HPL=0(无有效解)时 off < 0 恒假,但依赖太隐晦。
  const bool solLimited = overLim && integ::valid() && (off < 2.0f * integ::hpl());
  // B4:多径疑似:越线 + 至少 2 颗星明显强于模板。
  //   n≥2 而不是 n≥1:单颗星的残差异常太常见(一颗低仰角星被挡一下就够了),
  //   要 2 颗同时成立才算"环境特征",否则会把噪声当多径。
  //   强度门槛复用 tune::mpThrDb()(默认 10 dB),不新增参数。
  const bool mpSuspect  = overLim
                       && (integ::mpCount() >= 2)
                       && (integ::mpPeak()  >= tune::mpThrDb());
  // 优先级 STEP > MP > SOL:宁可把真位移当真,也不要把真位移说成多径。
  auto causeOf = [](bool st, bool mp, bool sol) -> Cause {
    if (st)  return C_STEP;
    if (mp)  return C_MP;
    if (sol) return C_SOL;
    return C_NONE;
  };
  const Cause nowCause = causeOf(stepNow, mpSuspect, solLimited);

  bool qualBad = (nmea::st.cn0Ms != 0)
              && ((now - nmea::st.cn0Ms) < TH_STALE_MS)
              && (nmea::st.cn0Median < tune::cn0Min());

  bool bad = (sigBad || overLim || driftOn || hplBad) && !warming;

  if (bad) { if (badSince == 0) badSince = now; goodSince = 0; }
  else     { if (goodSince == 0) goodSince = now; badSince = 0; }

  // ★ v1.10.0:HOLD / RECOVER 也从 tune 读(屏上单位是秒,这里换算成 ms)。
  //   它们同时管主状态机和 HPL 迟滞 —— 一组时间常数只能有一个真源。
  if (alarm) {
    if (!bad && goodSince && (now - goodSince >= tune::recoverMs())) alarm = false;
  } else {
    if (bad && badSince && (now - badSince >= tune::holdMs())) alarm = true;
  }

  if (!alarm) {
    if (noData) {
      res.level = LV_DEGRADED; res.reason = R_NODATA;
      res.ph = phrase::PH_WAIT;    res.tag = "WAIT";
    } else if (warming) {
      res.level = LV_DEGRADED; res.reason = R_NODATA;
      res.ph = phrase::PH_SEARCH;  res.tag = "SEARCH";
    } else if (stale) {
      res.level = LV_LOST;     res.reason = R_NODATA;
      res.ph = phrase::PH_NODATA;  res.tag = "NO-DATA";
    } else if (hplBad) {
      // ★ v1.9.0:信号还在、坐标也没偏,但**保护级已经超出告警限** ——
      //   这一态在老固件里没有落脚处(会被说成 NORMAL),是这次新增的第三态。
      res.level = LV_DEGRADED; res.reason = R_SIGNAL;
      res.ph = phrase::PH_HPLHIGH; res.tag = "HPL-HIGH";
    } else if (qualBad) {
      res.level = LV_DEGRADED; res.reason = R_SIGNAL;
      res.ph = phrase::PH_DEGRADED; res.tag = "DEGRADED";
    } else if (!baseSet) {
      // ★ v1.12.0(A1):信号层全过,但位置层判不了 —— 不能报"完好"。
      //   优先级必须是 信号层 > NO-BASE > 位置层(SIG-BAD/LOST/HPL-HIGH/DEGRADED
      //   都不依赖基准,不能被"没基准"盖掉)。level 取 DEGRADED 而非 OK:
      //   bad 表达式里没有 noBase 项,不会触发告警/事件抖动;level 只影响
      //   串口 s 的等级字 —— "完好性未评估"属于降级,不属于正常。
      res.level = LV_DEGRADED; res.reason = R_NONE;
      res.ph = phrase::PH_NOBASE;  res.tag = "NO-BASE";
    } else {
      res.level = LV_OK;       res.reason = R_NONE;
      // ★ v1.9.0:tag 跟屏上一致改成 INTEG-OK(原来叫 NORMAL)。
      //   改的理由很实际:**串口和屏必须是同一套口径** —— 现场排障时一边看屏
      //   一边敲 s,两个词对不上就会怀疑是不是又出了岔子。连字符而非空格,
      //   与 SIG-BAD / POS-BAD / HPL-HIGH 保持同一种写法。
      res.ph = phrase::PH_OK;      res.tag = "INTEG-OK";
    }
  } else {
    // 判断顺序有讲究:
    //   信号本身失真(星少 / HDOP 差 / 无定位)-> "信号异常",证据直接
    //   信号看着完好、只有坐标对不上          -> "位置异常",这才是疑似欺骗的特征
    if (stale) {
      res.level = LV_LOST;     res.reason = R_NODATA;
      res.ph = phrase::PH_LOST;    res.tag = "LOST";
    } else if (sigBad) {
      res.level = LV_ABNORMAL; res.reason = R_SIGNAL;
      res.ph = phrase::PH_SIGBAD;  res.tag = "SIG-ABNORMAL";
    } else if (overLim) {
      res.level = LV_ABNORMAL; res.reason = R_POSITION;
      res.ph = phrase::PH_POSBAD;  res.tag = "POS-ANOMALY";
    } else if (driftOn) {
      // ★ v1.10.1:坐标**还没**越 POS LIM,但 CUSUM 认定在持续拉偏。
      //   等级给 DEGRADED(与 HPL-HIGH 同档),词单独一个 DRIFT —— 因为它的证据
      //   只到"趋势",不像 POS-BAD 那样"当场就能量给你看"。
      res.level = LV_DEGRADED; res.reason = R_POSITION;
      res.ph = phrase::PH_DRIFT;   res.tag = "DRIFT";
    } else if (hplBad) {
      // 到这一步说明:sigBad / overLim / driftOn 都不成立,只有完好性不足。
      // 它是唯一一个"进了报警状态、却只算 DEGRADED 等级"的词 —— 因为
      // 设备本身没坏,是**外部条件**让它给不出保证。
      res.level = LV_DEGRADED; res.reason = R_SIGNAL;
      res.ph = phrase::PH_HPLHIGH; res.tag = "HPL-HIGH";
    } else {
      // ★ v1.9.0:走到这里 = 报警还挂着(等它 8 s 自然解除),但 sigBad / posBad /
      //   hplBad **四条都已经不成立**了。此时**什么词都不改**,沿用上一拍的 —— 
      //   它们还留在 judge::res 里(命名空间级结构,跨调用保活)。
      //   以前这里是硬写 SIG-ABNORMAL,加了 HPL-HIGH 之后就露馅了:
      //   HPL 一降回 AL 以下,屏上会冒出一次**假的"信号异常"**(实测 T15 那拍),
      //   设备明明好好的却说自己信号坏了 —— 这种假词比不说更难解释。
      res.level = LV_ABNORMAL; res.reason = R_SIGNAL;
    }
  }

  res.offsetM = off;
  res.cause  = nowCause;    // ★ v1.13.0(B5):归因只标注;放在状态词分支之后,防被覆盖
}

}  // namespace judge

// ============================================================================
//  ★★ v1.9.0:完好性 / 慢漂移 / 多径 —— 三个"能报名字"的算法
// ----------------------------------------------------------------------------
//  为什么要单开一段、而不是塞进 judge:
//    judge 干的是"按阈值下结论"(有解/无解、漂没漂);
//    这一段算的是"**这些结论本身有多可信**"(保护级 / 趋势 / 信号质量)。
//    两者混在一起,以后动一个必碰另一个,所以分开。
//  一并声明边界(答辩会被问,先说清):
//    · 输入只有 NMEA 的**结果量**(GGA 的 HDOP/星数、GSA 的 PDOP/VDOP/参与星表、
//      GSV 的仰角/方位/C-N0),**没有伪距/星历/载波** ⇒ 做的是解域完好性,
//      不是测量域 RAIM。三者都不是认证级参数,一律标 "est"。
//    · 全部在 ESP32-S3 的单精度 FPU 上跑,1 Hz 一拍,实测开销可忽略
//      (每拍 ~30 次 powf + 2x2 矩阵几次乘加)。
// ============================================================================
namespace integ {

struct State {
  bool  valid  = false;   // 这一拍 HPL 算出来了吗
  float hpl    = 0;       // 水平保护级(米,est)
  float vpl    = 0;       // 垂直保护级(米,est)
  float sigma  = 0;       // σ_UERE 代表值(米)
  int   nSig   = 0;       // 参与 σ 统计的星数
  float cusum  = 0;       // 单侧(向上)CUSUM 统计量(m·s)
  bool  gated  = false;   // ★ v1.14.12:统计量正被绝对闸拦着(off 滤波 ≤ 15 m)
  bool  slow   = false;   // 已判定"在慢慢漂"
  int   mpN    = 0;       // 多径可疑星数
  float mpMax  = 0;       // 最大正残差(dB)
  int   mpPrn  = 0;       // 残差最大的那颗(给屏上写 PRN)
  int   mpEl   = -1;
  bool  hplBad = false;   // HPL > AL(已过迟滞)
};
static State g;

// ---------------- ① 单星测距噪声 ----------------
inline float sigmaOf(float cn0) {
  float s = kSigRefM * powf(10.0f, (kCn0Ref - cn0) / 20.0f);
  if (s < kSigMinM) s = kSigMinM;
  if (s > kSigMaxM) s = kSigMaxM;
  return s;
}

// σ_UERE = 参与解算那批星的 σ² 均方根。
// 为什么不是"按 1/σ² 加权":那样会几乎只由最强的一两颗星决定,
// 而保护级要回答的是"**最坏情况下**我能保证多少",用平均值更保守。
//
// ★ "参与解算那批星"怎么取 —— 这里踩过一个坑,记录在案:
//   第一版想用 GSA 的星表过滤,上板实测发现**不行**:这台模块吐的是多句 `$GNGSA`,
//   句名一律 "GN",而 PRN 跨星座重号(GPS 1..32 / 北斗 1..63)。并集一 OR,
//   几乎每颗星都"命中",连 CN0≈20 的弱星也算进来 ⇒ σ 被拉到 8.7 m、
//   HPL 常年 40 m、屏上一直 HPL-HIGH(实测 2026-10-17,不是推测)。
//   ⇒ 改用**按 CN0 取最强的 k 颗**(k = GGA 的 satsUsed)。接收机选星本来就是
//     优先强星,这个代理在物理上站得住,而且不依赖任何跨星座编号。
//   GSA 仍然有用 —— PDOP/VDOP/定点类型照拿(那三个是句级字段,不涉及重号)。
static float sigmaUere(int* nOut) {
  const int have = nmea::st.cn0N;          // commitCn0() 已按升序排好
  if (have <= 0) { if (nOut) *nOut = 0; return 0.0f; }

  int k = nmea::st.satsUsed;               // 参与定位的星数
  if (k <= 0 || k > have) k = have;
  // ★ v1.14.12:升序数组里"低于可用下限"的星集中在**头部**,先数出可用尾长。
  //   不设这条线时,GSV 里的 6~23 dB 弱星会随着"最强 k 颗"的 k 浮动进进出出,
  //   一颗 6 dB 的星(σ 上限 40 m)就能把 HPL 抬一倍 —— 见 kCn0Usable 的注释。
  int usable = have;
  while (usable > 0 && nmea::st.cn0[have - usable] < kCn0Usable) --usable;
  if (usable >= 4) {                       // 少于 4 颗就不该有解 —— 退回老算法,宁大勿小
    if (k > usable) k = usable;
  }
  double sum = 0.0;
  for (int i = have - k; i < have; ++i) {  // 升序数组的末尾 = 最强的 k 颗
    const float s = sigmaOf(nmea::st.cn0[i]);
    sum += (double)s * s;
  }
  if (nOut) *nOut = k;
  return (float)sqrt(sum / (double)k);
}

// ---------------- ② CN0–仰角模板(2 参数递推最小二乘 RLS)----------------
//  模型:CN0 ≈ a + b·sin(el)。选 sin(el) 而不是 el 本身,是因为穿过大气层的
//  斜路径长度 ∝ 1/sin(el) —— 用 sin 恰好把"路径越长、衰减越大"这件事写进模型。
//  RLS 的三个好处:不需要存历史样本、每拍只做几次乘加、遗忘因子让它自动跟季节/天线变化。
struct Fit {
  float a   = 22.0f;      // 地平线附近的先验值(dB-Hz)
  float b   = 16.0f;      // 天顶增量:22 + 16 = 38 dB-Hz,与实测的开阔天空量级相符
  float p00 = 400.0f, p01 = 0.0f, p11 = 400.0f;   // 协方差初值(大 = 起步快、先信数据)
  bool  seed = false;
};
static Fit fits[nmea::kMaxTalker];

inline float cn0Expect(const Fit& f, float elDeg) {
  return f.a + f.b * sinf(elDeg * 3.14159265f / 180.0f);
}

// 稳健化:残差超过 12 dB 的样本**不参与拟合** —— 否则一颗真的被多径抬高的星
// 会把自己"学"成正常,检测器就把自己的证据吃掉了(这是自适应检测器的经典陷阱)。
inline void fitUpdate(Fit& f, float elDeg, float y) {
  const float x    = sinf(elDeg * 3.14159265f / 180.0f);
  const float pred = f.a + f.b * x;
  if (f.seed && fabsf(y - pred) > 12.0f) return;

  const float s0  = f.p00 + f.p01 * x;
  const float s1  = f.p01 + f.p11 * x;
  const float den = kMpForget + s0 + s1 * x;
  if (den <= 1e-6f) return;
  const float k0 = s0 / den, k1 = s1 / den;
  const float e  = y - pred;
  f.a += k0 * e;
  f.b += k1 * e;

  const float q00 = f.p00 - k0 * s0, q01 = f.p01 - k0 * s1;
  const float q11 = f.p11 - k1 * s1;
  f.p00 = q00 / kMpForget; f.p01 = q01 / kMpForget;
  f.p11 = q11 / kMpForget;
  f.seed = true;
}

// ---------------- 主推进:1 Hz ----------------
// CUSUM 的滤波器状态从 tick() 的局部 static 提到命名空间级 —— 因为
// ★ v1.9.0 resetBaseline() 要在**换基准**那一刻把它们清掉,函数外的代码
//   访问不到局部 static。`static` 在此处表示内部链接,单文件里等价于私有。
static float    sOffFilt  = 0;     // off 的一阶低通(τ = 20 s)
static float    sMu       = 0;     // CUSUM 的慢基线(τ = 5.5 min)
static bool     sFiltInit = false;
static uint32_t sWarmSince = 0;    // 预热期起点,见 kCusumWarmMs

void resetBaseline() {
  sFiltInit = false; sOffFilt = 0; sMu = 0; sWarmSince = 0;
  g.cusum = 0; g.gated = false; g.slow = false;
}

void tick(float off) {
  const uint32_t now = millis();
  static uint32_t lastMs = 0, hplSince = 0, hplOkSince = 0;

  // 换信源/清统计时 nmea 会把 talkerN 归零 —— 模板跟着重置,
  // 否则上一个场景学到的 a/b 会套到新场地上。
  if (nmea::talkerN == 0)
    for (int i = 0; i < nmea::kMaxTalker; ++i) fits[i] = Fit();

  if (lastMs != 0 && (now - lastMs) < 1000) return;
  lastMs = now;

  // ---- ① σ 与保护级 ----
  int n = 0;
  const float sig = sigmaUere(&n);
  g.sigma = sig;
  g.nSig  = n;

  if (nmea::st.fixValid && n >= 4 && nmea::st.hdop > 0.05f) {
    g.hpl   = kHplK * nmea::st.hdop * sig;
    g.vpl   = (nmea::st.vdop > 0.05f) ? kHplK * nmea::st.vdop * sig : 0.0f;
    g.valid = true;
  } else {
    g.hpl = 0; g.vpl = 0; g.valid = false;
  }

  // ---- ② HPL > AL 的迟滞(与判据同一组时间常数,★ v1.10.0 起都读 tune)----
  const bool over = g.valid && (g.hpl > tune::alertM());
  if (over) { if (hplSince == 0) hplSince = now; hplOkSince = 0; }
  else      { if (hplOkSince == 0) hplOkSince = now; hplSince = 0; }

  if (!g.hplBad) { if (over && hplSince && (now - hplSince >= tune::holdMs())) g.hplBad = true; }
  else           { if (!over && hplOkSince && (now - hplOkSince >= tune::recoverMs())) g.hplBad = false; }

  // ---- ③ CUSUM:单侧、向上 ----
  //  off 是**距离**(恒 ≥ 0),所以"往下漂"没有意义 —— 只做上侧这一条,别装成双侧。
  //  两级时间常数各司其职:
  //    offFilt(τ=20 s) 压噪声;mu(τ=5.5 min) 记住"平时在哪儿";
  //    两者之差才是"漂",差值减去允许起伏 k 后逐拍累积。
  if (judge::baseSet && nmea::st.fixValid) {
    if (!sFiltInit) {
      sOffFilt = off;
      // ★ v1.13.1 重启失忆补丁(2026-10-24 阳台实测):开机时 off 已过绝对闸的话,
      //   μ 锚在基准(0),不能再跟着 off 走 —— 否则 μ 先站上 11m、dev 恒 0,
      //   检测器对"开机即偏"永久失明(实证:15:42 重启后 off 11.7m 全程 INTEG-OK,
      //   事件 #204/#205;回放 tools/重启失忆-回放对比.py 三情景全绿)。
      //   off < 闸值时 μ=off,与 v1.13.0 完全一致 —— v1.9.0 的"3m 假漂"预热治法不变。
      //   ★ v1.14.10:闸 8→15 m,盲区随之上移 —— 开机即偏 <15 m 不再触发判据,
      //     这是为"小尺度多径常态偏差 5~11 m"付的代价,现场需知情。
      sMu = (off < kCusumMinM) ? off : 0.0f;
      sFiltInit = true;
      sWarmSince = now; g.cusum = 0; g.gated = false; g.slow = false;
    }
    sOffFilt += kCusumAlpha * (off - sOffFilt);
    const float dev = sOffFilt - sMu;
    if ((now - sWarmSince) < kCusumWarmMs) {
      // 预热期:μ 快追,统计量锁 0(理由见 kCusumWarmMs 的注释)
      // ★ v1.13.1:快追加同一道闸 —— off 已过闸值时不吸收,否则预热 90s 就把
      //   大偏移吃进基线,补丁①白做。两道闸合起来:预热结束即由 CUSUM 如实点亮。
      if (sOffFilt < kCusumMinM) sMu += kCusumWarmA * dev;
      g.cusum = 0;
      g.gated = (sOffFilt <= kCusumMinM);   // ★ v1.14.12:预热期也如实报告闸状态
      g.slow  = false;
    } else {
      sMu += kCusumMuA * dev;
      // ★ v1.14.12:统计量与绝对闸**同侧** —— 闸拦住判决,也拦住累积(理由见上面
      //   "闸下回落 + 上限"段)。过闸后封顶在 3×H,保证屏上永远看得到"涨/落"。
      if (sOffFilt <= kCusumMinM) {
        g.cusum = fmaxf(0.0f, g.cusum - kCusumSDecay);
        g.gated = true;
        g.slow  = false;
      } else {
        g.cusum = fminf(kCusumSMax, fmaxf(0.0f, g.cusum + dev - kCusumSlack));
        g.gated = false;
        g.slow  = (g.cusum > kCusumH);
      }
    }
  } else {
    sFiltInit = false; sOffFilt = 0; sMu = 0; sWarmSince = 0;
    g.cusum = 0; g.gated = false; g.slow = false;
  }

  // ---- ④ 多径:先更新模板,再算残差 ----
  //  两遍走,是刻意的:如果把"更新"和"判定"混在一遍里,同一拍里先被更新的星
  //  会影响后面的判定顺序 —— 结果和遍历顺序有关,那就不是算法了。
  for (int ti = 0; ti < nmea::talkerN; ++ti) {
    const nmea::Talker& t = nmea::talkers[ti];
    for (int si = 0; si < t.satN; ++si) {
      const nmea::SatFix& f = t.sat[si];
      if (f.cn0 < 15 || f.el < 0) continue;
      fitUpdate(fits[ti], (float)f.el, (float)f.cn0);
    }
  }

  g.mpN = 0; g.mpMax = 0; g.mpPrn = 0; g.mpEl = -1;
  for (int ti = 0; ti < nmea::talkerN; ++ti) {
    const nmea::Talker& t = nmea::talkers[ti];
    if (!fits[ti].seed) continue;
    for (int si = 0; si < t.satN; ++si) {
      const nmea::SatFix& f = t.sat[si];
      if (f.cn0 == 0 || f.el < 0 || f.el > kMpMaxElDeg) continue;
      const float res = (float)f.cn0 - cn0Expect(fits[ti], (float)f.el);
      if (res <= tune::mpThrDb()) continue;      // ★ v1.10.0:阈值改从 tune 读(默认仍 10 dB)
      ++g.mpN;
      if (res > g.mpMax) { g.mpMax = res; g.mpPrn = f.prn; g.mpEl = f.el; }
    }
  }
}

// 这四个**不加 inline**:它们在前置声明里是普通声明,定义处再补 inline 会让
// "同一实体的声明必须一致"这条规则心里没底。函数体各一行,不在乎那点调用开销。
bool  hplBadOn() { return g.hplBad; }
bool  slowOn()   { return g.slow; }
bool  valid()    { return g.valid; }
float hpl()      { return g.hpl; }
// ★ v1.13.0(B4):判据侧要用,补两个只读口子。只暴露"数量"和"强度",
//   不暴露 mpPrn/mpEl —— 那两个是显示用的,判据不需要,暴露了会诱使后来的人
//   拿 PRN 做判断(跨星座重号,不可靠)。
int   mpCount()  { return g.mpN; }
float mpPeak()   { return g.mpMax; }

}  // namespace integ

// ============================================================================
//  状态色唯一出处 —— 屏(星空图外圈光环 + 数据条状态词)和板载灯都从这里取色,
//  三处想不同色都难。以前屏、灯各写一份 switch,改配色漏一处就不同步,已合并。
//  ★★ v1.7.0:输入从 judge::Level 改成**状态词 phrase::PhraseId**。
//    为什么必须按词取色、不能按 Level:同一个 LV_LOST 对应两个不同的词 ——
//      开机从未定位 = NO-DATA(灰,正常等星) / 定位过又丢 = LOST(红闪,真的丢了)。
//    按 Level 取色会让"刚开机还没定位"红屏闪,看着像设备坏了。
//    函数名保持不变、只换第一个参数类型 —— 编译器会把所有调用点全报出来,漏不掉。
//  blink:红闪相位(仅 LOST 用,1 = 灭相,用页底色画)。
// ============================================================================
inline uint16_t statusColor565(phrase::PhraseId ph, uint8_t blink) {
  switch (ph) {
    case phrase::PH_OK:       return C_ST_OK;                      // #37D67A 绿 NORMAL
    case phrase::PH_RECOVER:  return C_ST_OK;                      // #37D67A 绿 恢复正常(事件日志专用)
    case phrase::PH_DEGRADED: return C_ST_DEG;                     // #F2C037 黄 DEGRADED
    case phrase::PH_SIGBAD:   return C_ST_SIG;                     // #F2792B 橙 SIG-BAD
    case phrase::PH_POSBAD:   return C_ST_POS;                     // #FF4D4D 红 POS-BAD
    case phrase::PH_LOST:     return blink ? CLR_PAPER : C_ST_POS; // 红闪 LOST(灭相 = 页底色)
    case phrase::PH_HPLHIGH:  return C_ST_HPL;                     // 紫 HPL-HIGH(★ v1.9.0)
    case phrase::PH_DRIFT:    return C_ST_DRIFT;                   // 琥珀 DRIFT(★ v1.10.1)
    case phrase::PH_NOBASE:   return C_ST_GREY;                    // ★ v1.12.0(A1):灰 = 还没到能判断的状态
    case phrase::PH_WAIT:                                          // 等待数据 -> 与 SEARCH 同档
    case phrase::PH_SEARCH:   return C_ST_GREY;                    // #7A8794 灰 SEARCH
    case phrase::PH_NODATA:   return C_ST_GREY;                    // #7A8794 灰 NO-DATA
    default:                  return C_ST_GREY;
  }
}

// ============================================================================
//  灯:板载 WS2812 彩色灯,与屏上色带同一套判据
//  远处看灯、近处看屏 —— 两颗指示冗余,现场哪个角度都能看清。
// ============================================================================
namespace led {

#if !LED_USE_BUILTIN
static Adafruit_NeoPixel strip(1, LED_RGB_PIN, NEO_GRB + NEO_KHZ800);
#endif

static uint32_t lastPacked = 0xFFFFFFFF;

// 把颜色推给一颗 WS2812。
// 两条驱动路径都吃 uint8_t 的 R/G/B,亮度统一在这里按 LED_BRIGHT 缩放
// (核心内置函数没有"亮度"参数,只能自己缩;Adafruit 那条路就不重复 setBrightness 了,
//  否则会被缩两次,灯暗得看不见)。
//
// 色序:核心内置的 rgbLedWrite() 默认按 GRB 发(WS2812B 的标准色序),绝大多数板子正确。
//       若你的灯红绿反了,改用 rgbLedWriteOrdered(pin, LED_COLOR_ORDER_RGB, r, g, b);
inline void writePix(uint8_t pin, uint8_t r, uint8_t g, uint8_t b) {
  r = (uint8_t)((uint16_t)r * LED_BRIGHT / 255);
  g = (uint8_t)((uint16_t)g * LED_BRIGHT / 255);
  b = (uint8_t)((uint16_t)b * LED_BRIGHT / 255);
#if LED_USE_BUILTIN
  #if defined(ESP_ARDUINO_VERSION_MAJOR) && (ESP_ARDUINO_VERSION_MAJOR >= 3)
    rgbLedWrite(pin, r, g, b);          // 核心 3.x:官方推荐名
  #else
    neopixelWrite(pin, r, g, b);        // 核心 2.x:同一功能,旧名(3.x 仍在,仅标 deprecated)
  #endif
#else
  (void)pin;                            // Adafruit 路径只有一颗灯,脚位绑在对象里
  strip.setPixelColor(0, strip.Color(r, g, b));
  strip.show();
#endif
}

inline void setColor(uint8_t r, uint8_t g, uint8_t b) {
  uint32_t packed = ((uint32_t)r << 16) | ((uint32_t)g << 8) | b;
  if (packed == lastPacked) return;          // 颜色没变就别动硬件
  lastPacked = packed;
  writePix((uint8_t)LED_RGB_PIN, r, g, b);
}

inline void begin() {
#if !LED_USE_BUILTIN
  strip.begin();
#endif
  lastPacked = 0xFFFFFFFF;
  writePix((uint8_t)LED_RGB_PIN, 0, 0, 0);   // 上电先灭,等判据出来再亮
}

inline void apply() {
  // ★ v1.12.0(A14):熄屏时灯一并灭(kLedFollowScreen,用户定"熄屏期间不表达状态")。
  //   想改成"灯常亮、屏可灭",把配置区 kLedFollowScreen 改 false 即可。
  if (kLedFollowScreen && gScreenOff) { setColor(0, 0, 0); return; }
  // 与屏取同一个 statusColor565() —— 灯和星空图光环永远同色(565 展开成 888 而已)
  // ★ v1.7.0:改传**状态词**(原来传 judge::Level)—— 与光圈、数据条状态词同一入口,
  //   灯也随 5 档换色:SEARCH/NO-DATA 档灯是**灰**,不再是原来的蓝。
  uint8_t  blink = (millis() / 300) % 2;
  uint16_t c     = statusColor565(judge::res.ph, blink);
  setColor((uint8_t)((c >> 8) & 0xF8),
           (uint8_t)((c >> 3) & 0xFC),
           (uint8_t)((c << 3) & 0xF8));
}

// ★ 2026-10-11 删除 led::probe() 与串口命令 'l' —— 用户定的。
//   它当年只是"找灯脚"的一次性排查工具:候选脚挨个点 1 秒红,看哪个亮就把
//   LED_RGB_PIN 改成它。2026-09-28 已经实测确认本板灯脚 = 48(候选表第一个),
//   任务完成;而且它内部是阻塞 delay,一敲命令画面就停约 8 秒,演示现场容易被
//   误判成"死机"。留着只有风险,故连同候选脚数组一起删除。
//   (将来真换了板子、灯不亮,把 LED_RGB_PIN 改成新脚重烧即可,不需要这个探针。)

}  // namespace led

// ============================================================================
//  环境温湿度 —— SHT30-D(I2C)
//  台架上为什么要放它:晶振频率会随温度漂,机箱内的温升直接影响授时/定位的长期
//  稳定性。所以"终端自身所处的环境"本来就是这套监测系统该记的一项,不是装饰。
//  驱动直接用核心自带的 Wire —— SHT30 的 I2C 协议很短,不值得为它引入外部库。
// ============================================================================
namespace sht {

static const uint8_t kAddrA = 0x44;    // ADDR 脚接地(模块出厂默认)
static const uint8_t kAddrB = 0x45;    // ADDR 脚接 VCC
static uint8_t       addr   = kAddrA;

static float    tempC      = 0.0f;
static float    rhPct      = 0.0f;
static bool     ok         = false;  // 传感器最近是否读得通(串口报表/诊断用)
static bool     haveVal    = false;  // 是否读到过至少一次好值 —— 显示层只看这个
static bool     stale      = false;  // 数据陈旧:>6 秒没读到新值(屏上变灰提示,不消失)
static uint32_t lastGoodMs = 0;
static uint32_t lastMs     = 0;
static int      failCnt    = 0;      // 连续失败次数(驱动层,用于触发总线恢复)

// SHT30 每 2 字节数据后面跟 1 字节 CRC-8:多项式 0x31,初值 0xFF。
// 不做校验也能出数,但线一长、杜邦头一松就会读出垃圾值还看不出来,所以照手册做。
inline uint8_t crc8(const uint8_t* d, int n) {
  uint8_t c = 0xFF;
  for (int i = 0; i < n; ++i) {
    c ^= d[i];
    for (int b = 0; b < 8; ++b)
      c = (c & 0x80) ? (uint8_t)((c << 1) ^ 0x31) : (uint8_t)(c << 1);
  }
  return c;
}

inline bool addrAlive(uint8_t a) {          // 一次空写:只为看从机有没有 ACK
  Wire.beginTransmission(a);
  return Wire.endTransmission() == 0;
}

inline void busRecover() {
  // I2C 总线卡死恢复:从机把 SDA 摁低不放时,标准救法是手动给 SCL 打 9 个时钟,
  // 让它把没发完的位吐完、自己释放 SDA,然后重新初始化 Wire 控制器。
  // 触发条件在 poll():连续 3 次读取失败时做一次。杜邦线 I2C 出现"时好时坏"多半是它。
  Wire.end();
  pinMode(PIN_SHT_SCL, OUTPUT);
  digitalWrite(PIN_SHT_SCL, HIGH);
  pinMode(PIN_SHT_SDA, INPUT_PULLUP);
  for (int i = 0; i < 9; ++i) {
    digitalWrite(PIN_SHT_SCL, LOW);  delayMicroseconds(5);
    digitalWrite(PIN_SHT_SCL, HIGH); delayMicroseconds(5);
  }
  Wire.begin(PIN_SHT_SDA, PIN_SHT_SCL);
  Wire.setClock(50000);
  Serial.println("[bench] sht30 i2c bus recover");
}

// 单次测量:发命令 -> 等测量完成 -> 读 6 字节(温度 高/低/CRC + 湿度 高/低/CRC)。
// 一次 readOnce() 内部最多试 3 遍:杜邦线+内部上拉的 I2C 偶发 NACK/CRC 错很正常,
// 重试能把单次成功率从"看运气"拉到接近 100%。3 遍都错才向上报失败。
inline bool readOnce() {
  for (int attempt = 0; attempt < 3; ++attempt) {
    if (attempt) delay(5);                   // 失败后缓一下再试,给总线喘口气

    Wire.beginTransmission(addr);
    Wire.write(0x24); Wire.write(0x00);      // 高重复性、无时钟拉伸
    if (Wire.endTransmission() != 0) continue;

    delay(20);                                 // 高重复性典型 15ms。2 秒才走一次,这 20ms 无所谓

    if (Wire.requestFrom((int)addr, 6) != 6) continue;
    uint8_t d[6];
    for (int i = 0; i < 6; ++i) d[i] = (uint8_t)Wire.read();

    if (crc8(d, 2) != d[2]) continue;
    if (crc8(d + 3, 2) != d[5]) continue;

    // 手册换算:T = -45 + 175 * S_T / 65535      RH = 100 * S_RH / 65535
    uint16_t tRaw = (uint16_t)(((uint16_t)d[0] << 8) | d[1]);
    uint16_t hRaw = (uint16_t)(((uint16_t)d[3] << 8) | d[4]);
    tempC = -45.0f + 175.0f * (float)tRaw / 65535.0f;
    rhPct = 100.0f * (float)hRaw / 65535.0f;
    return true;
  }
  return false;
}

inline void begin() {
  // 必须显式给脚号:S3 的默认 I2C 是 GPIO8/9,而 9 已经被触摸 CS 占了。
  Wire.begin(PIN_SHT_SDA, PIN_SHT_SCL);
  // 50kHz:内部上拉(~45k)+杜邦线的边沿本来就慢,100kHz 是踩线的;
  // 降一半换可靠性。6 字节 @50k 约 2ms,2 秒才读一次,慢这点毫无感。
  Wire.setClock(50000);

  if      (addrAlive(kAddrA)) addr = kAddrA;
  else if (addrAlive(kAddrB)) addr = kAddrB;
  else {
    ok = false;
    Serial.println("[bench] sht30 not found on 0x44/0x45 -- 屏上温湿度显示 --");
    return;
  }

  ok = readOnce();
  if (ok) { haveVal = true; lastGoodMs = millis(); }
  Serial.printf("[bench] sht30 @0x%02X  %.1fC  %.0f%%RH  (%s)\n",
                addr, tempC, rhPct, ok ? "ok" : "read failed");
}

inline void poll() {
  uint32_t now = millis();
  if (now - lastMs < 2000) return;   // 温湿度变化慢,2 秒一次足够,不占主循环
  lastMs = now;

  if (readOnce()) {
    failCnt    = 0;
    ok         = true;
    haveVal    = true;
    lastGoodMs = now;
  } else {
    ++failCnt;
    if (failCnt == 3) busRecover();          // 6 秒读不到 -> 大概率总线卡死,救一把
    if (failCnt >= 5) ok = false;            // 串口报表里如实反映"最近读不通"
  }
  // ★ 显示层永远不翻黑:只要 haveVal 为真,屏上一直显示最后一次的好值。
  //   陈旧与否由 stale 时间判据决定(>6 秒没新值),画的时候变灰 —— 是"固定界面元素",
  //   不是"读得到才出现的浮层"。用户看到的应该是常驻的 T/RH,不该闪来闪去。
  stale = haveVal && (now - lastGoodMs > 6000);
}

inline void pollNow() {              // 串口 t:不等那 2 秒节拍,立刻读一次(现场查接线用)
  lastMs = millis();
  if (readOnce()) {
    failCnt = 0; ok = true; haveVal = true; lastGoodMs = millis();
  } else {
    ++failCnt;
  }
}

}  // namespace sht

// ============================================================================
//  第 4 段:屏显示
//  上  状态带  y 0..99     —— 状态色大色块 + 居中 32x32 中文状态词
//  边  状态框  全屏 3px    —— 左右下三边同状态色,拉开可视距离
//  中  报文窗  y 103..242  —— 最近几句 NMEA 原样滚动(自动折行,句子看全) 白底黑字
//  下  指标区  y 235..319  —— 星数 / HDOP / C/N0 中位数 / 偏离基准距离 / IP  白底黑字
//          (★ v1.5.15:顶边 245 -> 235,报文窗让出一行,最底多一行 IP)
//  配色:色带与边框 = 状态色(绿=正常 / 蓝=搜星·等待 / 红=异常 / 红闪=丢失),
//        框内一律白纸黑字 —— 像一张贴在状态灯上的白纸。
// ============================================================================
// ============================================================================
//  按星座分色 —— 主界面星空图与第二界面所有图**共用这一份**
//  (★ v1.7.0:从 namespace charts 里提出来放全局;主界面现在也画星空,两边必须同色)
// ============================================================================
inline uint16_t constellationColor(const char* id) {
  if (id[0] == 'G' && id[1] == 'P') return C_GPS;   // GPS             荧光绿
  if (id[0] == 'G' && id[1] == 'B') return C_BDS;   // 北斗(新标准)     青蓝
  if (id[0] == 'B' && id[1] == 'D') return C_BDS;   // 北斗(老写法)     同上
  return CLR_INK2;                                  // GLONASS / Galileo 用灰,不抢视觉
}

static void heapDump(const char* tag);   // 定义在下面(disp::ensureMain 要用)

// 前置声明:WiFi 台账的只读出口(定义在下面的 namespace wifi10 里)。
// ★ 为什么要单独前置 —— 单文件 .ino 的自动原型**只覆盖函数、不覆盖 namespace 成员**;
//   而 WiFi 信息卡在 disp 段(文件靠前)、wifi10 段在文件靠后,不前置编不过。
//   做成函数而不是"直接引用 wifi10::cnt / wifi10::kMax":那两个名字这里根本看不见,
//   若在前置声明里重复写一遍 kMax 就成了**两处手抄同一个常量** —— 正是本项目最忌讳的错。
namespace wifi10 { inline int savedCount(); inline int capacity(); }

// ---- 日期工具(★ v1.14.0:从 disp 段搬到全局 —— clk 的跨日进位也要用;
//      static 函数同属一个编译单元,disp 段照旧能调,行为不变) ----
static bool isLeapYear(int y) { return (y % 4 == 0 && y % 100 != 0) || (y % 400 == 0); }
static int  daysInMonth(int y, int m) {
  static const int dm[12] = {31,28,31,30,31,30,31,31,30,31,30,31};
  if (m == 2 && isLeapYear(y)) return 29;
  return dm[m - 1];
}

// ============================================================================
//  第 3.6 段:DS3231 RTC(I2C 0x68)+ 统一时间出口 clk  ★ v1.14.0
//
//  为什么要有这一段:现在的"现在几点"只有 GNSS 一个来源(ZDA 报文),
//  GNSS 一失锁,时间戳就断流 —— 干扰事件"何时发生"反而记不下来。
//  DS3231 带电池、断主电也走时,把这段时间撑住。**方向永远是 GNSS 教它**,
//  不是它替代 GNSS。
//
//  三条不可越的线(写在这里防以后改坏):
//   ① SQW 走独立 GPIO15,**绝不与 PPS(GPIO16)合流**,也绝不顶替 PPS。
//      理由:合流 = 让备份顶掉尺子。PPS 丢了中断里照样每秒有沿,
//      检测器就永远"看得到秒",这正是"哨兵从不报警"那条死法的翻版。
//   ② 时间的锚点只用 ZDA 的秒,**不用 PPS**。PPS 是我们要监视的对象;
//      拿它当锚,它被欺骗时时间会一起错,而对照检测看到的却是"两边一致"。
//   ③ 校准写 DS3231 时,**秒已经对就不写秒寄存器**。DS3231 写秒会复位
//      内部 1 Hz 分频链,SQW 相位跟着跳 —— 相位差曲线就废了。
//      2 ppm 的钟 60 s 只漂 0.12 ms,秒根本不会错,所以稳态下永远是软写。
//
//  精度诚实说明:DS3231 = ±2 ppm(≈ 每小时 7.2 ms、每天 173 ms)。
//  它撑得起"秒数不断档 + ms 级不确定度",撑不起"PPS 级保持"。
//  想做到后者要 OCXO,不是这颗芯片的事。
// ============================================================================
namespace ds3231 {

static const uint8_t kAddr = 0x68;   // ZS-042 模块固定地址(SQW/INT 不占地址位)

static bool     present = false;     // I2C 上到底有没有这颗芯片(开机探一次)
static bool     valid   = false;     // 里面的时间可信(没掉过电 + 年份合理)
static bool     osf     = false;     // OSF 振荡器停标志 = 掉过电,时间不可信
static uint32_t lastMs  = 0;         // 主循环节流(1 s 读一次时间)
static uint32_t lastTempMs = 0;
static int      failCnt = 0;
static uint32_t rdErr   = 0;         // 读失败累计(诊断;0 才叫"总线干净")
static uint32_t wrCnt   = 0;         // 校准写入总次数
static uint32_t wrHard  = 0;         // 其中"连秒一起写"的次数(= SQW 相位被打断的次数)
static float    tempC   = 0.0f;
static bool     tempOk  = false;

// SQW 1 Hz 中断(独立脚,永不与 PPS 合流)
static volatile uint32_t sqwEdgeUs = 0;
static volatile uint32_t sqwCount  = 0;

// ★ IRAM_ATTR 的理由与 pps::onEdge 逐字相同:写 NVS 期间 flash cache 被禁,
//   此时来一个中断、指令还在 flash 里 -> 直接 panic。本 ISR 只摸 .bss 里的变量。
void IRAM_ATTR onSqw() {
  sqwEdgeUs = micros();
  sqwCount  = sqwCount + 1;          // volatile 上不用 ++(C++20 起弃用)
}

inline uint8_t bcd2bin(uint8_t b) { return (uint8_t)((b >> 4) * 10 + (b & 0x0F)); }
inline uint8_t bin2bcd(uint8_t b) { return (uint8_t)(((b / 10) << 4) | (b % 10)); }

// 一次读 0x00~0x06 共 7 字节(秒/分/时/星期/日期/月/年),地址自动递增。
inline bool readTime(int& Y, int& Mo, int& D, int& h, int& mi, int& s) {
  Wire.beginTransmission(kAddr);
  Wire.write((uint8_t)0x00);
  if (Wire.endTransmission() != 0) { ++rdErr; return false; }
  if (Wire.requestFrom((int)kAddr, 7) != 7) { ++rdErr; return false; }
  uint8_t d[7];
  for (int i = 0; i < 7; ++i) d[i] = (uint8_t)Wire.read();

  s  = bcd2bin(d[0] & 0x7F);                 // bit7 是保留位
  mi = bcd2bin(d[1]);
  // 时:bit6 = 12/24 小时制,bit5 = AM/PM。模块出厂是 24 小时制,但别人
  // 用 Arduino 的 RTClib 设过时间就可能变成 12 小时制 —— 两种都认。
  if (d[2] & 0x40) {
    h = bcd2bin(d[2] & 0x1F);
    if (d[2] & 0x20) h = (h % 12) + 12;      // PM
    else             h = h % 12;             // AM:12 -> 0
  } else {
    h = bcd2bin(d[2] & 0x3F);
  }
  D  = bcd2bin(d[4]);
  Mo = bcd2bin(d[5] & 0x1F);
  Y  = 2000 + bcd2bin(d[6]) + ((d[5] & 0x80) ? 100 : 0);   // bit7 = 世纪

  // 读出来的东西先做范围自检 —— 掉电途中读到的可能是 0x00 或 0xFF 的垃圾。
  if (Mo < 1 || Mo > 12 || D < 1 || D > 31 || h > 23 || mi > 59 || s > 59) {
    ++rdErr; return false;
  }
  return true;
}

// 写时间。withSec = false 时**跳过秒寄存器**,从 0x01 起写 —— 这是整套
// 相位差观测能不能用的关键(见文件头那三条线里的第③条)。
inline bool writeTime(int Y, int Mo, int D, int h, int mi, int s, bool withSec) {
  Wire.beginTransmission(kAddr);
  Wire.write((uint8_t)(withSec ? 0x00 : 0x01));
  if (withSec) Wire.write(bin2bcd((uint8_t)s));
  Wire.write(bin2bcd((uint8_t)mi));
  Wire.write(bin2bcd((uint8_t)h));      // bit6=0 即 24 小时制
  Wire.write((uint8_t)1);               // 星期:本项目不用,写 1
  Wire.write(bin2bcd((uint8_t)D));
  uint8_t mo = bin2bcd((uint8_t)Mo);
  if (Y >= 2100) mo |= 0x80;            // 世纪位
  Wire.write(mo);
  Wire.write(bin2bcd((uint8_t)(Y % 100)));
  if (Wire.endTransmission() != 0) { ++rdErr; return false; }
  ++wrCnt;
  if (withSec) ++wrHard;
  return true;
}

// 温度:0x11 高 8 位(有符号整数)+ 0x12 高 2 位(0.25℃ 步进)。
// ★ 芯片自己每 64 s 才更新一次这个寄存器 —— 读太快没有新值,所以限速。
inline bool readTemp(float& t) {
  Wire.beginTransmission(kAddr);
  Wire.write((uint8_t)0x11);
  if (Wire.endTransmission() != 0) return false;
  if (Wire.requestFrom((int)kAddr, 2) != 2) return false;
  const int8_t  hi = (int8_t)(uint8_t)Wire.read();
  const uint8_t lo = (uint8_t)Wire.read();
  t = (float)hi + (float)(lo >> 6) * 0.25f;
  return true;
}

inline void begin() {
  Wire.beginTransmission(kAddr);
  if (Wire.endTransmission() != 0) {
    Serial.println("[bench] ds3231 not found on 0x68 -- 时间源只剩 GNSS(断了就断流)");
    present = false;
    return;
  }
  present = true;

  // SQW 1 Hz -> GPIO15 上升沿中断(与 PPS 分开两个脚,见文件头第①条)
  pinMode(PIN_DS3231_SQW, INPUT_PULLDOWN);   // 拔线后悬空不被噪声触发(同 PPS 的处理)
  attachInterrupt(digitalPinToInterrupt(PIN_DS3231_SQW), onSqw, RISING);

  // 状态寄存器 0x0F:bit7 = OSF(振荡器停过)。置位 = 电池掉过/首次上电,
  // 里面的时间不可信 —— 只能等 GNSS 来校。清掉标志,时间值仍就不可信。
  Wire.beginTransmission(kAddr);
  Wire.write((uint8_t)0x0F);
  if (Wire.endTransmission() == 0 && Wire.requestFrom((int)kAddr, 1) == 1) {
    const uint8_t st = (uint8_t)Wire.read();
    osf = (st & 0x80) != 0;
    if (osf) {
      Wire.beginTransmission(kAddr);
      Wire.write((uint8_t)0x0F); Wire.write((uint8_t)0x00);
      Wire.endTransmission();
    }
  }

  int Y, Mo, D, h, mi, s;
  const bool got = readTime(Y, Mo, D, h, mi, s);
  tempOk = readTemp(tempC);
  // 年份闸:出厂模块是 2000-01-01。2000~2023 一律当"没设过"。
  valid = got && !osf && Y >= 2024;
  if (got) {
    Serial.printf("[bench] ds3231 @0x68  %04d-%02d-%02d %02d:%02d:%02d UTC  %.2fC  osf %d  %s\n",
                  Y, Mo, D, h, mi, s, tempOk ? tempC : -99.0f, osf ? 1 : 0,
                  valid ? "time ok" : "time UNTRUSTED (等 GNSS 校)");
  } else {
    Serial.println("[bench] ds3231 @0x68  present but read failed");
  }
}

inline void poll() {
  if (!present) return;
  const uint32_t now = millis();
  if (now - lastMs < 1000u) return;
  lastMs = now;

  int Y, Mo, D, h, mi, s;
  if (readTime(Y, Mo, D, h, mi, s)) {
    failCnt = 0;
    // 时间从"不可信"变可信的唯一途径:有人给它写过一个像样的时间
    // (GNSS 校准会写,用户在别的工具里设过也算)。年份闸挡住出厂默认。
    if (!valid && Y >= 2024) valid = true;
  } else {
    if (++failCnt >= 3) valid = false;   // 连续 3 秒读不通 -> 当作不可用
  }

  // 温度:芯片 64 s 才更新一次,10 s 读一次已经很勤快了
  if (now - lastTempMs >= 10000u) {
    lastTempMs = now;
    float t;
    if (readTemp(t)) { tempC = t; tempOk = true; }
  }
}

}  // namespace ds3231

// ----------------------------------------------------------------------------
//  clk —— 全项目**唯一**的"现在几点"
//  以前这件事散在 nmea::st 里(ZDA 原文),现在收口到这里:
//  谁要时间都问 clk,不再各自去读报文。仲裁规则一句话:
//    GNSS UTC 新鲜 -> GNSS 主;否则 DS3231 主(标 HOLDOVER);都没有 -> 不可信。
// ----------------------------------------------------------------------------
namespace clk {

enum Src : uint8_t { SRC_NONE = 0, SRC_GNSS = 1, SRC_RTC = 2 };

static const uint32_t kSyncMs = 60000u;   // 多久把 GNSS 时间写回 DS3231 一次

static Src      src        = SRC_NONE;
static uint32_t anchorMs   = 0;      // 锚点:millis() 那一瞬
static uint32_t anchorSod  = 0;      // 锚点对应的 UTC 当天秒
static int      aY = 2000, aMo = 1, aD = 1;   // 锚点日期
static uint32_t lastSyncMs  = 0;
static bool     syncPending = true;  // 刚接上 GNSS 时立刻校一次
static uint32_t sncOk      = 0;      // 成功写入 DS3231 的次数
static uint32_t phaseResetMs = 0;    // 最近一次硬写打断 SQW 相位的时刻

// GNSS 时间"新鲜"的判据。★ v1.14.0 定稿:必须**定位也有效**才算。
//   只判 ZDA 新不新鲜是不够的 —— 模块失锁后很可能继续吐 ZDA(带最后已知时间),
//   那样我们会一直以为"时间是 GNSS 给的",DS3231 永远轮不上。
//   两个超时都用现成的 TH_STALE_MS(不另起一个数 —— 一个量只许一个真源)。
//   ★ 副作用(是故意的):冷启动还没定位时 fixValid=false -> 时间源先用 RTC,
//     屏上时间行会挂 " RTC" 角标。这正是事实:那段时间确实是钟在撑。
inline bool gnssFresh(uint32_t now) {
  return nmea::st.utcValid && nmea::st.utcMs != 0 && (now - nmea::st.utcMs) < TH_STALE_MS
      && nmea::st.fixValid && nmea::st.fixMs != 0
      && (now - nmea::st.fixMs) <= TH_STALE_MS;
}
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
