raisemanface/gnss-signal-monitor/(commit log)

2026-10-18 初始提交：GNSS 信号监测台架（S3 面板 + C3 命令板）
    - S3 v1.10.2 / C3 v1.2.5，链路协议 P2
    - 完好性监测：HPL / CUSUM 慢漂移 / CNL 多径三类判据
    - 文档：接线表、台架搭建、设计规则
    - prebuilt：两块板的免编译烧录包
    许可证 Apache-2.0
    [partitions.csv]
2026-10-18 添加 .gitattributes：统一换行符、bin 按二进制
2026-10-22 升级到 v1.10.3：S3 官方引脚重排；新增英文 README；接线表 v2.2
2026-10-22 C3 v1.2.6：板载 RGB 链路节拍呼吸灯（青蓝呼吸/断链红常亮）
2026-10-23 S3 v1.10.6（评审整改三批合并：A批6处 + N1/O1 补充 + 观感统一：长按时长统一/进度条键顶/按压动画）+ C3 v1.2.7（EVT 状态收口）；双板 prebuilt 更新（已烧录验证）
2026-10-24 S3 v1.13.1（A批+B批归因+重启失忆补丁+GPIO7背光+静默唤醒）+ C3 v1.2.10（心跳4s+呼吸灯4s）；双板 prebuilt 更新（已烧录验证）
2026-10-30 S3 v1.14.5（DS3231 时钟 / obs.csv 落盘 / pdo 板上判据 / UDP 推流）+ 接线表 v2.4
    S3 台架固件 v1.13.1 → v1.14.5，六个版本连续推进：
    v1.14.0 DS3231 RTC 接入，主备时间仲裁（GNSS 优先、RTC 兜底），
    SQW 1Hz 走 GPIO15 做独立对照，严禁顶替或合流 PPS
    v1.14.1 /obs.csv 落 LittleFS（分区 8.875 MB，按 8 h ≈ 0.6 MB 估算可挂多日）
    v1.14.2 修 prefs.end() 误关共用句柄导致 NVS 静默失灵（写不进去还不报错）
    v1.14.3 事件日志 off 哨兵改为 -3000，避免与合法编码值撞车
    v1.14.4 pdo 频率判据从"只记录、人工看斜率"改为板上自动判：
    每 60 s 采 pdo + 温度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
2026-10-30 S3 v1.14.6 / C3 v1.2.11: WiFi 图标改为按 RSSI 分档
    原来两板的信号图标只判 WiFi.status() == WL_CONNECTED, 4 段弧恒定全画 ——
    信号从 -50 掉到 -85 dBm 仍显示满格, 图标不表达强弱。
    改为:
    - 档位 1..4 段, 门限 -50 / -65 / -75 (-85 以下但仍连接 -> 1 段)
    - 3 dB 滞回: 升档 >= 门限+3, 降档 < 门限-3
    - EMA 平滑 alpha=1/5 (1 Hz 下 tau 约 5 s) —— 实测这付天线瞬时 RSSI
    在 -62~-69 之间跳 7 dB, 只做滞回 40 s 内仍跳 3 次; 加平滑后 60 s 零跳格
    - 未点亮段擦成块底色 (22x11 的图标里画暗弧会糊成一坨)
    - 未连接仍画 4 段灰, 保持原有的 "灰满格 = 无连接" 语义
    两板门限/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
2026-10-30 feat(pushw): 推流加 TCP 传输，UDP 保留（v1.14.7）
    动机：UDP 丢一帧就是永失 —— 2026-10-30 晚 21:41~21:45 与 22:00 两段爆发，
    OBS/STA 成对丢过 8 拍（整拍 802.11 帧没上来）。
    先量后改：60 s 采样板发 12 / 收 12、零丢失；整晚 gaps.log 26 条里 14 条是
    "板子重启被当成丢包"的假警（看板侧已一并修掉）。真丢包约 1.8%。
    实现要点（三条，缺一条就会拖坏采集）：
    1. sendLine() 在 TCP 模式只入队：6 KB 环形缓冲，行尾补 '\n' 分帧；
    满了丢一行并计 nDrop，绝不等待。
    2. connect/write 全部放在 core 0 的独立任务里，主循环永不碰 socket。
    原因：GNS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
2026-11-01 feat: S3 v1.14.13 / C3 v1.2.13 —— 波特率自寻、CUSUM 上推流、WiFi 巡连自愈
    S3 (v1.14.8 → v1.14.13):
    - v1.14.8 GNSS 串口 9600 → 115200 自动协商
    - v1.14.9 CUSUM 状态并入 UDP 推流
    - v1.14.10 CUSUM 绝对闸 8 → 15 m
    - v1.14.11 无有效报文时自动巡波特率 + 原始字节探针(y)
    - v1.14.12 CUSUM 闸下回落并封顶 3H；σ 统计加 25 dB-Hz 可用下限；屏上双条按比值分级
    - v1.14.13 巡台账失败后台自动重试(30s 起、连败 3 轮转 5min)，失败仍关射频还内存
    C3 (v1.2.11 → v1.2.13):
    - v1.2.12 WiFi 图标外观与 S3 对齐
    - v1.2.13 断线自动重连 + 掉线原因上屏
    其它:
    - prebuilt 双板 bin 更新到当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
2026-11-01 feat(dashboard): 纳入 PC 端实时看板（八面板 + C/N0 声化）
    - tools/dashboard：零依赖 HTTP/UDP 服务、单页前端、Chart.js 本地打包（MIT）
    - 声化：02 天球点选卫星，音高随各自 C/N0，音变才敲击（钟/玻璃/木，最多 8 声部）
    - 启动脚本改用脚本目录定位（%~dp0），换机器/换盘符无需改路径
    - verify 脚本的浏览器路径与产物目录由 _env.js 统一，EDGE_PATH / OUT_DIR 可覆盖
    - 默认输出目录：工作区内仍写 docs/实验数据/dashboard，单独使用写 ./out
    - README / README_EN 增补看板章节与目录说明
2026-11-01 fix(dashboard): 08 面板不再把已落地的旧点选算作在唱
    现象：关掉看板再打开，08 仍报「8 个声部 / AUDIBLE」，而天球上只有 2 颗有光环。
    根因：读数直接用 SON.picked.length，不看这些星此刻是否还在报 C/N0；
    天球光环只为可见星绘制，两边口径不一致。
    修法：
    - 计数改为「在唱/点选」（如 2/8），只把真正在报 C/N0 的星算作声部；
    一颗都没有时报 WAIT 而非 AUDIBLE
    - 收到首帧真实数据后开始计缺席，连续 60 s 无数据则从点选表摘掉并写回存档
    （不在页面加载时立即清，避免一刷新就把点选清光）
    - 点选名额满 8 时先摘掉没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
2026-11-01 docs: README 增加看板实景截图与天球声化动图
    - docs/images：dashboard-hero.png（看板全景，实时数据实拍）、
    sky-sonify.gif（天球点选声化动图，48 帧实采）、sky-picked.png、panel-08.png
    - 中英 README：首图 + 声化一节配图；英雄图注说明室内窗边实测下
    POS-ANOMALY 是完好性监测在正常工作
